yallawalla/SkyPulseIOC/schematic/RLH_04_04_20_PR-SkyPulse_KP.odt

# SW REVISION LEVEL HISTORY / OVERVIEW

SW release | SYS | EC20 | IOC | EM | DL | FSW | | BOOTUTIL PKG | Change request
| | | | | | TX | RX
/ | 0.1.0 | 0.7.0 | 0.11 | 0.6.0 | 0.1.0 | 0.1 | 0.1 | 1.0.0 | Develop. phase (20. 09. 17)
| 0.4.0 | 0.8.0 | 0.13 | 0.6.0 | 0.2.0 | 0.2 | 0.2 | | Develop. phase (27. 03. 18)
| 0.5.7 | 0.8.6 | 0.20 | 0.8.0 | 0.3.0 | 0.2 | 0.2 | | Develop. phase (20. 08. 18)
| 0.6.17 | 0.8.16 | 0.23 | 0.10.0 | 0.4.0 | 0.2 | 0.2 | | Develop. phase (23. 11. 18)
| 0.7.12 | 0.8.19 | 0.26 | 0.11.0 | 0.4.5 | 0.3 | 0.2 | | Develop. phase – release for testing house (18. 03. 19)
| 0.8.57 | 0.8.31 | 0.29 | 0.14.2 | 0.4.13 | 0.3 | 0.2 | | Develop. phase (02. 07. 19)
1.0. | 1.0.1 | 1.0.0 | 1.00 | 1.0.0 | 1.0.0 | 1.0.0 | 1.0.0 | 1.0.2 | Official production release (27. 8. 19)
1.1. | 1.0.3 | 1.0.0 | 1.00 | 1.0.0 | 1.0.0 | 1.0.0 | 1.0.0 | 1.0.2 | I-8674
1.2. | 1.0.4 | 1.0.3 | 1.00 | 1.0.0 | 1.0.0 | 1.0.0 | 1.0.0 | 1.0.2 | I-8768
1.3 | 1.0.5 | 1.0.3 | 1.00 | 1.0.0 | 1.0.0 | 1.0.0 | 1.0.0 | 1.0.2 | I-8746, I-9048
1.4 | 1.0.6 | 1.0.8 | 1.00 | 1.0.0 | 1.0.0 | 1.0.0 | 1.0.0 | 1.0.2 | I-9112, I-9148
1.5 | 1.0.7 | 1.0.8 | 1.0.1 | 1.0.0 | 1.0.0 | 1.0.0 | 1.0.0 | 1.0.2 | I-9498
1.6 | 1.1.4 | 1.0.22 | 1.0.5 | 1.0.0 | 1.0.10 | 1.0.0 | 1.0.0 | 1.0.2 | I-9369, I-9614, I-9528
1.7 | 1.1.5 | 1.0.22 | 1.0.5 | 1.0.0 | 1.0.10 | 1.0.1 | 1.0.1 | 1.0.2 | I-9731, I-9871
1.8 | 1.2.1 | 1.1.0 | 1.0.5 | 1.0.0 | 1.0.10 | 1.0.1 | 1.0.1 | 1.0.2 | I-10136
1.9 | 1.3.3 | 1.1.0 | 1.0.5 | 1.0.0 | 1.0.12 | 1.0.1 | 1.0.1 | 1.0.2 | I-9747
1.10 | 2.1.0 | 1.1.8 | 1.0.5 | 1.0.0 | 1.0.12 | 1.0.1 | 1.0.1 | 1.0.2 | I-9925
1.11 | 2.2.0 | 1.1.8 | 1.0.5 | 1.0.0 | 1.0.12 | 1.0.1 | 1.0.1 | 1.0.2 | I-10302
1.12 | 2.3.0 | 1.1.8 | 1.0.5 | 1.0.0 | 1.0.12 | 1.0.1 | 1.0.1 | 1.0.2 | I-10373
1.13 | 2.4.8 | 1.1.8 | 1.0.6 | 1.0.0 | 1.0.16 | 1.0.1 | 1.0.1 | 1.0.2 | I-10397, I-10611, I-10295
1.14 | 3.0.8 | 1.2.4 | 1.0.7 | 1.0.0 | 1.0.16 | 1.0.1 | 1.0.2 | 1.0.2 | I-10730, I-10804
1.15 | 3.1.1 | 1.2.4 | 1.0.7 | 1.0.0 | 1.1.0 | 1.0.1 | 1.0.2 | 1.0.2 | I-11057
1.16 | 3.2.0 | 1.3.1 | 1.0.7 | 1.0.0 | 1.1.0 | 1.0.1 | 1.0.2 | 1.0.2 | I-11229
1.17 | 3.3.3 | 1.3.1 | 1.0.8 | 1.0.0 | 1.1.0 | 1.0.1 | 1.0.2 | 1.0.2 | I-11458
1.18 | 3.4.2 | 1.3.1 | 1.0.8 | 1.0.0 | 1.1.0 | 1.0.1 | 1.0.2 | 1.0.2 | I-11903
1.19 | 3.4.2 | 1.3.4 | 1.0.8 | 1.0.0 | 1.1.0 | 1.0.1 | 1.0.2 | 1.0.2 | I-11986
1.20 | 3.5.2 | 1.3.6 | 1.1.0 | 1.0.0 | 1.1.0 | 1.0.1 | 1.0.2 | 1.0.2 | I-12436
1.21 | 3.6.0 | 1.3.6 | 1.1.0 | 1.0.0 | 1.1.0 | 1.0.1 | 1.0.2 | 1.0.2 | I-12741
1.22 | 3.7.0 | 1.4.1 | 1.1.0 | 1.0.0 | 1.1.0 | 1.0.1 | 1.0.2 | 1.0.2 | I-12964
1.23 | 3.8.0 | 1.4.1 | 1.1.0 | 1.0.0 | 1.1.0 | 1.0.1 | 1.0.2 | 1.0.2 | I-13254
1.24 | 3.9.0 | 1.4.1 | 1.X.X | 1.0.0 | 1.1.0 | 1.0.1 | 1.0.2 | 1.0.2 | I-13217

# SYSTEM MODULE (SYS), id. 99828

SW version | Development version 0.1.0
Previous official version | /
Change request | Project status on 20. 09. 2017

Filename

Modules:
shared-backend.so

shared-frontend.so
shared-listed_components.so
shared-syscontroller.so
Plugins:
PluginModuleSkyPulseFrontend.so
PluginModlueSkyPulseMain.so
PluginModuleSkyPulseService.so

PluginModuleSkyPulseSysController.so
Resources:
BasicKeyboard.qml, BasicKeyboardButton.qml, BasicSlider.qml, BootChooser.qml, BootScreenStateMachine.qml, BootSlider.qml, BusyIndicator.qml, CodesParser.qml, ControlsScreen.qml, Error.qml, ErrorParser.qml, Main.qml, MainScreen.qml, MainScreenStateMachine.qml, MainScreenTest.qml, MainStatusBar.qml, Notification.qml, PatternUnlocker.qml, ProcedureGroupsMenuDelegate.qml, ProcedureMenuDelegate.qml, ProceduresScreen.qml, QuickSettingsScreen.qml, SelectDateDelegate.qml, SelectLanguageDelegate.qml, SelectTimeDelegate.qml, ServiceConsoleMenuDelegate.qml, ServiceMenuDelegate.qml, ServiceScreen.qml, ServiceScreenStateMachine.qml, ServiceSubMenuDelegate.qml, SettingsController.qml, SettingsMenuDelegate.qml, SettingsSoundVolumeDelegate.qml, SettingsSubMenuDateDelegate.qml, SettingsSubMenuDelegate.qml, SettingsSubMenuLanguageDelegate.qml, SettingsSubMenuTimeDelegate.qml, SoftwareInfoDelegate.qml, SoundPlayer.qml, TestMainScreen.qml, TestSimpleButton.qml, TestSimpleDialog.qml, TestSimpleSlider.qml, UIStyle.qml, VideoPlayer.qml,

procedures_data.json, acn.json, service_menu.json, settings_menu.json
Executable:
skypulseapp
Build environment
Compiler | arm-buildroot-linux-gnueabi-g++ 4.8.5
Middleware | Qt Library 5.7.0
Other development tool / version changed? | No

Issue / Task | Implementation / Comment | Status (development / release)
Set-up framework for main application. | Logic for procedures menu/steps/modes is implemented. Various plugins for backend (C++) to frontend (qml) communication and vice versa are implemented. Some of the visual components of the GUI are implemented – console controller, slider, central dial control, video player, sound settings, display of errors/warnings. Additionally, handling of debug messages and timeouts is implemented. Top-level state machine framework for handling device operating states is implemented. Support for various text translations (languages) is added. | Development phase
Implement framework for handling the logic for settings and procedures for transitions between menus and modes (including service mode). | Shared backend module implemented. It includes settings controller and logic for different procedures - menu/submenu changes, steps, transitions between modes. Controller for service console is also implemented.
Implement framework for handling the logic for GUI components. | Frontend shared module implemented. It includes frontend timer logic and model (console controller with basic keyboard, boot chooser and slider, codes and error parser, date/time controller, quick settings menu, logic and graphics for handling notifications, sound player, service menu).
Implement communication interface for communication with all peripheral modules via CAN and interface for handling with all I/O data. | CAN raw socket communication is implemented. Controller for handling different communication events (i.e., energy measurement, parameters, states, temperature and version) for EC20 module is implemented. Controller for handling different communication events (i.e., energy measurements, parameters, states) for EM module is implemented. Controller for handling different communication events (i.e., footswitch, spray (water/air), states) for IOC module is implemented.
Support for read/write operations and for manipulating with all non-volatile data. | Shared listed components library implemented. It consists of a parser and resource controller for handling all read/write operations (with backup and salted hash protection).
GUI part:
GUI dial control | Supports parameter up/down control, interval markers, discrete value parameter setting (this can be used for non-linear behavior)
GUI up/down button | Up/down button with autorepeat feature (may be used instead of dial up/down controls)
GUI slider | Slider control, based on QML Slider
GUI sound | .wav sound player, based on Qt class QAudioOutput
GUI video player | Video file player, based on QML MediaPlayer and QML VideoOutput. Supports play, pause, rewind, seek.
GUI virtual keyboard | The SkyPulse virtual keyboard is based on Qt multilingual virtual keyboard. Due to licensing issues, it is implemented as a separate program, that communicates with the GUI application through the inter-process communication channels.

SW version | Development version 0.4.0
Previous official version | Development version 0.1.0
Change request | Project status on 27. 03. 2018

Filename

Modules:
shared-backend.so

shared-frontend.so
shared-listed_components.so
shared-syscontroller.so

Plugins:

PluginModuleSkyPulseFrontend.so
PluginModlueSkyPulseMain.so
PluginModuleSkyPulseService.so

PluginModuleSkyPulseSysController.so
Resources:
BasicKeyboard.qml, BasicKeyboardButton.qml, BasicSlider.qml, BootScreenStateMachine.qml, BusyIndicator.qml, CalibrationScreen.qml, CalibrationScreenStateMachine.qml, CalibrationSlider.qml, CentralDropDownMenu.qml, ChangeUserAuthorization.qml, ControlsScreen.qml, DataLoggerController.qml, EnergymeterCalibrationScreen.qml, EnergymeterCalibrationScreenStateMachine.qml, Error.qml, ErrorLogDelegate.qml, ErrorLogDelegateWithSeparator.qml, ErrorLogDelegateWithoutSeparator.qml, ErrorParser.qml, FavoriteDelegate.qml, FavoriteFolderDelegate.qml, HandpieceMenuDelegate.qml, LeftDropDownMenu.qml, Main.qml, MainBar.qml, MainScreen.qml, MainScreenOverlay.qml, MainScreenStateMachine.qml, MainScreenTest.qml, MainStatusBar.qml, ModifyButton.qml, Notification.qml, PatternUnlocker.qml, ProcedureGroupsExpertMenuDelegate.qml ProcedureGroupsMenuDelegate.qml, ProcedureMenuDelegate.qml, ProcedureModeMenuDelegate.qml, ProcedureStepMenuDelegate.qml, ProceduresScreen.qml, PulseCounterDelegate.qml, PulseCountersqml, PulseMenuDelegate.qml, QuickSettingsScreen.qml, RightDropDownMenu.qml, SelectDateDelegate.qml, SelectLanguageDelegate.qml, SelectTimeDelegate.qml, SelectTimerDelegate.qml, SelfTestScreen.qml, SelfTestScreenStateMachine.qml, ServiceClearCalibrationDelegate.qml, ServiceClearEnergymeterCalibrationDelegate.qml, ServiceConsoleMenuDelegate.qml, ServiceDeleteCalibrationDelegate.qml, ServiceInfoDelegate.qml, ServiceMenuDelegate.qml, ServiceModalitiesDelegate.qml, ServicePulseCounterDelegate.qml, ServiceScreen.qml, ServiceScreenStateMachine.qml, ServiceSubMenuDelegate.qml, SettingsBrightnessDelegate.qml, SettingsMenuDelegate.qml, SettingsPresentationVideoDelegate.qml, SettingsSoundVolumeDelegate.qml, SettingsSubMenuDateDelegate.qml, SettingsSubMenuDelegate.qml, SettingsSubMenuLanguageDelegate.qml, SettingsSubMenuTimeDelegate.qml, SettingsSubMenuUserDelegate.qml, SettingsSystemTimeoutsMenuDelegate.qml, SoundPlayer.qml, SysRegulatorController.qml, SystemInfo.qml, SystemInfoDelegate.qml, SystemTimeoutsDelegate.qml, TestMainScreen.qml, TestMainScreen2.qml, TestSimpleButton.qml, TestSimpleDialog.qml, TestSimpleSlider.qml, UIStyle.qml, VideoPlayer.qml, WavelengthMenuDelegate.qml,

handpieces_data.json, procedures_data.json, pulses_data.json, regimes_data.json, wavelengths_data.json, calibration_log.json, data_log.json service_menu.json, settings_menu.json
Executable:
skypulseapp
Build environment
Compiler | Arm-buildroot-linux-gnueabi-g++ 5.4.0
Middleware | Qt Library 5.9.2
Other development tool / version changed? | No

Issue / Task | Implementation / Comment | Status (development / release)
New Qt Lib version | Changes introduced with new version: - Qt library source files have been modified, so that the '/dev/null' device may be specified as input device (input devices are keyboard, mouse and touch screen). If '/dev/null' is specified as input device, then the Qt library assumes, that the respective device is not connected and does not try to detect it, nor does it report any errors. - Memory free error message on exit does not appear with Qt 5.9.2. | Development phase

Implement framework for flash and laser calibration procedure as well as energymeter calibration

Implemented flash / laser / energymeter calibration screen in Service Screen. Enabled input/output energy logging to screen and external storage device.

Also implemented state machine for calibration flow control for various pulse modes. Calibration data saving with hash security implemented. Also, the calibration data can be cleared from service screen (energymeter and flash / laser separately). Energymeter and flash / laser calibration use the same interface class - new pulse modes (and their properties) can be easily added.

Added utilities to facilitate data fitting for calibration (currently linear and polynomial least-squares fit methods applicable).

Also started working on regulation controller framework.
Implement framework for favorites handling (display, selection, saving, loading and various operations, i.e. copy, paste, delete...) | Implemented dropdown menu for favorites display and exposed user operations that can be performed on favorites - favorites state machine implemented.
Enable user authorization password change | Enabled authorization password changed option from pulldown menu in Main Screen. Also added functionality to reset authorization password via reset code input.
Implement controls screen according to input specifications. | Implemented controls screen for Erbium (Center energy dial, Repetition dial, Water and Air dial) and Diode (Center power dial, PulseOn time dial, PulseOff time dial). User timer dial also implemented.
Enable non-volatile logging support for various data (calibration, measurements, errors, etc...) | Framework for data logging implemented - enabled saving calibration, error log and energy measurements data. Visual element and logic for error log implemented - user can load and view logged errors. Added error parser support for DL (Diode Laser). Error parser controller updated - errors grouped by Erbium / Diode / SYS errors.
Enable user handpiece / wavelength / pulse mode selection | Implemented main bar GUI component that enables selection of various wavelengths, pulse modes and handpieces. Also implemented framework for aforementioned data handling and loading. Additionally main status bar now shows selected handpiece / wavelength / pulse mode. Updated .json configuration data.
Enable procedures selection | Implemented framework for procedure menus handling, i.e. loading default and user procedures, saving user procedures. Preset select indicator shown if neither default or user procedure parameters are selected. Added expert menu selection button. Updated .json procedures configuration data.
Add user timer functionality to main controls screen | Implemented timer control which enables time selection with count-down during laser emission state. After timer elapses, the device transitions from emission state to ready state.
Implement framework for self-test procedure | Self-test procedure framework implemented. Currently supports only Erbium self-test.
Service mode implementation for device maintenance | State machine and service controller for service handling implemented. Added DL console support.
Add graphics based on designer's proposal | Various graphic icons and images added.
Implement Erbium preheating parameters controller and main pwm frequency controller. Add support for cooling liquid temperature query. | Implemented.
Implement controller for Diode Laser (DL) | DL state controller implemented. Also implemented controller for setting parameters (pulse off / on time and power).
Enable distinction between Erbium and Diode operating mode | Implemented operation mode controller.
Service menu | - Added info screen. - Added pulse counters with reset button.
Command line processing | Various version info can be displayed on standard output.
Application exit | It is possible to exit the application from the GUI.
Settings menu | - Added pulse counters. - Added display brightness setting. - Added ready-to-standby and standby-to-low-power timeout settings. - Added user name setting.
Virtual keyboard | Added multilingual virtual keyboard with selection list and sound volume control. Virtual keyboard added as a subproject to the main project.
Application presentation video | The application presentation video is played automatically on application startup (autoplay may be disabled by the user). The video can also be played on user request from the GUI.
User authorization | - User and service authorization is required only once in a session. - Added master password, that resets user password pattern to default.
Introduced classes UserSettings and UserSettingsWorker | - The two classes manage the user-modifiable settings (language, sound volume, user name, ...). User settings have been moved from other classes to this class in order to separate the variable user setting values from constant data. - The variable user settings are now saved in a dedicated json file 'user_settings.json'.
Procedure presentation videos | Each procedure may have its presentation video than can be played via the Quick Settings panel.

SW version | Development version 0.5.7
Previous official version | Development version 0.4.0
Change request | Project status on 20. 08. 2018

Filename

Modules:
shared-backend.so

shared-frontend.so
shared-listed_components.so
shared-syscontroller.so

shared-resources_manager.so

Plugins:

PluginModuleSkyPulseFrontend.so
PluginModlueSkyPulseMain.so
PluginModuleSkyPulseService.so

PluginModuleSkyPulseSysController.so

PluginModuleSkyPulseResources.so
Resources:
BasicKeyboardButton.qml, BasicKeyboard.qml, BasicSlider.qml, BootChooser.qml, BootScreenStateMachine.qml, BootSlider.qml, BusyIndicator.qml, CalibrationScreen.qml, CalibrationScreenStateMachine.qml, CalibrationSlider.qml, CentralDropDownMenu.qml, ChangeDeviceConfiguration.qml, ChangeUserAuthorization.qml, ClosedLoopController.qml, CodesParser.qml, ControlsScreen.qml, DataLoggerController.qml, EnergymeterCalibrationScreen.qml, EnergymeterCalibrationScreenStateMachine.qml, ErrorLogDelegate.qml, ErrorLogDelegateWithoutSeparator.qml, ErrorLogDelegateWithSeparator.qml, ErrorParser.qml, Error.qml, ExpertServiceMeasurements.qml, ExpertServiceWaterTemperatureRegulation.qml, FavoriteDelegate.qml, FavoriteFolderDelegate.qml, HandpieceMenuDelegate.qml, LeftDropDownMenu.qml, MainBarButtonsExtension.qml, MainBar.qml, Main.qml, MainScreenOverlay.qml, MainScreen.qml, MainScreenStateMachine.qml, MainStatusBar.qml, ModifyButton.qml

Notification.qml, PatternUnlocker.qml, ProcedureGroupsExpertMenuDelegate.qml, ProcedureGroupsMenuDelegate.qml, ProcedureMenuDelegate.qml

ProcedureModeMenuDelegate.qml, ProcedureSingleMenuDelegate.qml, ProceduresScreen.qml, ProcedureStepMenuDelegate.qml, PulseCounterDelegate.qml,

PulseCounters.qml, PulseMenuDelegate.qml, PulseSubMenuDelegate.qml, QuickSettingsScreen.qml, ResourcesManager.qml, RightDropDownMenu.qml, RightDropDownSubMenu.qml, SelectDateDelegate.qml, SelectLanguageDelegate.qml, SelectTimeDelegate.qml, SelectTimerDelegate.qml, SelfTestLogDelegate.qml, SelfTestScreen.qml, SelfTestScreenStateMachine.qml, ServiceCalibrationInfoDelegate.qml, ServiceConsoleMenuDelegate.qml, ServiceDeleteCalibrationDelegate.qml, ServiceInfoDelegate.qml,

ServiceMenuDelegate.qml, ServiceProcedureGroupsToggle.qml,

ServiceProceduresToggle.qml, ServicePulseCounterDelegate.qml, ServiceScreen.qml, ServiceScreenStateMachine.qml, ServiceSubMenuDelegate.qml, SettingsBrightnessDelegate.qml, SettingsController.qml, SettingsMenuDelegate.qml, SettingsPresentationVideoDelegate.qml, SettingsSoundVolumeDelegate.qml, SettingsSubMenuDateDelegate.qml, SettingsSubMenuDelegate.qml, SettingsSubMenuLanguageDelegate.qml, SettingsSubMenuTimeDelegate.qml, SettingsSubMenuUserDelegate.qml, SettingsSystemTimeoutsMenuDelegate.qml, SettingsTutorialDelegate.qml, SlideShow.qml, SoundPlayer.qml, SystemInfoDelegate.qml, SystemInfo.qml, SystemTimeoutsDelegate.qml, UIStyle.qml, VideoPlayer.qml, WavelengthMenuDelegate.qml, configuration_data.json, handpieces_data.json, procedures_data.json, pulses_data.json, regimes_data.json, wavelengths_data.json, error_list.json, calibration_log.json, data_log.json service_menu.json, settings_menu.json
Executable:
skypulseapp, regcontr, vkbd
Build environment
Compiler | Arm-buildroot-linux-gnueabi-g++ 5.4.0
Middleware | Qt Library 5.9.2
Other development tool / version changed? | No

Issue / Task | Implementation / Comment | Status (development / release)
Add additional features to service mode for development purposes | Expert service implemented and can be enabled using appropriate preprocessor flag. This enables various features such as cooling liquid regulation, session counter and output / input energy measurements. Added service console color filter. Implemented "Control" key support for service keyboard and made some minor visual modifications. | Development phase
Enable support for burst pulses | Implemented support for burst pulse modes in backend and exposed subpulse/burst mode selection to user. Implemented framework to handle burst messages data over CAN.
Add identification support for various diode modules and enable support for dual diode module operation | Implemented identification framework for supported diode modules. Modules are identified in self-test procedure and menus are populated based on the identified modules. Implemented logic for dual diode parameters calculation and data handling (send / receive CAN data).
Handle missing or invalid resource value for treatments presets | Implemented handler for invalid or missing resource value, i.e., if unavailable handpiece is requested, next applicable handpiece is selected. If none available, error is displayed. Analogous logic for invalid pulse selection also implemented.
Enable autodetection of USB storage device | Autodetection of USB storage device implemented, user is now correctly notified when storage device is connected.
Enable error log sorting by time and update SYS errors database | Error log now sorted by time occurrence. New SYS errors are implemented in code and added to SYS errors database.
Add SW version query support for all sub-modules | Added SW version query support for input / output controller (IOC), energymeter (EM) and diode laser (DL).
Decouple basic and advanced service support | Basic and advanced service mode now decoupled. Advanced service mode additionally enables console access to IOC, EC20 and DL. Basic or advanced service mode entry is based on appropriate password input.
Reimplement user timer to enable control / protective architecture | User timer re-implemented. The timer has a resolution of 10 msec and sends new value to EC20 (or DL) on every emission request.
Implement resources manager to handle various configurations of the device | Implemented new module that handles all resources based operations. Resources manager implemented on separate thread. It enables all configuration based operations of the device (available wavelengths, pulses, regime data limits, etc...) and unlocking / locking of procedure groups and procedures.
Upgrade flash / laser calibration procedure in order to calibrate pulse modes at arbitrary repetition | Calibration procedure for flash / laser now supports calibration for arbitrary repetitions.

Implement framework for laser output regulation control

Regulation control decoupled from the main application instance / process and priority of the regulation control process elevated on OS level. The process receives all relevant data from the main application through shared memory mechanism. Furthermore, the shared data is protected by hash and re-checked everytime it is modified. The main process communicates with the regulation process via standard input / output.

Setting the operating parameters and fitting of calibrated data re-implemented. Eigen header library is added for fitting purposes, i.e. using matrices operations for least-squares fitting.
Enable on-demand retrieving of last energymeter energy report | Implemented.
Re-implement self-test procedure to test safety loop only | Self-test procedure re-implemented. If self-test fails, the fail reason is logged. In cases where IOC fails, the main application window cannot be entered. Contrary, service mode can be entered in order to troubleshoot the error.
Reorganize pop-up message buttons for power-off / service routines | Implemented. From main application window, the device is now powered-off by confirming the pop-up message. The device can trigger service routine by pressing the service button, which is located on the right-most part of the pop-up (analogous for service to main window transition).
Register external fonts to the application | External fonts registered in order to be used within the application.

SW version | Development version - 0.6.17
Previous official version | Development version 0.5.7
Change request | Project status on 23. 11. 2018
Filename | Modules: shared-backend.so, shared-frontend.so, shared-listed_components.so, shared-syscontroller.so, shared-resources_manager.so Plugins: PluginModuleSkyPulseFrontend.so, PluginModlueSkyPulseMain.so, PluginModuleSkyPulseService.so, PluginModuleSkyPulseSysController.so, PluginModuleSkyPulseResources.so Executables: skypulseapp (main process - all UI files, configurations and settings are embedded here), regcontr (regulator control process), vkbd (virtual keyboard process)
Build environment
Compiler | Arm-buildroot-linux-gnueabi-g++ 5.4.0
Middleware | Qt Library 5.9.2
Other development tool / version changed? | No

Issue / Task | Implementation / Comment | Status (development / release)
Implement control for laser pointer intensity control. | Implemented control for setting laser pointer intensity for Er:YAG and diode laser. User can set pointer intensity via settings pull-down menu. Control is applicable only if the corresponding laser is available on the device. | Development phase - testing house
Implement framework for user-related maintenance procedures. | Time (in days) from last user maintenance is monitored - user receives notification for maintenance due.

Enable favorites export / import feature.

Favorites export / import implemented. Works recursively thus also exporting / importing all sub-folders and sub-files. Favorites and last expert settings are now loaded optionally (separated from configurations / settings loading). The device is still operable if loading is unsuccessful. Non-encrypted resource load / save routine implemented. Used for saving / loading resources that are not specific to a device (e.g. favorites). Also added GUI support for export / import.

Implemented USB storage controller as a separate class that is used for exporting / saving various data to external USB (including favorites).
Refresh operating parameters shown on-screen just before sending them to other sub-modules (via CAN). | Parameters on-screen are now refreshed when user presses ready button. The displayed parameters and sent parameters are taken from the same memory address.
Enable calibration of individual pulse modes in service mode. | Pulse modes can now be added to or removed from the calibration routine according to service user preferences (energymeter and flash / laser calibration). Added last calibration information to each pulse mode (energymeter and flash / laser calibration). Flash and laser calibration for selected pulse mode is unavailable if energymeter calibration for corresponding pulse mode is not valid.
Enable logging various system data in expert service mode. | Implemented service logging controller that "listens" to the user input in EC20 console and gathers (and logs) pwm, pln, prt, input / output energy and temperature data.
Add support for various diode modules calibration (in service mode). | Implemented graphical interface and controller for DL calibration according to the DL calibration protocol. Implemented DL service state machine. Applicable in service mode only.
Implement emission / action sound playing. | Implemented dedicated class for low-latency sound playing that is used only for emission sounds. As this is a critical sound, it cannot be muted. Also disabled muting for error and warning pop-up messages (using non-critical sound player).
Start working on unit tests. | Started implementation of unit test for SW units. Implemented unit tests for protected data save / load procedure. Implemented unit test for authorization handler.
Regulator control for Er:YAG energy output should only be active when using Er:YAG mode. | Implemented functionality to enable / disable Er:YAG regulator control on demand. Added regular pinging to detect potential regulator control process errors. Also implemented PI feedback controller as a separate class and added some additional safety features (i.e. energy input / output control with immediate response by setting error state from regulator control process).
Add support for pump and fan boost mode control. | Updated I/O controller communication protocol. Pump boost and fan boost can now be enabled on demand via IOC state controller implementation. Fan boost is enabled for specific EC20 error (auxiliary transformer overheating).
Enable energymeter pinging when using Er:YAG mode. | Implemented routine for energymeter ping in ready mode. Energymeter must be alive in order to detect spurious pulses.
Add listener controller for receiving and handling pulse preheating energy reports. | Implemented.
Add EC20 on demand setup support. | Added support for manually triggering EC20 setup in service mode.
Add wavelength warning before user enters ready mode. | Warning added. User interaction required. Warning also added to service mode.
Handle laser connector ejection during user application run-time. | Laser connector check added after self-test check and before entering main user application mode. Connector ejected error is now detected during user application run-time. Also handled energymeter crowbar error; I/O controller reports the same error for connector ejection and energymeter crowbar error. Error type is now detected.

SW version | Development version - 0.7.12
Previous official version | Development version 0.6.17
Change request | Project status on 18. 03. 2019
Filename | Modules: shared-backend.so, shared-frontend.so, shared-listed_components.so, shared-syscontroller.so, shared-resources_manager.so Plugins: PluginModuleSkyPulseFrontend.so, PluginModlueSkyPulseMain.so, PluginModuleSkyPulseService.so, PluginModuleSkyPulseSysController.so, PluginModuleSkyPulseResources.so Executables: skypulseapp (main process - all UI files, configurations and settings are embedded here), regcontr (regulator control process), vkbd (virtual keyboard process)
Build environment
Compiler | Arm-buildroot-linux-gnueabi-g++ 5.4.0
Middleware | Qt Library 5.9.2
Other development tool / version changed? | No

Issue / Task | Implementation / Comment | Status (development / release)
Add recovery mode to reset the device configuration data in case of files corruption. | All critical files are backuped and their integrity verified using a hash checksum. In cases when non-recoverable corruption is detected, the application now offers the user to re-enter the configuration code in order to reset the device. | Development phase – release for testing house
Enable IOC pinging when using diode laser mode. | Implemented routine for IOC ping in ready mode. IOC must be alive in order to detect spurious pulses. Pinging is performed via the version query.
Implement SQL database framework for logging and recalling user-defined laser procedures. | History database framework implemented. Custom sessions can now be created and logged to the SQL database.
Add device diagnostic screen to service mode. | Service diagnostic screen implemented - displaying cooling water temperature, cooling water flow, pump PWM, fan PWM, IGBT temperature, main transformer temperature and 24V transformer temperature.
Modify diode calibration procedure according to the updated protocol between SYS and DL. | Diode calibration procedure modified according to the DL specifications.
Implement fan boost control. | Fan boost command sent to IOC in cases when EC20 temperature exceeds maximum allowed value. Fan boost level depends on predicted input power (based on calibration). Fan boost level can be mapped to a user-defined input power threshold (available in expert service mode only). Also implemented charger (EC20) overheating check upon loading the main user application.
Add SWEEPS pulse mode support. | Implemented framework for SWEEPS pulse handling (consisting of two pulses in a burst). Implemented dynamic control of delay between pulses (delay, delay range and delay step variables). Implemented SWEEPS calibration based on supposition that double pulse output energy equals 2 * single pulse output energy. SWEEPS calibration logger also implemented. Calibration model fitting updated (also updated Eigen libraries). Updated default procedures and parameters for SWEEPS also updated. Also added wavelength, handpiece and pulse mode checking when loading operating parameters.
Update burst pulses control protocol according to the EC20 specifications. | Protocol updated. Now each pulse length in a burst can be set independently (up to 5 pulses).
Set and display average power instead of energy per pulse for certain pulse modes. | Implemented. Showing and setting average power instead of energy per pulse for pulse modes with energies equal to or below 40 mJ (i.e. endo modes).
Perform energymeter calibration check. Calibration of individual pulse mode must be valid for calibrated energymeter only. | Updated energymeter status controller. Energymeter reports its serial number on SYS demand. Each calibrated pulse mode is paired with energymeter serial number. In cases where the pulse mode serial number and energymeter serial number mismatch, an error is shown and ready state cannot be entered.
Extend service keyboard character set. | Implemented. Added anti-windup mechanism to the PI regulator. Fixed a bug for data integrity check when sharing the parameters from main application to regulator process.
Unify error format for all (sub)modules, | Error format unified for SYS, IOC, EC20, EM and DL errors. Error origin is now encoded into the error itself.
Limit the output of the feedback controller for output energy regulator. | Implemented.
Unit tests | Implemented unit test for parameters controller (wavelength, handpiece, pulse mode, energy, power, repetition, pulse times, etc...).

SW version | Development version - 0.8.57
Previous official version | Development version 0.7.12
Change request | Project status on 02. 07. 2019
Filename | Modules: shared-backend.so, shared-frontend.so, shared-listed_components.so, shared-syscontroller.so, shared-resources_manager.so Plugins: PluginModuleSkyPulseFrontend.so, PluginModlueSkyPulseMain.so, PluginModuleSkyPulseService.so, PluginModuleSkyPulseSysController.so, PluginModuleSkyPulseResources.so Executables: skypulseapp (main process - all UI files, configurations and settings are embedded here), regcontr (regulator control process), vkbd (virtual keyboard process)
Build environment
Compiler | Arm-buildroot-linux-gnueabi-g++ 5.4.0
Middleware | Qt Library 5.9.2
Other development tool / version changed? | No

Issue / Task | Implementation / Comment | Status (development / release)
Implement framework parallel favorites handling, used for importing default presets. | Implemented (code name Advanced Favorites) Default presets can be imported using an external storage device (i.e. USB) through the user interface. Imported files are hash-protected to prevent unauthorized imports. Advanced favorites can only be renamed or deleted. Favorite entry now supports user-selectable icon from the device icon collection. | Development phase
Couple energy meter type with device configuration to prevent / allow various energy meter and configuration combinations. | Implemented handler for querying energy meter type from EM firmware (via CAN interface). Based on reported energy meter type and the active configuration, the availability of Er procedures are updated during run-time. Added the possibility to disable procedures for non-valid energy meter type / configuration combination (sales feature).
Output energy limit on UI should be equal for all devices and not governed by flash / laser calibration limits. | The display of output energy limits are not affected by the device calibration limits. If the device cannot achieve the energy set by the user (as per calibration), a warning message is displayed. The device cannot enter emission state.

Implement framework for user procedures.

Framework for creating, modifying (renaming, parameters updating, etc...) and deleting editable user procedures implemented. User can now create custom procedure structure up to three levels deep. This can be done while in edit mode from home screen only. The procedure structure can be exported / imported to external storage device. The export / import actions are hash-protected to prevent unauthorized actions.

Additionally, the procedures can be enabled / disabled from the service screen under modalities preset .

Procedures with multiple steps keep track of next and previous available procedure - user can traverse between them using directional buttons.
Unify SWEEPS (dual pulse mode) pulse burst delay with Lightwalker devices. (SWR-84) | Implemented. The pulse burst delay is set from the beginning of the first pulse to the beginning of the second pulse (as set / seen by the user). The pulse burst delay parameter sent to EC20 is internally calculated in order to conform to the EC20 communication protocol.
Add support for setting the repetition rate to the diode mode. | Implemented. The diode can now show pulse on and pulse off time or pulse on time and repetition. This can be set as per user preference from the setting pull-down menu. Additionally, added support to toggle font size of energy and power value display in ENDO modes.
Er mode should show the marker on the repetition selection control, where the maximum output power can be achieved. | In Er mode, the repetition dial now shows a red tick, where maximum output power (energy * repetition) is achieved. Gives preference to energies, where power is equal (e.g. 30mJ * 15Hz is preferable to 15mJ * 30Hz).
Simplify calculation of time since last calibration for each pulse mode. | Implemented - seconds since epoch measured between "now" and the last calibration time for each pulse. Logging of calibration data updated.
Implement support for pulse counters based on attached laser head. | Pulse counters database (SQL) based on EM serial number implemented. The displayed pulse counter corresponds to the currently attached laser head.
Implement non-volatile, on-demand water flow logging control in service mode. | The water volume flow can be logged on service operator's demand (two independent, re-settable counters). The data is stored to permanent storage.
Implement energy sum counter for diode operating mode. | Implemented. Energy sum counter synchronized with countdown timer.
Add step-by-step tutorial for users that explains the basic GUI principles of the device. | Tutorial screen added. It is shown by default on startup and can be disabled by the user. The user can watch the tutorial at any time from the pull-down settings menu.
Enable availability toggling of handpieces in run-time. | Implemented in service mode. All handpieces that are applicable for the active configuration can be enabled / disabled from the service menu. Disabled handpieces are removed from the menu and thus cannot be selected.
Implement bank voltage controller. | Implemented. The reference bank voltage request can now be sent to EC20 module.
Query and store additional calibration information (bank voltage, EM serial number, cooling water temperature, etc...). (SWR-86) | During calibration, additional data is now queried and stored: bank voltage, EM serial number, cooling water temperature and SW version for all available modules). Reference voltage switching support added.

Prevent calibration of flash / laser using invalid energy meter reference. (SWR-83)

Calibrated energy meter serial number is stored and checked against currently attached energy meter - if the serial numbers mismatch, the flash / laser calibration cannot be performed. A warning is displayed. In such cases, energy meter calibration must be performed before calibrating the flash / laser.

Additionally, full check of serial number synchronization is performed before entering ready state (stored energy meter calibration serial number must match stored flash / laser calibration serial number, and both must match the serial number of the current attached laser head to enter ready state).
Account for handpiece transmission factor. | Implemented. Transmission factor is considered when calculating / displaying energy. The displayed on-screen energy takes the transmission factor of current handpiece into account.
Implement "use lower energy" notification (user feature). | Implemented. Based on calibration data, the device notifies that the user-selected output energy cannot be realized. User must reduce the set energy within bounds to enter ready state.
Preheating parameters can vary between pulse modes. Add support for setting different preheat parameters based on pulse mode. | Implemented. Each pulse mode can have different preheating parameters.
Enable support for diode module calibration based on the selected handpiece. | DL module stores calibration for each handpiece. Diode calibration routine now consists of handpiece id selection which is reported to the DL module during calibration routine. The currently selected handpiece id is then sent to the DL module during normal operation. This enables the DL module to use proper calibration parameters.
Limit setting the pointer intensity to interval between 10-100% for Er. | The interval of the slider to set the pointer intensity in Er mode is set to 10-100%.
Update regulator controller for power-based regimes. | Regulator controller updated. The output for power based regimes (regimes, where the power is set instead of energy) is now limited by the (input / output) energy sum within a moving time window. The output of energy based regimes is limited by pulse input / output energy.
Implement SW upgrade / downgrade detection. | Implemented. At every boot, the application checks if upgrade / downgrade is performed. Upon detection, the device is automatically configured.
On-demand authorization code number (ACN) change. | Added settings menu entry which guides the user through the process of inputting new ACN.
Begin enabling GUI support for dual diode. | Re-implemented controls screen interface for less error prone handling of controls for various modes (Er, single Diode, dual Diode). Backend handler / controller for dual diode prepared.
Bug fix: emission sound should only be played in emission state of the laser device;. (SWR-85) | Fixed. When device detects a fatal error, the emission sound playback stops and error message is displayed.

SW version | Official release - 1.0.1
Previous official version | Development version 0.8.57
Change request | Project status on 27. 08. 2019
Filename | Modules: shared-backend.so, shared-frontend.so, shared-listed_components.so, shared-syscontroller.so, shared-resources_manager.so Plugins: PluginModuleSkyPulseFrontend.so, PluginModlueSkyPulseMain.so, PluginModuleSkyPulseService.so, PluginModuleSkyPulseSysController.so, PluginModuleSkyPulseResources.so Executables: skypulseapp (main process - all UI files, configurations and settings are embedded here), regcontr (regulator control process), vkbd (virtual keyboard process)
Build environment
Compiler | Arm-buildroot-linux-gnueabi-g++ 4.9.4
Middleware | Qt Library 5.9.2
Other development tool / version changed? | No

Issue / Task | Implementation / Comment | Status (development / release)
Add command line support for querying the device Pcode. | Added support for Pcode query. Running the application instance on the device with --sysuid argument returns the Pcode and terminates the application. | Official release
Change authorization pattern to comply with the operator's manual (OM) and add on demand lock. (SWR-91) | Authorization pattern changed to match the OM default value. Additionally, the device locks on user's demand or when standby-to-low-power timer expires (if enabled).
Lower the output energy value and warn the user if requested output energy is too high. | Implemented. If requested energy is too high (based on last calibration for each pulse mode), a warning appears and the output energy value is reduced to closest lower energy that can still be achieved.
Implement independent pulse counter logging for: user counters, flash / laser / chamber counters and total pulse counter. | Implemented. User counters can be reset by the user. Flash / laser / chamber counters can be reset independently by the maintenance operator. The counters are tied to the EM serial number. Total pulse counters cannot be reset - in this case all pulses throughout the device life-cycle are counted. Pulse counters are counted based on EC20 energy reports (regular pulses, i.e. id 0x147)
Fix authorization code number parsing. | Fixed bug in authorization code number parsing (masks for input code header were set incorrectly).
Update error list. | Updated.
Increase bank voltage for SWEEPS and SSP ENDO pulse modes. | Bank voltage for SWEEPS and SSP ENDO increased to 439V. Other pulse modes remain at 420V. Decoupled the calibration of SWEEPS and SSP ENDO pulse modes from other modes. The bank voltage in user mode is switched dynamically (depends on user pulse mode selection). Calibration interface modified accordingly. Additionally, the calibration time for SWEEPS was optimized by ~40%.
Decouple energy meter type from energy meter serial number. | Implemented and propagated throughout the application.
Implement buffer for real-time energy statistics calculation. | Buffering and energy statistics (input / output energy) calculation implemented for energy and power-based modes. Based on the calculated statistics, the regulation process is appropriately updated. Portions of the code re-implemented in methods to improve code readability and maintenance. Additionally, removed regulator controller version from UI - the controller version always paired with the main application version.
Turn off simmer current before triggering the crowbar if any error is detected during the energy regulation process. | Dual safety - if energy is out of bounds, the simmer current off request is made to EC20 and crowbar trigger request is made to IOC (5V line). Each request independently disables the laser emission.
Prevent swapping the laser head during operation. | In case the laser head connector error is detected during run-time, the device stops and the corresponding error is displayed. The user must turn off the device and repeat the self-test procedure in order to continue using the device.
Prevent the user to interact with the device in ready state while the operating parameters are being processed and delivered to CAN recipients. | Implemented. Before processing the set parameters in ready state, the UI controls for the parameters are disabled and re-enabled after.
Remove foot switch disconnected warning if foot switch is re-connected. | Implemented.
Emission timer elapsed sound not audible when disabling sounds. | Fixed. Timer elapsed sound cannot be fully disabled (sound value cannot be set less than 20%).
Display self-test stages for easier offline debugging in case of self-test errors. | Current self-test stage is now displayed on screen. Self-test errors are not logged to errors but have independent logging mechanism.
Implement handpiece replacement procedure and spray refill procedure. | Added entries to Device Maintenance in pull-down settings menu. Implemented state machines to handle both procedures.
Add unit tests. | Unit tests for the following SW units implemented: - statistics calculation - data fitting (partial, tested fractional polynomial fitting)

SW version | 1.0.3
Previous official version | 1.0.1
Change request | I-8674
Filename | Modules: shared-backend.so, shared-frontend.so, shared-listed_components.so, shared-syscontroller.so, shared-resources_manager.so Plugins: PluginModuleSkyPulseFrontend.so, PluginModlueSkyPulseMain.so, PluginModuleSkyPulseService.so, PluginModuleSkyPulseSysController.so, PluginModuleSkyPulseResources.so Executables: skypulseapp (main process - all UI files, configurations and settings are embedded here), regcontr (regulator control process), vkbd (virtual keyboard process)
Build environment
Compiler | Arm-buildroot-linux-gnueabi-g++ 4.9.4
Middleware | Qt Library 5.9.2
Other development tool / version changed? | No

Issue / Task | Implementation / Comment | Status (development / release)

Unify error messages handling and display for SYS, EC20, IOC, EM and DL.

Error messages grouped into three categories: fatal, critical and user. Fatal and critical error messages are unrecoverable during the current power-on cycle. User errors are recoverable during the current power-on cycle (e.g. emergency button pressed, door switch triggered, etc...). All errors codes are displayed in the "details" section of the error message. If diode module is not present, the SYS informs IOC and diode related errors are disabled.

Additionally, the messages from IOC that are related to spray functionality are ignored in the error handler and are handled separately.

Air line pressure drop is detected and the spray is disabled. If this happens during emission (while the user expects spray), the device transitions to ready state (emission stops) and the user is warned.

Under I-8674.
Add "reset settings to default" option. | Implemented. The device default settings can be restored by using a specific command: - error logs - pulse counters - user settings (sound, brightness, etc...) - history database All settings are non-critical for safe device operation.
Enable export / import of raw calibration data. | Raw calibration data can be exported and imported from the service menu. The data is hash protected (and salted) to prevent unauthorized modifications. Additionally, the display precision of energy meter gain factor is set to 3 digits (for manufacturing / device testing phase).
Update tutorial screen. | Updated. Added explanation of spray related functionalities.
Change password for advanced service screen access. | Password changed due to similarity with password to access regular service mode.
Order pulses by pulse length (ascending order). for energy meter and flash / laser calibration. | Implemented.

SW version | 1.0.4
Previous official version | 1.0.3
Change request | I-8768
Filename | Modules: shared-backend.so, shared-frontend.so, shared-listed_components.so, shared-syscontroller.so, shared-resources_manager.so Plugins: PluginModuleSkyPulseFrontend.so, PluginModlueSkyPulseMain.so, PluginModuleSkyPulseService.so, PluginModuleSkyPulseSysController.so, PluginModuleSkyPulseResources.so Executables: skypulseapp (main process - all UI files, configurations and settings are embedded here), regcontr (regulator control process), vkbd (virtual keyboard process)
Build environment
Compiler | Arm-buildroot-linux-gnueabi-g++ 4.9.4
Middleware | Qt Library 5.9.2
Other development tool / version changed? | No

Issue / Task | Implementation / Comment | Status (development / release)
CAN errors should be uniquely identified. | Implemented. Each CAN error corresponds to a unique error code and is thus displayed to the user. | Implemented and released with change I-8768.
Minimal selectable emission timer value should be 5 seconds. | Implemented. If user selects timer value of less than 5 seconds, a notification is displayed and the timer is set to 5 seconds.
Start implementation of operation data collector framework. | Implementation started. Currently the data collector is deactivated at compile time. For laboratory tests (non-official SW), the data collector is activated at compile time (collecting pulse id, repetition, user-requested energy, water temperature, input E, output E, session counter, session sum counter, reference counter)
If calibration is missing, don't report this as a critical error. Allow user to recover. | If calibration data is missing, the user is notified and cannot enter READY state, but can dismiss the message and remain in STANDBY state. Also, the presence of calibration data for each pulse mode is checked when user requests transition to READY.
If critical error arises due to user error, do not override user error with critical error. | When the device is in READY state and user error occurs, critical errors can consequently arise. For example if emergency button or door switch is triggered, the simmer current unexpectedly switches off. In such cases, the device enters ERROR state and user is given an option to recover. If critical or fatal error persists, the device stays in ERROR state.
Modify error display when no laser source is available. | Modified. Also added error code to Self-test log in cases when self-test fails. Modified user error display when laser module connector loses contact ("Check laser module connector").

SW version | 1.0.5
Previous official version | 1.0.4
Change request | I-8746, I-9048
Filename | Modules: shared-backend.so, shared-frontend.so, shared-listed_components.so, shared-syscontroller.so, shared-resources_manager.so Plugins: PluginModuleSkyPulseFrontend.so, PluginModlueSkyPulseMain.so, PluginModuleSkyPulseService.so, PluginModuleSkyPulseSysController.so, PluginModuleSkyPulseResources.so Executables: skypulseapp (main process - all UI files, configurations and settings are embedded here), regcontr (regulator control process), vkbd (virtual keyboard process)
Build environment
Compiler | Arm-buildroot-linux-gnueabi-g++ 4.9.4
Middleware | Qt Library 5.9.2
Other development tool / version changed? | No

Issue / Task | Implementation / Comment | Status (development / release)
Add handpiece listing for H14-NE (only for ENDO configuration), H14-NS and remove listing for R15 handpiece | Implemented. Handpiece H14-NE available in ENDO configuration only. H14-NS available in all current configurations. Handpiece R15 removed from all configurations. | Under I-8746
Disallow wavelength changes when a procedure is selected. | Procedure selection has a set of predefined parameters which can be modified. When parameters are modified, a visual indicator denotes this change. But changing the wavelength has more implications (tissue effect) and is therefore not allowed.
Disable setting the timer value in emission state. | Disabled. If timer pop-up is shown in ready state and the user presses the foot switch (requests emission state), the pop-up is automatically closed. Timer setting corresponds to the last valid selection (user explicitly sets the timer by pressing "Set" button).
Import default procedures via USB device and configuration code input. | When entering the configuration code which defines the device type, SW checks if USB device with the corresponding default procedures is present. If present, the procedures are imported automatically.
Log changes any procedure changes made by the user. | Implemented. Any modification of procedures by the user is logged. Log is updated in the following cases: user manually imports the procedures through the settings menu user changes any procedure through "edit mode" user inserts USB device with default procedures and inputs appropriate configuration code for the device (this resets the modification counter).
Continue implementation of operation data collector framework. | Implemented some optimizations. The data collector is still deactivated at compile time and not used in the final executable. | Under I-9048
In cases where timer is used, the emission stop requests (due to timer) must be synchronized. | Implemented synchronization handling of timer elapsed events. The request for state change from emission to ready is relayed to the real-time process and handled in-sync with the emission loop. Thus, the request is always sent at the appropriate time. To properly handle the timer requests in the user mode, pulse counting was reorganized. Pulse counting also reorganized in service mode (analogous to user mode). Also, the water compensation state (was not in use) was removed form the main state machine.
Modify the stabilization time before measured points are added to buffer during the calibration procedure. | Implemented. In case of energy meter calibration, the points are immediately added to the buffer, i.e. no stabilization time is required. This is necessary to truly synchronize the internal energy meter calibration with the external energy meter. For flash and laser calibration, the stabilization time is modified based on the following criteria: 1. specified minimum number of measurements or 2. number of measurements implicitly defined by repetition, whichever is greater.
Extend the range for energy selection during internal energy meter calibration. | Extended from 0-350mJ to 0-700mJ.
Optimize the closed-loop regulator control process. | Optimized. Corrections for output energy control are now performed based on normal distribution filtering mechanism. In cases of oscillatory changes of output energy (due to Er:YAG laser nature), the regulator reacts more conservatively. Also disabled checking of EM payload size for messages over CAN (due to variability in size).

SW version | 1.0.6
Previous official version | 1.0.5
Change request | I-9112
Filename | Modules: shared-backend.so, shared-frontend.so, shared-listed_components.so, shared-syscontroller.so, shared-resources_manager.so Plugins: PluginModuleSkyPulseFrontend.so, PluginModlueSkyPulseMain.so, PluginModuleSkyPulseService.so, PluginModuleSkyPulseSysController.so, PluginModuleSkyPulseResources.so Executables: skypulseapp (main process - all UI files, configurations and settings are embedded here), regcontr (regulator control process), vkbd (virtual keyboard process)
Build environment
Compiler | Arm-buildroot-linux-gnueabi-g++ 4.9.4
Middleware | Qt Library 5.9.2
Other development tool / version changed? | No

Issue / Task | Implementation / Comment | Status (development / release)
Due to increased laser efficiency, decrease the parameters of preheating laser pulses. | Preheating parameters decreased before initial (first) pulse and before each pulse, where applicable. Input energy for preheat pulses decreased by ~10%. | Under I-9112

SW version | 1.0.7
Previous official version | 1.0.6
Change request | I-9498
Filename | Modules: libshared-backend.so, libshared-frontend.so, libshared-listed_components.so, libshared-syscontroller.so, libshared-resources_manager.so, libshared-history.so Plugins: libqmlskypulsefrontendplugin.so, libqmlskypulsemainplugin.so, libqmlskypulseresourcesplugin.so, libqmlskypulseserviceplugin.so, libqmlskypulsesyscontrollerplugin.so Executables: skypulseapp (main process - all UI files, configurations and settings are embedded here), regcontr (regulator control process), vkbd (virtual keyboard process)
Build environment
Compiler | Arm-buildroot-linux-gnueabi-g++ 4.9.4
Middleware | Qt Library 5.9.2
Other development tool / version changed? | No

Issue / Task | Implementation / Comment | Status (development / release)
Enable support for EC20 module which uses 500V capacitor bank. Keep backward compatibility (i.e. for low-voltage capacitor bank). | Implemented support for 500V capacitor bank. Based on the response from the EC20 module, the capacitor bank voltage is properly set. Preheat parameters and calibration parameters are determined at run-time based on capacitor bank variant. By default, all settings are initialized for low-voltage bank, which enables backward compatibility. Preheating was also updated for low-voltage bank. | Under I-9498 SWR-125
Enable history module. | History module enabled, visual elements unified with the general theme of the application. Modified date preview pop-up display and added logging support for diode (single / dual) modules. Added user option to delete all history records and implemented user warning (with confirmation) when exporting or importing history. All history records now use the date / time set by the user through date / time settings menu. Applicable years range changed to 2017-2050. | Under I-9498
Re-implement diode calibration procedure (service mode) in order to support diode module calibration. | Calibration for diode module(s) re-implemented. Implemented additional state for setting trimming parameters during calibration. Added wavelength info pop-up on wavelength change in order to notify the user. Additionally, in case of diode module error during normal operation, STANDBY state request (instead of ERROR state request) is sent to IOC - this prevents disabling the cooling mechanism for diode module.
Add SW / FW version details of all modules when error window is displayed. | Implemented. Added in order to provide quicker and better serviceability for on-field devices.
Add scaling support for procedure groups icons. | Implemented with scaling factor set to 1.0 (no scaling).
Check for diode presence at the beginning of self-test. | Diode presence checked at the beginning of self-test. If diode module is not present, IOC power channel errors are suppressed. At the same time, SW / FW version request is made to all modules.
Increase minimum power for SWEEPS pulse to 200 mW @10Hz. | Minimum power raised to 200 mW @10Hz. At other repetitions (RPT), the minimum power changes based on the following rule: 200 mW * RPT / 10Hz. Increased SWEEPS energy indicator display value to single decimal precision.
Add support for custom pulse profile. | Support for custom pulse profile added. By default, the settings are initialized with profile control disabled, which enables backward compatibility. | Under I-9498 SWR-126
Fix bug for querying cooling water temperature and bank voltage during Er:YAG energy meter calibration. | Fixed. | Under I-9498
Limit the PWM value sent to the EC20 during regulation to maximum acceptable PWM. | In case of flash-lamp aging it was possible for the regulator process to request out-of-range PWM value. In such cases, the EC20 module reports an error. Implemented out-of-range PWM handling; the correction PWM value cannot be greater than maximum acceptable value for EC20. If the desired output energy cannot be achieved within the -20% tolerance, the standard mechanism stop emission and error is reported. Additionally, the regulator process control command handling is optimized (polling process now ignores empty commands). | Under I-9498 SWR-127
Fix GUI bug when favorite is selected and READY state is requested. | Bug fixed. Favorites icon and favorite name shown - READY transition does not trigger display transition to EXPERT mode. | Under I-9498 SWR-130
Disable device locking in READY state. | Device locking disabled in READY state. Notification warns the user that the device cannot be locked in READY state. (Locking the device in EMISSION state is and was not applicable). | Under I-9498 SWR-131

SW version | 1.1.4
Previous official version | 1.0.7
Change request | I-9369, I-9614
Filename | Modules: libshared-backend.so, libshared-frontend.so, libshared-listed_components.so, libshared-syscontroller.so, libshared-resources_manager.so, libshared-history.so Plugins: libqmlskypulsefrontendplugin.so, libqmlskypulsemainplugin.so, libqmlskypulseresourcesplugin.so, libqmlskypulseserviceplugin.so, libqmlskypulsesyscontrollerplugin.so Executables: skypulseapp (main process - all UI files, configurations and settings are embedded here), regcontr (regulator control process), vkbd (virtual keyboard process)
Build environment
Compiler | Arm-buildroot-linux-gnueabi-g++ 4.9.4
Middleware | Qt Library 5.9.2
Other development tool / version changed? | No

Issue / Task | Implementation / Comment | Status (development / release)
Add support for new diode modules and wavelengths. | Support for new diode modules and wavelengths added (wavelengths, hand pieces, pulse modes, power limits, etc). Only applicable wavelengths are active, other (currently) non-applicable wavelengths are inactive. Implemented unified wavelength / hand piece / pulse mode display parser based on currently selected parameters. | Implemented and released with change I-9369.
Implement raw message logger for advanced error diagnostics. | Implemented "CAN sniffer" as a separate process, which is started immediately and runs for the duration of the application life-time. The log can be exported to an external USB via the GUI interface (service and user mode). The log write is triggered when an error occurs (short delay is added to receive any "buffered" messages). Logs older than 7 days are silently discarded.
Provide user with additional information about the device state during various stages of data loading, data parsing, etc... | Implemented. Added additional status messages that represent the various stages of the device operation (where applicable).
Continue implementation of pulse profile control framework. Keep the framework inactive. | Added pulse profile control support to: - flash / laser calibration procedure, energy meter calibration procedure - user operation PWM profile controller implemented as a separate controller. Added handler to check for SYS version with which the device was calibrated. Made some changes for high voltage bank support. NOTE: high voltage bank support functionality remains inactive! Added corresponding error codes to SYS error parser controller. NOTE: Pulse profile control remains inactive!

Add support for handling power density in diode operation mode.

Added support for setting power density, where applicable due to hand piece requirements (hand pieces with spot sizes). Power density limits are calculated based on the available power for currently attached diode module and the spot size setting of the selected hand piece. Spot size parameter support added to history database, favorites and procedures. Added additional error checking for spot size validity (backend + frontend implementation).

Additionally implemented visual control and handling of user- settable spot size. This feature is currently inactive.

The spot size value with which the power density is calculated can depend on the attached diode module. To account for this variations, the hand piece spot size is selected based on the attached diode module. Hand pieces currently affected by "variable" spot size: GENOVA and R24-S.

Also added support for power density handling for favorites and procedures loading and history recalling.

Added corresponding error codes to SYS error parser controller.
Reduce minimal timer value to 1 second. | Minimal selectable timer value reduced to 1 second (previously 5 seconds). Fixed energy sum display - precision set to 0.1 mJ.
"Standardize" the parameters display on the GUI when logging various data. | Parameters display is now "standardized" for favorites display, error log display, history display.
Update diode hand pieces according to the requirements. | Added / updated hand pieces: - GENOVA - GENOVA LA - R24-S - R30-S (not active) - R21-C3/300 - R21-C3/400 Hand pieces loading now performed prior to procedures loading during initialization / startup. Reserved value 0xFF when sending the pointer intensity request to DL. Valid hand pieces range is now from 0x00 to 0xFE.
Update the diode calibration procedure in order to comply with the new diode FW requirements. | Diode calibration state machine and GUI updated. Backend support for trim parameter implemented. For calibration, removed all hand pieces, except for R21-C2 and R21-C3/300 (only these are required for calibration). Made minor changes to GUI text during the calibration procedure.
Re-implement cooling water and bank voltage queries during energy meter calibration (conform to flash / laser calibration queries). | Implemented. Required queries moved to worker thread for asynchronous operation. Added corresponding error codes to SYS error parser controller.
Implement foot switch (FSW) raw message handler. | FSW handler implemented. It is now possible to request and receive FSW FW version and battery state. The handler communicates with the FSW via CAN, where IOC acts as proxy. Added FSW version to GUI display, where SW / FW versions are shown.
Add SW / FW version display to error log. | Added version display as a header to each triggered error.

Implement diode detection mechanism and handle all possible detection results.

Diode presence is now detected in two independent ways during SYS self-test: (1) through IOC and (2) thorough DL (DL ping request).

The possible outcomes are:

(a) IOC reports diode present and DL responds. Diode is detected, device resumes operation. Diode power-channel errors are active. Diode self-test is performed.

(b) IOC reports diode not present and DL does not respond. Diode is not detected, device resumes operation. Diode power-channel errors are inactive. Diode self-test is skipped.

(c) IOC reports diode present and DL does not respond. Detection discrepancy, error is reported and device stops operation.

(d) IOC reports diode not present and DL responds. Detection discrepancy, error is reported and device stops operation.

In case of (a), the diode power-channels errors are treated as warnings when working in Er mode. Any warnings are logged to the device and can be exported via the GUI interface to an external USB device.

Added corresponding error codes to SYS error parser controller.
Add handling for non-applicable / invalid operation parameters loading. | Implemented additional checks for loading stored operating parameters in the following cases: - favorites loading - history loading - procedures loading If the diode module is not the same, but the wavelength is supported, the system then checks for power rating condition. If the currently attached diode module is able to provide the required power rating (and the same wavelength!), the parameters are loaded successfully.
Prevent user touch propagation to underlying GUI controls when lock screen is active. | Implemented. Press events are discarded in such cases.
Implement (cooling) pump and fan boost control for diode operation, based on diode module and user-selected power on the GUI. | Pump and fan levels in diode operation mode are now controlled by the SYS. The levels depend on the attached laser module and selected power. All values are experimentally determined based on diode temperature stress tests. EC20 temperature-dependent boost in diode mode disabled (boost is now directly controlled by the diode diode module parameters). All boost-related values updated throughout the application code.
Handle diode overheated error in Er operation mode. | Implemented special handling of diode overheated error in Erbium operation mode.
(Re)implement framework for updating diode operating parameters in READY state. | (Re)implemented mechanism (special state) for setting the operating parameters in READY state (for diode and Erbium operation).
Hand piece warning should always be displayed before READY state is entered. User must manually confirm the selected hand piece. | Hand piece warning is displayed every time the user requests READY state. User must confirm the hand piece warning dialog. Implemented warning handling for hand pieces with variable spot sizes. The wavelength warning is still displayed only when the wavelength changes. Modified display for hand pieces with longer names - all text fits within the specified display limits and is still clearly visible.
If laser connector ejected error is triggered by IOC, SYS must repeat the self-test procedure. | The self-test procedure must be repeated in case of laser connector ejected error. User is warned by displaying an appropriate dialog window. In case of connector ejected error (in Er mode), EM status is requested.
Support variation in transmission factor for GENOVA LA adapter based on the attached diode module. | Support added. Added additional error checking for transmission factor value validity. Added corresponding error codes to SYS error parser controller.
Send periodic ping to DL module in EMISSION state - enables the DL to detect potentially unresponsive SYS controller. | Implemented. Non-critical, ping is sent every 1 second.
Add lock-screen option from "Home Screen". | Added option to lock the screen from "Home Screen" by the lock icon within the pull-down settings menu.
Implement spray setup in service mode. | Spray setup in service mode implemented. Using IOC "console over CAN" functionality to send spray commands and receive / parse IOC responses. Added necessary support to service keyboard and service console controller. User text for spray refill slightly modified.
Enable diode wavelengths in ENDO device configuration. | Diode wavelengths removed from blacklist in ENDO configuration.
Update wavelength and hand piece icons. Modify SSP ENDO pulse icon. | The colors of wavelength and hand piece icons are updated: - blue (2985C) - orange (137C) - red (032C) - green (375C) SSP ENDO pulse icon modified - represents shorter pulse duration with respect to other pulse modes (pulse duration same as in SWEEPS mode; single pulse).
Update framework for auto-detection of maximum energy in Er mode. | Framework updated. Calculation simplified and made more robust. Added corresponding error codes to SYS error parser controller.
Implement diode watchdog in Er mode when diode module is attached and diode is available. | Implemented diode watchdog in Er mode. The watchdog is executed on the (real-time) regulator control process. It periodically pings the diode (100ms) and expects a response within a specified time interval (50ms), otherwise an error is reported. The watchdog ping request is synchronized with the emission sequence (checking emission announcement by EC20). The watchdog mechanism also includes event-driven check of valid DL states during Er operation. Added corresponding error codes to SYS error parser controller.
Fix pulse mode display sorting issue for Er calibration. | Pulse mode sorting was for Er calibration was performed based on pulse length. Pulses with the same length were therefore not sorted in a repeatable manner. Additional sort criteria added for such cases - in case the pulse length matching, the pulses are sorted alphabetically. NOTE: non-critical update!
Add check for PWM data underflow during Er calibration. | During calibration, the PWM value sent to EC20 is updated by following the specified calibration algorithm. Theoretically, the values of PWM requested can be below or above valid range. Values above valid range are already handled. Added handling for values below valid range. In any case, EC20 implements its own range checking protocol.
Improve resolution when setting / sending the diode power request to DL. | Improved resolution for setting the diode power. Previous resolution was 20 mW, new resolution is 5 mW.
Re-implement the inter-process timeout handling. | Re-implemented. The regulator process now pings the main application and expects a response within specified time interval. Otherwise, error is reported. SWR-132
Optimize emission sound playing. | Sound play request was made internally by periodically triggering a timer. On timeout, the play request was made to the sound player API. Removed periodic triggering and used sound player API option to specify infinite looping (until stopped externally by exiting EMISSION state).
Improve SW mechanism for procedures import handling. | Upgraded. Procedure groups with the same name are overwritten (user is warned prior to import action), but renamed and custom procedures remain unchanged. Renaming the procedure updates all child references.
Add support for USA configuration | Support added. Added new configurations: - C0301 (CE ENDO PLUS) - C0102 (USA ENDO PRO / EXPERT) - C0202 (USA ENDO) - C0302 (USA ENDO PLUS) Added handpieces R15 and R16 support. | Implemented and released with change I-9614.

SW version | 1.1.5
Previous official version | 1.1.4
Change request | I-9871
Filename | Modules: libshared-backend.so, libshared-frontend.so, libshared-listed_components.so, libshared-syscontroller.so, libshared-resources_manager.so, libshared-history.so Plugins: libqmlskypulsefrontendplugin.so, libqmlskypulsemainplugin.so, libqmlskypulseresourcesplugin.so, libqmlskypulseserviceplugin.so, libqmlskypulsesyscontrollerplugin.so Executables: skypulseapp (main process - all UI files, configurations and settings are embedded here), regcontr (regulator control process), vkbd (virtual keyboard process)
Build environment
Compiler | Arm-buildroot-linux-gnueabi-g++ 4.9.4
Middleware | Qt Library 5.9.2
Other development tool / version changed? | No

Issue / Task | Implementation / Comment | Status (development / release)
ENDO PLUS CE / USA configurations should only allow ENDO EM type setting | Implemented. VERSA EM type setting for ENDO PLUS CE / USA not applicable. Only ENDO EM type setting is applicable. | Implemented and released with change I-9871.

SW version | 1.2.1
Previous official version | 1.1.5
Change request | I-10136
Filename | Modules: libshared-backend.so, libshared-frontend.so, libshared-listed_components.so, libshared-syscontroller.so, libshared-resources_manager.so, libshared-history.so Plugins: libqmlskypulsefrontendplugin.so, libqmlskypulsemainplugin.so, libqmlskypulseresourcesplugin.so, libqmlskypulseserviceplugin.so, libqmlskypulsesyscontrollerplugin.so Executables: skypulseapp (main process - all UI files, configurations and settings are embedded here), regcontr (regulator control process), vkbd (virtual keyboard process)
Build environment
Compiler | Arm-buildroot-linux-gnueabi-g++ 4.9.4
Middleware | Qt Library 5.9.2
Other development tool / version changed? | No

Issue / Task | Implementation / Comment | Status (development / release)
Configurations C0301 and C0302 must allow operation with ENDO and VERSA energy meter type. | When the device is configured in C0301 or C0302 mode, operation with both energy meter types (ENDO and VERSA) is allowed. | Implemented and released with change I-10136.
IOC should treat error 0240-0005-0000 as a warning. These warnings should be logged on the device. | Implemented. Now sending request to IOC to treat error 0240-0005-0000 as a warning (request is sent before self-test starts). If this warning occurs, file logging operation is performed and the device continues to operate normally.

SW version | 1.3.3
Previous official version | 1.2.1
Change request | I-9747
Filename | Modules: libshared-backend.so, libshared-frontend.so, libshared-listed_components.so, libshared-syscontroller.so, libshared-resources_manager.so, libshared-history.so Plugins: libqmlskypulsefrontendplugin.so, libqmlskypulsemainplugin.so, libqmlskypulseresourcesplugin.so, libqmlskypulseserviceplugin.so, libqmlskypulsesyscontrollerplugin.so Executables: skypulseapp (main process - all UI files, configurations and settings are embedded here), regcontr (regulator control process), vkbd (virtual keyboard process)
Build environment
Compiler | Arm-buildroot-linux-gnueabi-g++ 4.9.4
Middleware | Qt Library 5.9.2
Other development tool / version changed? | No

Issue / Task | Implementation / Comment | Status (development / release)
Add support for MarcCo-S, MarcCo-S LA, MarcCo-M and MarcCo-L handpieces. | Implemented support for MarcCo handpieces. The calculated values for power intensity are based on different spot sizes and different transmissions (transmissions depend on the attached diode module). For modes, where power intensity is selected, the upper limit is now equal to upper boundary (i.e. transmission factor is used during upper boundary calculations). Therefore, the entire span angle of the control dial is active. MarcCo S and MarcCo LA not applicable for 1064 nm, 32W diode module. | Implemented and released with change I-9747
Number of detected pulses for internal energy meter calibration should correspond to the number of detected pulses with the external (reference) energy meter. | Slight modification to energy meter calibration (core implementation remains the same!). Emission is now triggered with delay with respect to the calibration process. All emitted pulses (not just 50) are now considered during energy meter calibration. | Under I-9747 SWR-134
Add transition to EXPERT mode, when selecting history record within the procedure screen. | Implemented. Transition to EXPERT mode enabled. | Under I-9747 SWR-133
Enable press sounds when requesting procedures, history and favorites export / import. | Implemented.
Modify SW version formatting in Error Log display. | Re-formatted. SW version is now displayed in the header of each error "packet", below the date stamp.
If spray is not available, this should be taken into account when saving / loading procedures, history and favorites. | Implemented. If spray is not available (air line disconnected) during procedures, history and favorites saving, this information is also stored. If loaded parameters require spray and the spray is not available, the user is notified. Parameters are not loaded.
Unsuccessful import action should properly unmount the USB device. | Fixed.
Fix bug where power intensity 0 mW / cm^2 can be selected. | Fixed. Error not critical, because the parameters that are displayed on-screen are sent to the diode module. In cases where 0 mW / cm^2 was selected, this value was sent to the diode module. As a result, no emission occurred.
Modify notification text for regular device maintenance. Add option to confirm yearly maintenance from service mode. | Added and implemented.
Modify displayed text when the parameters cannot be loaded due to non-applicable wavelength, handpiece or pulse mode. | Displayed text modified. User is now presented with the following message: 'Requested wavelength (or handpiece or pulse mode) not available'. Also modified text in case of error 0009-0001-0011. | Under I-9747 SWR-135
Modify the photodiode operating voltage input interval during DL calibration. | Modified. Photodiode operating voltage interval is now [50, 6000] mV. | Implemented and released with change I-9747
Modify procedure groups display on the home screen | Modified. Procedure groups are now shown with smaller visual padding at the bottom. Navigation arrow removed."

SW version | 2.1.0
Previous official version | 1.3.3
Change request | I-9925
Filename | Modules: libshared-backend.so, libshared-frontend.so, libshared-listed_components.so, libshared-syscontroller.so, libshared-resources_manager.so, libshared-history.so Plugins: libqmlskypulsefrontendplugin.so, libqmlskypulsemainplugin.so, libqmlskypulseresourcesplugin.so, libqmlskypulseserviceplugin.so, libqmlskypulsesyscontrollerplugin.so Executables: skypulseapp (main process - all UI files, configurations and settings are embedded here), regcontr (regulator control process), vkbd (virtual keyboard process)
Build environment
Compiler | Arm-buildroot-linux-gnueabi-g++ 4.9.4
Middleware | Qt Library 5.9.2
Other development tool / version changed? | No

Issue / Task | Implementation / Comment | Status (development / release)
The days since last calibration for pulse modes is calculated incorrectly (using incorrect reference time). | Fixed. Calculation of days since last calibration is now performed using HW clock time. Also fixed the date displayed in the Error Log; date reference is now the user-defined date. | Implemented and released with change I-9925
Modify flash / laser calibration screen - add PLN (us) text to measurements container header for ENDO modes. | Implemented. Measurements container header text modified.
Do not allow re-calibration of any pulse mode if EC20 minimum required version is not met (EC20 should be at least v1.1.8). | If minimum EC20 version requirement is not met, the device cannot be calibrated. The user is presented with the information window that EC20 needs to be updated to at least v1.1.8.
Add pump calibration option to service mode. | Added under "Setup -> Pump Calibration". All IOC masked errors are unmasked prior to calibration. Unmasking is also performed prior to spray calibration.
Add "profile activation" info to service and regular operating mode. | Added obfuscated code that shows if pulse profiles (pwm or pln) are enabled (for each pulse mode).
Add support for USP ENDO pulse mode. | Added support for USP ENDO pulse mode. This mode uses 100% pumping with variable pulse length. Added new pulse icon.

Implement support for pulse profiles, while keeping support for already distributed devices until new calibration is performed.

Implemented. For calibration at least EC20 v 1.1.8 is required. Energy meter calibration is performed using variable pwm with fixed pulse length for all modes. SSP, MSP, SP and SSP ENDO use 100% pumping at the beginning of the pulse. LP and VLP use normal pumping scheme.

Flash / laser calibration is performed using variable pwm for SSP, MSP, SP, SSP ENDO, LP and VLP. SSP, MSP, SP and SSP ENDO use 100% pumping at the beginning of the pulse. USP ENDO and SWEEPS pulses always use 100% pumping with variable pulse lengths.

Until re-calibration is performed, all pulse modes use variable pwm and fixed pulse lengths - backward compatibility is maintained.

Added support for setting (and regulating) operating parameters in all operation modes. Pumping scheme is equal to the calibration pumping and based on specific pulse mode. Backward compatibility is maintained.

Added support for setting variable pulse length and pulse delay (in case of SWEEPS) through CAN message id 0x10B. Implemented internal handling for setting single, burst and variable pulse length parameters.

New implementation support devices with default / low and high voltage capacitor bank.

SW version | 2.2.0
Previous official version | 2.1.0
Change request | I-10302
Filename | Modules: libshared-backend.so, libshared-frontend.so, libshared-listed_components.so, libshared-syscontroller.so, libshared-resources_manager.so, libshared-history.so Plugins: libqmlskypulsefrontendplugin.so, libqmlskypulsemainplugin.so, libqmlskypulseresourcesplugin.so, libqmlskypulseserviceplugin.so, libqmlskypulsesyscontrollerplugin.so Executables: skypulseapp (main process - all UI files, configurations and settings are embedded here), regcontr (regulator control process), vkbd (virtual keyboard process)
Build environment
Compiler | Arm-buildroot-linux-gnueabi-g++ 4.9.4
Middleware | Qt Library 5.9.2
Other development tool / version changed? | No

Issue / Task | Implementation / Comment | Status (development / release)

Implement "error report" framework.

Implemented. When an error occurs, the user can export the entire "error report" package from error message context. Files are packed in a .tar file and extension modified to .bin (security by obscurity) before the package is exported to an external USB device.

The package contains the following files: 'acn.json'

'calibration_log.json'

'configuration_data.json'

'errors.log'

'skypulse_counters.db3'

Optionally, the package can contain 'powererror' and 'cansniffer' folders.

The same package can be also exported anytime, on-demand from the pull-down quick settings menu.

The export package name consists of export date and time. Also modified name of exported "Communication Log" to include date and time (this feature is disabled, as the file is included in the "error report" package.

Implemented and released with change I-10302
Add user notification for device performance improvement through re-calibration. | The device check if re-calibration is required to improve performance (at the beginning of each self-test). User is presented with a custom notification (uses light "skin" and longer duration). Re-calibration actually enables "pulse profiles" introduced with I-9925.
Fix display string (timer value) when favorite is stored. | Fixed. If a user saves a favorite with timer elapsed, the correct (full) timer value is displayed instead of elapsed time. The actual timer value is not affected.
Perform handpiece compatibility check when loading parameters from memory (favorites, history or procedures). | Additional handpiece check implemented. For diode modules, wavelength and power compatibility is not enough to load the parameters. Handpieces must now also be compatible.
Update "pulse profile active" indicator to include only pulses that actually support pulse profiles. | Updated. Currently all pulses, but LP and VLP support pulse profiles.
Re-check foot switch status immediately before entering READY state. | Foot switch status check now performed when user presses READY button and again immediately before entering READY state. If foot switch is pressed, the device does not enter READY state. | Under I-10302 SWR-136

SW version | 2.3.0
Previous official version | 2.2.0
Change request | I-10373
Filename | Modules: libshared-backend.so, libshared-frontend.so, libshared-listed_components.so, libshared-syscontroller.so, libshared-resources_manager.so, libshared-history.so Plugins: libqmlskypulsefrontendplugin.so, libqmlskypulsemainplugin.so, libqmlskypulseresourcesplugin.so, libqmlskypulseserviceplugin.so, libqmlskypulsesyscontrollerplugin.so Executables: skypulseapp (main process - all UI files, configurations and settings are embedded here), regcontr (regulator control process), vkbd (virtual keyboard process)
Build environment
Compiler | Arm-buildroot-linux-gnueabi-g++ 4.9.4
Middleware | Qt Library 5.9.2
Other development tool / version changed? | No

Issue / Task | Implementation / Comment | Status (development / release)
Disable fixed pumping (100% PWM) for SSP, MSP, SP and SSP ENDO pulse modes. | 100% PWM flash pumping disabled for SSP, MSP, SP and SSP ENDO pulse modes. Updated initial PWM values for calibration energy meter and flash / laser calibration procedure. Added additional (version-based) check for re-calibration request in cases where SSP, MSP, SP and SSP ENDO pulse modes are already calibrated with fixed pumping. In such cases, the device cannot enter READY state, until aforementioned pulse modes are re-calibrated. Modified "obfuscated" prf code; pulse profile "activation" is now shown for USP ENDO and SWEEPS only. | Implemented and released with change I-10373.

SW version | 2.4.8
Previous official version | 2.3.0
Change request | I-10397, I-10295 , I-10611
Filename | Modules: libshared-backend.so, libshared-frontend.so, libshared-listed_components.so, libshared-syscontroller.so, libshared-resources_manager.so, libshared-history.so Plugins: libqmlskypulsefrontendplugin.so, libqmlskypulsemainplugin.so, libqmlskypulseresourcesplugin.so, libqmlskypulseserviceplugin.so, libqmlskypulsesyscontrollerplugin.so Executables: skypulseapp (main process - all UI files, configurations and settings are embedded here), regcontr (regulator control process), vkbd (virtual keyboard process)
Build environment
Compiler | Arm-buildroot-linux-gnueabi-g++ 4.9.4
Middleware | Qt Library 5.9.2
Other development tool / version changed? | No

Issue / Task | Implementation / Comment | Status (development / release)

Add support for dual (tandem) diode operation.

Added GUI support for tandem, CW mode only. Controls include primary and secondary pulse time setting (left dial), primary and secondary power / power intensity setting (center dial) and timer dial. Center dial is separated with percentage indicator (showing percent of total power / power intensity for each wavelength). Added temporary peak power display.

Disabled smoothing and anti-aliasing for controls in order to improve performance.

Integrated backend calculation support into existing routines:

- calculating bounds and limits for pulse times (secondary pulse on time limits are determined by the primary pulse on time value and power)
- calculating bounds and limits for power / power intensity (handling different spot sizes and transmission factors for the same handpiece)
- calculating parameters for first and second wavelength that are sent to the diode via CAN (calculations for average power are scaled based on timings - tandem diode is managed as two single diodes)
- added additional checks and fail-safes during parameters loading / recalling
- updated diode "boost" calculations - diode with higher power rating used as a reference
- modified / updated CAN message for sending dual (tandem) diode parameters; added default third module timing and position variables

Also fixed a minor issue when calculating single diode pulse off times; limits extended - calculating with diode nominal power.

Implemented and released with change I-10397.
Update history, favorites and procedures handling for dual (tandem) diode operation. | Updated history, favorites and procedures implementation to support saving / loading of tandem parameters, while keeping backward compatibility for single diode modes (and Er). Unified parameters display formatting (favorites, error log, history). Fixed spray handling issues when loading parameters and spray is requested and not available.
Add check for minimal IOC and DL version. | Check for minimum version requirements implemented. User is warned; upgrade is necessary in order to enable diode operation.
Fix minor issue with error log scrolling. | Error log scrolling flow fixed; invalid "jump" to the start / end of the currently displayed list is resolved. Additionally, when list beginning / end is reached, the position remains at the top / bottom of the error list.
Modify view in cases, where the procedure list is too long and does not fit the display area. | Modified. If the procedures list does not fit the entire display area, the procedure text is clipped, denoting that scrolling the list is possible.
Modify naming convention for CAN trace log. | Modified. Naming convention is now based on date / time using ISO 8601 formatting.
Fix discrepancy between user and system seconds counter. | Fixed. User seconds counter is now synchronized with system seconds counter.
Compatible diode wavelength replacement should only be valid if requested power / power density can be achieved, using the exact same timing parameters and also considering handpiece transmission variations. | Implemented.
Fix issue when modifying the repetition in READY state and diode repetition mode is enabled. | Issue fixed. Repetition change now triggers the process of sending new parameters to the diode. Fixed PEAK power display when repetition mode is enabled. | Under I-10397 SWR-137
Add support for parsing IOC error related to cooling liquid level. | Support added (error code 0240-0015-0000). In case of error, the user is presented with the following message: "Cooling liquid level too low. Call service." | Implemented and released with change I-10295.
Fix setting the air / water dial value in spray standby state. | Fixed. Air / water dial value updated on backend event request.
Modify IOC version display to show version and FW signature (hash). | Modified. GUI now displays IOC version and hash.
Implement routine for restoring IOC factory settings. | Added new service sub-menu under "Reset" menu and implemented routine to perform on-demand factory setting restore procedure for IOC. | Implemented and released with change I-10611.

SW version | 3.0.8
Previous official version | 2.4.8
Change request | I-10804
Filename | Modules: libshared-backend.so, libshared-frontend.so, libshared-listed_components.so, libshared-syscontroller.so, libshared-resources_manager.so, libshared-history.so Plugins: libqmlskypulsefrontendplugin.so, libqmlskypulsemainplugin.so, libqmlskypulseresourcesplugin.so, libqmlskypulseserviceplugin.so, libqmlskypulsesyscontrollerplugin.so Executables: skypulseapp (main process - all UI files, configurations and settings are embedded here), regcontr (regulator control process), vkbd (virtual keyboard process)
Build environment
Compiler | Arm-buildroot-linux-gnueabi-g++ 4.9.4
Middleware | Qt Library 5.9.2
Other development tool / version changed? | No

Issue / Task | Implementation / Comment | Status (development / release)

Implement support for R-SWEEPS pulse mode.

Support for R-SWEEPS implemented:

- implemented "tooth" selection popup window with additional parameters selection (size, fiber type, depth and delay factor)
- added favorites and history support
- implemented procedures support (procedures, procedure steps, etc.) and editing support
- implemented recent parameters saving / recalling in EXPERT mode
- sweeping +- 80 us, nominal delay is calculated based on Eout, size, fiber type, depth and delay factor
- extended CAN msg (0x10B) to accommodate extended pulse delay range (communication with EC20)
- calibration requires EC20 version greater or equal to v1.2.1
- in case of an error, the nominal pulse delay is also noted in the error log
- pulse counting is added to the SWEEPS pulse counter

Implemented and released with change I-10804
Implement support for X-SWEEPS pulse mode | Support for X-SWEEPS implemented: sweeping +- 80 us, nominal delay [280 us, 1300 us] with step of 20 us drop down nominal delay selection is positioned in such a way that currently selected value is visible calibration requires EC20 version greater or equal to v1.2.1 In case of an error, the nominal pulse delay is also noted in the error log pulse counting is added to the SWEEPS pulse counter
Add "energy sum" indicator to tandem diode GUI. | "Energy sum" counting implemented for tandem diode GUI.
For selected wavelength, display all pulse modes. If pulse mode is not supported by the currently selected handpiece, it should still be visible, but disabled. | Implemented. Pulse modes are now displayed even if there is no handpieces support; such pulse modes are disabled and grayed out and user warning is displayed on selection.
Extend SWEEPS calibration delays due to R-SWEEPS and X-SWEEPS operating delay requirements. | SWEEPS is now calibrated at four delays for improved model fit accuracy (200 us, 730 us, 1260 us and 1800 us)
SWEEPS-based modes should only allow H14-N, H14-NE and H14-NS handpieces. | Only H14-N, H14-NE and H-14NS support SWEEPS, R-SWEEPS and X-SWEEPS pulse modes.
Implement licensing framework for R-SWEEPS pulse mode. | Licensing framework implemented. R-SWEEPS is licensed via a device-unique license code. If R-SWEEPS is not licensed and user requests R-SWEEPS operation, a warning: "R-SWEEPS is not installed" is displayed. Added option for "inline" license input if R-SWEEPS is unlicensed and requested (history, favorites, procedures, expert).
Modify text for license and configuration input via pull-down settings menu. | Entries in pull-down settings menu changed to "Input License Code" and "Input Configuration Code". All user text pertaining to license and configuration input modified accordingly.
Disable applicability for handpiece R21-C2 in combination with 670 nm diode wavelength. | Disabled. R21-C2 handpiece not listed for diode 670 nm wavelength option (also applies in cases where 670 nm wavelength is used in tandem mode).

SW version | 3.1.1
Previous official version | 3.0.8
Change request | I-11057
Filename | Modules: libshared-backend.so, libshared-frontend.so, libshared-listed_components.so, libshared-syscontroller.so, libshared-resources_manager.so, libshared-history.so Plugins: libqmlskypulsefrontendplugin.so, libqmlskypulsemainplugin.so, libqmlskypulseresourcesplugin.so, libqmlskypulseserviceplugin.so, libqmlskypulsesyscontrollerplugin.so Executables: skypulseapp (main process - all UI files, configurations and settings are embedded here), regcontr (regulator control process), vkbd (virtual keyboard process)
Build environment
Compiler | Arm-buildroot-linux-gnueabi-g++ 4.9.4
Middleware | Qt Library 5.9.2
Other development tool / version changed? | No

Issue / Task | Implementation / Comment | Status (development / release)
Remove support for R21-C2 handpiece. | Support for R21-C2 handpiece removed. | Implemented and released with change I-11057
Implement support for querying DL calibration parameters. | Implemented. On entering the DL calibration screen, calibration parameters are requested via the CAN. If the DL returns nothing, the calibration can proceed normally without the default specified parameters. If the DL returns the calibration parameters, the values are displayed on-screen. If DL version is less than v1.1.0, no query is performed (due to backwards compatibility).
Display energy meter type after the energy meter serial number. | Implemented. The energy meter type info is always displayed after the serial number (SW info, error log, error pop-up).

SW version | 3.2.0
Previous official version | 3.1.1
Change request | I-11229
Filename | Modules: libshared-backend.so, libshared-frontend.so, libshared-listed_components.so, libshared-syscontroller.so, libshared-resources_manager.so, libshared-history.so Plugins: libqmlskypulsefrontendplugin.so, libqmlskypulsemainplugin.so, libqmlskypulseresourcesplugin.so, libqmlskypulseserviceplugin.so, libqmlskypulsesyscontrollerplugin.so Executables: skypulseapp (main process - all UI files, configurations and settings are embedded here), regcontr (regulator control process), vkbd (virtual keyboard process)
Build environment
Compiler | Arm-buildroot-linux-gnueabi-g++ 4.9.4
Middleware | Qt Library 5.9.2
Other development tool / version changed? | No

Issue / Task | Implementation / Comment | Status (development / release)
Optimize Er calibration procedure and implement fix for occasional calibration errors (0140-0002-0000 and 0140-0014-0000). | Implemented: Er calibration procedure optimized - parameters request towards EC20 and EM is now performed in READY state. When parameters are about to be sent, SYS puts the device in READY state, sends the parameters and puts the device back in EMISSION state implemented routine for exact flash pulse length request towards EM updated CAN protocol to allow extending EC20 time window for SYS confirmation | Implemented and released with change I-11229
Limit maximum pulse length for USP ENDO and SWEEPS-based regimes to 80 us. | Implemented 80 us pulse length limits for USP ENDO and SWEEPS-based regimes.

SW version | 3.3.3
Previous official version | 3.2.0
Change request | I-11458
Filename | Modules: libshared-backend.so, libshared-frontend.so, libshared-listed_components.so, libshared-syscontroller.so, libshared-resources_manager.so, libshared-history.so Plugins: libqmlskypulsefrontendplugin.so, libqmlskypulsemainplugin.so, libqmlskypulseresourcesplugin.so, libqmlskypulseserviceplugin.so, libqmlskypulsesyscontrollerplugin.so Executables: skypulseapp (main process - all UI files, configurations and settings are embedded here), regcontr (regulator control process), vkbd (virtual keyboard process)
Build environment
Compiler | Arm-buildroot-linux-gnueabi-g++ 4.9.4
Middleware | Qt Library 5.9.2
Other development tool / version changed? | No

Issue / Task | Implementation / Comment | Status (development / release)
Optimize and generalize the energy meter and flash / laser calibration procedure. | Simplified / generalized energy meter calibration procedure: - one calibration (SP mode) now handles all GENERAL modes - one calibration (SWEEPS mode) now handles all ENDO modes - service mode GUI modified accordingly Optimized flash / laser calibration: - modified procedure for low Eout threshold search - slightly modified the calibration model (removed the quadratic term in order to prevent strange behavior if out of calibration bounds) | Implemented and released with change I-11458.
Optimize regulator routine. | Optimized by enabling regulation of second SWEEPS pulse.
Fix compatibility issues when using LightWalker foot switch. | Fixed – added filtering to foot switch position reporting (this filters the invalid state that can occur for a short period of time).
Extend maximum pulse length limit to 120 us for low voltage devices in PLN mode. | Extended. For low voltage devices, the maximum pulse length is 120 us. For high voltage devices, the maximum pulse length is still 80 us.
Add user notification when the device automatically transfers to STANDBY mode. | User notification added when the device automatically transfers to “Standby” mode.
Add checksum to Error Log report. | Added checksum calculation for all Error Log report package contents.
Fix invalid user notification that can occur when trying to import procedures without USB device inserted. | Fixed (now checking if USB device is present, before attempting import action).
Upgrade CAN trace framework | CAN trace framework upgraded: - increased CAN trace buffer size (from 100 to 250 lines) - added version and parameters info to each CAN trace - at least 150 CAN trace files are kept stored on the device (up to 200 maximum) Also: - extended notification time for error log export - modified display of error log header
Implement spot check routine for Er service mode | Implemented.
Disable shut-down option in service mode if any calibration screen is active | Shut-down disabled for Er (energy meter, flash / laser) and DL calibration screen. User is notified that calibration screen must be exited prior to shut-down request. Also disabled FSW actions during Er energy meter calibration (only when the device expects user input, i.e., energy measured by external energy meter). Additionally, if device is in (service) emission state, menu traversal is disabled.

SW version | 3.4.2
Previous official version | 3.3.3
Change request | I-11903
Filename | Modules: libshared-backend.so, libshared-frontend.so, libshared-listed_components.so, libshared-syscontroller.so, libshared-resources_manager.so, libshared-history.so Plugins: libqmlskypulsefrontendplugin.so, libqmlskypulsemainplugin.so, libqmlskypulseresourcesplugin.so, libqmlskypulseserviceplugin.so, libqmlskypulsesyscontrollerplugin.so Executables: skypulseapp (main process - all UI files, configurations and settings are embedded here), regcontr (regulator control process), vkbd (virtual keyboard process)
Build environment
Compiler | Arm-buildroot-linux-gnueabi-g++ 4.9.4
Middleware | Qt Library 5.9.2
Other development tool / version changed? | No

Issue / Task | Implementation / Comment | Status (development / release)
Improve error logging and debugging framework. | - Minor improvement to CAN logging - More verbose feedback to user when exporting the Error report log - Added option to output various debug parameters to the console (intended for laboratory use only) - Added history file export to Error report log (last 14 days from the last history entry is exported) | Implemented and released with change I-11903.
Fix authorization pattern reset bug. | Bug fixed. Authorization pattern can now be reset using the P code of the device (reset code is unique for each SkyPulse device). Changed user settings, error log and history reset password.
Add IOC hardware detection feature. | SYS can now detect IOC HW V1 and HW V2 or greater. If HW V1 is detected, error 0240-0005-0000 is masked as a warning, if HW V2 is detected, the error is not masked as a warning.
Display IOC version on GUI in MAJOR.MINOR.PATCH notation. | Implemented.
Do not display Er calibration recommendation (if applicable) if Er module is connected to the device. | Calibration recommendation can only be displayed if SYS successfully detects Er module.
Fix bug when loading parameters for tandem diode. | Bug fixed (out of bounds indexing).

SW version | 3.5.2
Previous official version | 3.4.2
Change request | I-12436
Filename | Modules: libshared-backend.so, libshared-frontend.so, libshared-listed_components.so, libshared-syscontroller.so, libshared-resources_manager.so, libshared-history.so Plugins: libqmlskypulsefrontendplugin.so, libqmlskypulsemainplugin.so, libqmlskypulseresourcesplugin.so, libqmlskypulseserviceplugin.so, libqmlskypulsesyscontrollerplugin.so Executables: skypulseapp (main process - all UI files, configurations and settings are embedded here), regcontr (regulator control process), vkbd (virtual keyboard process)
Build environment
Compiler | Arm-buildroot-linux-gnueabi-g++ 4.9.4
Middleware | Qt Library 5.9.2
Other development tool / version changed? | No

Issue / Task | Implementation / Comment | Status (development / release)
Add support for QSP pulse mode. | Added full support for QSP pulse mode: updated SYS <-> EC20 CAN protocol implemented QSP calibration implemented QSP energy output control (updated regulator control process) modified and updated GUI and backend framework for handling configuration data, favorites, history, procedures, pulse counters, etc. QSP only available in C0101 and C0102 configurations QSP mode only available for high voltage bank devices QSP mode requirement check (checking min EC20 version that supports QSP protocol in calibration and regular mode) | Implemented and released with change I-12436.
Optimize GUI controls. | GUI controls screen optimized: enabled dragging dials out of bounds without losing active focus optimized dials drawing for smoother operation optimized dials text display disabled updating parameters on value change - parameters are now updated only when necessary
Optimize emission sound player. | Optimized - using unified, slightly modified sound player API.
Add pump current indicator in service mode. | Updated SYS <-> IOC protocol in order to read pump current. Pump current is displayed in service mode (under "Device Diagnostics"). Additionally, pump current "feature" was added into advanced service mode - only available for laboratory-related experiments. Also added some additional features to advanced service mode.
Fix bug when switching between diode mode display (if R-SWEEPS pulse mode is selected and diode mode display is switched, the tooth selection popup appears). | Bug fixed. Tooth selection popup not reacting to diode mode display switching.
Increase size of the pattern authorization nodes for increased usability. | Size of nodes increased.

SW version | 3.6.0
Previous official version | 3.5.2
Change request | I-12741
Filename | Modules: libshared-backend.so, libshared-frontend.so, libshared-listed_components.so, libshared-syscontroller.so, libshared-resources_manager.so, libshared-history.so Plugins: libqmlskypulsefrontendplugin.so, libqmlskypulsemainplugin.so, libqmlskypulseresourcesplugin.so, libqmlskypulseserviceplugin.so, libqmlskypulsesyscontrollerplugin.so Executables: skypulseapp (main process - all UI files, configurations and settings are embedded here), regcontr (regulator control process), vkbd (virtual keyboard process)
Build environment
Compiler | Arm-buildroot-linux-gnueabi-g++ 4.9.4
Middleware | Qt Library 5.9.2
Other development tool / version changed? | No

Issue / Task | Implementation / Comment | Status (development / release)
Unify Erbium center dial display with ENDO modes. | Implemented. SSP, MSP, SP, LP, VLP and QSP pulse modes now show power as a primary quantity. Also renamed menu entry that enables switching between power and energy display. | Implemented and released with change I-12741.

SW version | 3.7.0
Previous official version | 3.6.0
Change request | I-12964
Filename | Modules: libshared-backend.so, libshared-frontend.so, libshared-listed_components.so, libshared-syscontroller.so, libshared-resources_manager.so, libshared-history.so Plugins: libqmlskypulsefrontendplugin.so, libqmlskypulsemainplugin.so, libqmlskypulseresourcesplugin.so, libqmlskypulseserviceplugin.so, libqmlskypulsesyscontrollerplugin.so Executables: skypulseapp (main process - all UI files, configurations and settings are embedded here), regcontr (regulator control process), vkbd (virtual keyboard process)
Build environment
Compiler | Arm-buildroot-linux-gnueabi-g++ 4.9.4
Middleware | Qt Library 5.9.2
Other development tool / version changed? | No

Issue / Task | Implementation / Comment | Status (development / release)

Enable and modify authorization code number (ACN) framework for permanent and temporary device unlocking.

ACN framework enabled. Implemented two device unlock policies:

1. Permanent unlocking. A unique code is used to permanently unlock the device. The unlock status can be seen in service mode.

2. Temporary unlocking. A unique code is used to temporary unlock the device. The same code cannot be used twice due to SN checking. The unlock status and expiry time can be seen in service mode.

The device can also be permanently locked (until a new, valid code is entered) at any time from the service mode.

If ACN is expired, the user is notified and the device cannot enter READY state.

If ACN is about to expire (7 days or less), the user is notified and the device can still enter READY state.

Implemented and released with change I-12964.
Additionally notify user when flash / laser calibration is in progress. | Added notification "Calibrating, please hold the foot switch" during flash / laser calibration. During Er calibration, the DL power channel errors are disabled (analogous to normal device operation). On exporting raw calibration data, all energy meter serial numbers are added to the exported file name (it is possible to calibrate different pulse modes with different energy meters). Note that this is a service feature only.
Decouple EC20 "flash lamp" and "power cable" errors - currently, both are joined under a single error. | Errors decoupled: "Flash lamp" error is now treated as a "user type" error. Therefore, it can be dismissed by the user, but only in cases where error is also decoupled on the EC20 side (SYS detects EC20 version). Otherwise, this error is an operating error and requires device shut-down. "Power cable error" is an operating error and requires device shut-down.
Add user notification if flash lamp ignition does not happen in the specified time-frame. | User notification added when user requests transition to READY state and flash lamp ignition does not occur in 500 ms (+50 ms for processing). The notification disappears when flash lamp ignition or error occurs.
Self-test errors should be stored in the error log. | Self-test errors are now added to the error log. "(Self-test)" prefix is used for every such log. Errors related to Er or DL being disconnected on device startup are not logged.
Only SWEEPS-based modes (SWEEPS, R-SWEEPS, X-SWEEPS) should display energy per pulse (i.e., "mJ / pulse") as a secondary display mode. | Implemented. Chaged notation "mJ / pulse" for SSP and USP endo to "mJ". Note that energy based representation is a secondary display mode (primary is still power).
Optimize loading of last selected expert parameters. | Optimized. When expert mode is selected, the loading routine first checks if last expert parameter can be loaded. If not, the defaults are loaded. (Previously, the defaults were always loaded, followed by loading of last expert parameters - this incurred unnecessary performance penalty).

SW version | 3.8.0
Previous official version | 3.7.0
Change request | I-13254
Filename | Modules: libshared-backend.so, libshared-frontend.so, libshared-listed_components.so, libshared-syscontroller.so, libshared-resources_manager.so, libshared-history.so Plugins: libqmlskypulsefrontendplugin.so, libqmlskypulsemainplugin.so, libqmlskypulseresourcesplugin.so, libqmlskypulseserviceplugin.so, libqmlskypulsesyscontrollerplugin.so Executables: skypulseapp (main process - all UI files, configurations and settings are embedded here), regcontr (regulator control process), vkbd (virtual keyboard process)
Build environment
Compiler | Arm-buildroot-linux-gnueabi-g++ 4.9.4
Middleware | Qt Library 5.9.2
Other development tool / version changed? | No

Issue / Task | Implementation / Comment | Status (development / release)
Add support for energy meter configuration via GUI. | Support for energy meter configuration via GUI (service mode only) implemented: available only if Er module is present each configuration specifies default energy meter type energy meter is configured using the configuration code; the configuration code must match current device configuration removed "typeVERSA" from white-listed energy meters in C0301 and C0302 configurations (for devices already on field that use C0301 or C0302 configurations and energy meter is configured as "type VERSA", the energy meter must be re-configured) | Implemented and released with change I-13254.

SW version | 3.9.0
Previous official version | 3.8.0
Change request | I-13217
Filename | Modules: libshared-backend.so, libshared-frontend.so, libshared-listed_components.so, libshared-syscontroller.so, libshared-resources_manager.so, libshared-history.so Plugins: libqmlskypulsefrontendplugin.so, libqmlskypulsemainplugin.so, libqmlskypulseresourcesplugin.so, libqmlskypulseserviceplugin.so, libqmlskypulsesyscontrollerplugin.so Executables: skypulseapp (main process - all UI files, configurations and settings are embedded here), regcontr (regulator control process), vkbd (virtual keyboard process)
Build environment
Compiler | Arm-buildroot-linux-gnueabi-g++ 4.9.4
Middleware | Qt Library 5.9.2
Other development tool / version changed? | No

Issue / Task | Implementation / Comment | Status (development / release)
Enable spray water gain adjustment from the service mode. | Spray water gain can be adjusted from the service menu. Service personnel can select two tubing types. The value is stored in device settings file (with backup and hash-protected). The CAN protocol (i.e., spray message) was updated in order to also send the adjusted / set water gain value. | Implemented and released with change I-13217.
Fix minor issue with pulse counters reset in service mode (reset only pulse counters for currently attached laser head). | Fixed. Database filtering performed based on current laser head serial number.

Unresolved anomalies, bugs and defects:

There are no known faults or defects detected.

# POWER SUPPLY MODULE (EC20), id. 99804

SW version | 0.7.0
Previous official version | /
Change request | Project status on 20. 09. 2017
Filename | EC20.hex
Build environment
Compiler | Armcc.exe V5.06 update 4 (build 422)
Middleware | Keil MDK-ARM Plus Versio:5.23
Other development tool / version changed? | /

Issue / Task | Implementation / Comment | Status (development / release)
Create version from LW (PFM5) | Initial built from PFM v31 | Development phase
Local setup changes | Measuring the capacitance of the bank, the LLC transfer function, IAP
CAN protocol adaptation | New parameters message, ID commands
Flash simmer current controller | 8kV driver, current driver, diagnostics
Flash pulse controller | Heating, burst, sweeps pulse sequence generator, diagnostics
LLC controller for bank charging | Flicker regulator, main LLC current driver
Functional measurement | Bank voltage, IGBT pulse energy
HW diagnostics, errors management | Temperatures, voltages, current, switches breakdown detection, HW drivers controllers

SW version | Development version 0.8.0
Previous official version | Development version 0.7.0
Change request | Project status on 27. 03. 2018
Filename | EC20.hex
Build environment
Compiler | Armcc.exe V5.06 update 4 (build 422)
Middleware | Keil MDK-ARM Plus Versio:5.23
Other development tool / version changed? | /

Issue / Task | Implementation / Comment | Status (development / release)
Foot Switch sequencer – FSW_STATE machine | The pulse generator monitors signals from three sources: FSW, IOC, SYS | Development phase
Modified Burst pulse | The fast burst pulses are generated inside the TIM1 interrupt.
Capture and reporting of incoming energy | Energy are captured and reported to CAN for each burst pulse separately.
Diagnostics of failure of the main IGBT switch | In two ways: exceeding the average amplitude and exceeding the pulse time
Diagnostics and driver for security IGBT switch | Security IGBT switch detector, security critical errors controller.
Timer application functionality | Time set SYS, implement EC20, security controls SYS.
Detector of contact between minus flash cable and PE | An appropriate filter prevents from false error when switch on simmer current.
Generator synchro CAN message | Extended time between CAN message and pulse to flash from 50u to 500uS.
CAN tracking on service console communications | On the command display all the messages with the content and time stamp
Auxiliary transformer temperature sensor is added | No more free ADC channels - solution with injected channel configuration
SW optimization - data structures changes | Eliminate some 2D matrix and redundant data

SW version | Development version 0.8.6
Previous official version | Development version 0.8.0
Change request | Project status on 20. 08. 2018
Filename | EC20.hex
Build environment
Compiler | Armcc.exe V5.06 update 4 (build 422)
Middleware | Keil MDK-ARM Plus Version: 5.23
Other development tool / version changed? | /

Issue / Task | Implementation / Comment | Status (development / release)
Change diagnostic signal SW filter on EM_STOP. | Change EM_STOP current in CAN status byte changes two bits: EM_DET and IG_TEST. Due to HW filters, IG_TEST detects about 2mS before EM_DET, which makes it difficult to analyze the error - a consequence of the cause. SW filter on IG_TEST I extended from 3 mS to 7 mS and changed the order of the record. | Development phase
SYSCTRL supervisory timeout changing | EMISSION EC20 monitors CAN messages from SYS (periodic validation of PWM parameters) with respect to repetition to next pulse + tolerance T ... otherwise FSW_ERR. This timer is extended from 50 ms-> 250ms
SYSCTRL supervisory FSW_OFF sequence | After finishing the sequence FSW_OFF (from HW and IOC) EC20 control the time to CAN message from SYS (FSW_OFF) otherwise FSW_OFF_ERR. Time is prolonged from 50 ms-> 250ms.
The sequential control of CAN messages from the IOC (FSW state) is widespread. | For the 1000 u / 38.5 % / 10 Hz parameters, FSWIOC_ERR occurs. The sequential control of CAN messages from the IOC (FSW state) is widespread. It was from the end of the pulse to the end of repetition. In the case of a long pulse at the laser trigger threshold, the laser is generated at the beginning, EM reports already in the middle of the pulse and the IOC casts the FSW status before the end of the pulse. As a consequence, the control falls out and the report false FSWIOC_ERR. Solution: The start of the control is set from the 1st front of the pulse.
False ERRs blocking. | Interrupted EM_STOP in EMISSION causes a chain of false ERRs. Solution: Rapid detection of EM_DET-> IG2_DRV and blocking the declaration of subsequent ERRs. Solution: Log only EM_DET status or a single first ERR or STATUS that is the source of the error -> blocks the application of other ERRs
Ther was some CAN errors. | Set the automatic repetition of CAN commands in the event of an error on the CAN bus.
Longer FSW timer. | Extension FSW timer for EMISSION from max 10 minutes to max 46 h - The 4th byte EC20_Foot_SW (104h) is added to the CAN command.

SW version | Development version – 0.8.16
Previous official version | Development version 0.8.6
Change request | Project status on 23. 11. 2018
Filename | EC20.hex
Build environment
Compiler | Armcc.exe V5.06 update 4 (build 422)
Middleware | Keil MDK-ARM Plus Version: 5.23
Other development tool / version changed? | /

Issue / Task | Implementation / Comment | Status (development / release)
FSW_ERR | FSW_ERR, If the SYS in the EMISSION state changes (to less) repetition. Solution: Foot_SW_tim_in data is copied to Foot_SW_tim after the end of the period. | Development phase - testing house
SETUP on demand from SYS | SETUP procedure on EC20 (charging bank ... etc ...) in the new SW starts on demand from SYS and not automatically when the power is turned on. New data on CAN - EC20_COM (102h): bit [2] - EC20_START.
Synchronization of CAN E massages | In the new SW make the synchronization of the CAN messages for incoming E. EC20 do not send incoming E is until the outgoing E is received from ENM ID 0x0C0 for all four different types incoming E. In the event that due to anything ENM does not transmit E, the EC20 does not send E.
UB_TooLow error | After the last heating pulse, the charging of the bank is not calculated correctly, and consequently the bank does not fill up to 420V. Report UB_TooLow error. To continue the tests, I lowered the diagnostic threshold from 1.2V -> 12V.
Err UB_TooLow - solved | Error UB_TooLow - solution of the previous problem: A separate calculation of the repetition for the first sequence is made. There is different timeing: preheating + full repetition.
TIME_ERR | The flicker controller is calculated according to the voltage drop on the bank after the shot. If the calculated charging current is outside the calibration range in SETUP, EC20 logs TIME_ERR. The maximum charging current in the SETUP procedure is increased from 2.2A to 2.8A.
TIME_ERR - solved | Long preheating. The charging current after the first regular shot is wrongly calculated. Consequently, a strong charge after another shot is required -> TIME_ERR. Correction of time due to preheating is done on several program branches and solves the problem.
TIME_ERR | Transfer TIME_ERR problem to service mode - via UART commands
MAX current in SETUP | The maximum charge current has been changed from 2.2A to 2.8A. Two power supplies from the first series off 10 pieces were not capable of charging current 2.8A (but approx. 2.6 ~ 2.7A). SW is corrected - MAX current in SETUP is 2.5A (approximately 800W of peak power).

SW version | Development version – 0.8.19
Previous official version | Development version 0.8.16
Change request | Project status on 18. 03. 2019
Filename | EC20.hex
Build environment
Compiler | Armcc.exe V5.06 update 4 (build 422)
Middleware | Keil MDK-ARM Plus Version: 5.23
Other development tool / version changed? | /

Issue / Task | Implementation / Comment | Status (development / release)
MAX current in SETUP | The maximum charging current to bank in the SETUP procedure was increased from 2.2A to 2.8A in SW v0.8.13. It is too much for some Power Supply. Maximum decreased back to 2.5A. | Development phase - release for testing house
Upgrading Burst Functionality: | Each pulse can be defined differently length. The change is also on CAN bus, and UART service commands.
IGBT2_DESAT_ERR in pulse with larger PWM | Both IGBTs driver protect the IGBT from over current. uP signal is only for diagnostic purposes with strong R / C filters. Fast interrupts were deleted from the SW.

SW version | Development version – 0.8.31
Previous official version | Development version 0.8.19
Change request | Project status on 02. 07. 2019
Filename | EC20.hex
Build environment
Compiler | Armcc.exe V5.06 update 4 (build 422)
Middleware | Keil MDK-ARM Plus Version: 5.23
Other development tool / version changed? | /

Issue / Task | Implementation / Comment | Status (development / release)
The repeat resolution was changed from 10uS to 20uS. (SWR-79) | The maximum repetition length of 500mS is controlled by a counter with a range of FFFFh (655.35ms). Long preheat before first pulse and first repetition can be> 655ms on a regular basis. The resolution of the counter has been changed from 10us to 20us, increasing the range to 1310ms, which is sufficient for the entered maximum preheat lengths and maximum repetition. | Development phase
False emission E of the previous pulse to the CAN bus. (SWR-79) | If the transition from ACTION to READY (FSW_off) is between the last heating pulse and the end of the main pulse, the EC20 transmits or repeats the input of the previous main pulse at the next sequence (FSW_on) when the first heating pulse is emitted. Solution: On FSW_STATE at FSW_off: Deleted event - energy submission request. Only one CAN message is sent for each pulse.
HV_OFF_ERR included again. (SWR-80) | HV_OFF_ERROR was removed when masking errors due to a deactivated EMSTOP loop in one of the previous versions.
LNG_ERR re-enabled - Corrected Burst Pulse Data Transfer - (SWR-82) | Solution: CAN_Burst data is transmitted at 1.f.pulse. Due to a problem, the diagnostics were disabled in the previous version.
Changed default preheat data (SWR-82) | hprt = 100; // 100Hz repetition of the heating pulse in Hz (10-100Hz) hpln = 40; // 40us pulse length in 1us (20-1000; 20-1000us) hnr1 = 30; // number of pulses before first pulse (0-32) hpwm1 = 1000; // PWM heating pulse in %% before first pulse (30-250; 3-25%) htm1 = 50; // T between the heating pulses and the first pulse (10-200mS) hnr2 = 0; // number of pulses before other pulses (0-32) hpwm2 = 1000; // PWM heating pulse in %% over other pulses (30-250; 3-25%) htm2 = 50; // T between heating pulses and other pulses (10-200mS)
Additional heating pulse in service mode. (SWR-82) | Preheating operation via service communication; Occasionally, there was additional heating pulse, resulting in an incorrect sequence of heating pulses and the main pulse at the start of emission. The problem arises when the shooting of TS0 is interrupted during the time between the last heating pulse and the main pulse. The following sequence along TS1 is incorrect. Solution: Deleted event tim6_stop = 0 in FSW_STATE 151.
CRC application calculation in Bootloader transferred to the application. (SWR-95) | Crc control of the application was built into the BootLoader SW on the EC20 side. The CRC was calculated and wrote when downloading the SW application itself via BootLoader. This made it impossible to load the two SWs separately via UART. Solution: Bootloader crc control turns off. CRC control remains active inside the EC20 application and working at startup over the EC20 application.
SW Optimization - FSW_OFF Sequence Optimization - New Event: fsw_tim2_stop. (SWR-95) | The puls sequence is In the event that any STOP signal (HW_FSW, IOC_FSW, SYS_FSW) catches the pulse start (new sequence) just before the pulse is predicted on the CAN, the pulse generation is not performed, otherwise the sequence is fully executed - until now this time - start TIM3 - start of the entire sequence starting with raising the simmer current approx. 1.5mS before the prediction) - Better solution: Interrupting the sequence with the STOP signal is also timely for the time until the emission is predicted (the difference is approx. 1.5mS).
SW Optimization - Bank Emptying at Security Critical ERRs (L_DET, LS_DET, FSW_ERR,…) . (SWR-95) | With L_DET and LS_DET (leakage current detector), an ERR is reported and the bank remains full. Solution: Bank emitting after security critical ERR (L_DET, LS_DET, FSW_ERR, FSW_ON_ERR, FSW_OFF_ERR, FSWIOC_ERR)
SW Optimization - Optimizing Pulse Length Calculations: Data from IG_burst_puls_length_us. (SWR-95) | The IG_burst_puls_length_us data is also used for ordinary pulses (not just burst pulses) with the IGBT_pulse_length_hus transcript in the HEAT_STATE state machine.
Raising the maximum voltage on the bank from 430V to 439V. (SWR-95) | SWEEPS modes at short pulses do not reach the required input E. Voltage at 420V is too low. It needs to be raised to 439V. Solution: Increase the maximum permissible voltage on the bank from 430 to UART (or from 435 to CAN) to 439V at both interfaces and apply a maximum voltage of 439V (voltage rises by + 4.5%).

SW version | Official release – 1.0.0
Previous official version | Development version 0.8.31
Change request | Project status on 27. 08. 2019
Filename | EC20.hex
Build environment
Compiler | Armcc.exe V5.06 update 4 (build 422)
Middleware | Keil MDK-ARM Plus Version: 5.23
Other development tool / version changed? | /

Issue / Task | Implementation / Comment | Status (development / release)
Activated CRC in application – SWR-96 | In development releases, crc on the application was switched off - a shorter SW release process | Official release
Correction for mfpwm change (frequency within pulse). SWR-96 | When changing the mfpwm parameter (frequency within the pulse) to CAN or UART, no new data was taken into account on the EC20 on all parts of the SW. Correction is required on the UART report tt9 and when entering pwm via the UART command.
Added voltage display for energy measurements. SWR-96 | For testing purposes, a diagnostic bank voltage is added before and after each pulse, on the UART report in tt14.

SW version | 1.0.3
Previous official version | 1.0.0
Change request | I-8768
Filename | EC20.hex
Build environment
Compiler | Armcc.exe V5.06 update 4 (build 422)
Middleware | Keil MDK-ARM Plus Version: 5.23
Other development tool / version changed? | /

Issue / Task | Implementation / Comment | Status (development / release)
DOORSWITCH blocks operation | In emission state and after pressing the EMSTOP button or DOORSWITCH, laser operation is sometimes blocked. Solution: I terminated FSW_STATE 53 - the same role is taken by 51 and 52. | Implemented and released with change I-8768.
The EC20 controls the operation of SYSCTRL. | This control did not work. Solution: New event Foot_SW_tim_in_event = 1. The time is shortened from repetition + 350mS to repetition + 250mS. SYS does not send validation of the parameters of the heating pulse, so a reset of the meter is added in HEATSTATE = 1.
FSW_ON_ERR At short press FOOTSWITCH the system reports FSW_ON_ERR. | Diagnostic error fixed.

SW version | 1.0.8
Previous official version | 1.0.3
Change request | I-9148
Filename | EC20.hex
Build environment
Compiler | Armcc.exe V5.06 update 4 (build 422)
Middleware | Keil MDK-ARM Plus Version: 5.23
Other development tool / version changed? | /

Issue / Task | Implementation / Comment | Status (development / release)
Pulse profile | For test purposes, the pulse profile entry is enabled. On UART service communication is the new pwp command. Without entering pwp data, the laser's operation is unchanged. | Implemented and released with change I-9148
Error 0140-0002-000 (EC20 LNG_ERR) | When performing a calibration and when at EMISSION laser switch from 600uS mode to 1000us mode, sometimes LNG_ERR appears. The error is resolved.

SW version | 1.0.22
Previous official version | 1.0.8
Change request | I-9528
Filename | EC20.hex
Build environment
Compiler | Armcc.exe V5.06 update 4 (build 422)
Middleware | Keil MDK-ARM Plus Version: 5.23
Other development tool / version changed? | /

Issue / Task | Implementation / Comment | Status (development / release)
Diagnostics - The bank is not charged enough. | Before each pulse, the bank must be recharged to Uref. If the bank is not charged, the EC20 reports the ERR. The tolerance is 1.2V. SW error corrected: change of tolerance from 12V to 1.2V. | Implemented and released with change I-9528
Noise at ADC measurement. | The operation of the main power supply must be disabled when measuring the bank voltage on the ADC. SW error corrected: Timeout 150uS was implemented.
Flicker regulator correction. | The prediction algorithm must calculate the correct bank charging current. The error corrections in the controller during the bank charging itself are minimal. SW fault was corected: The Flicker regulator did not take into account the actual capacitance of the bank, but the nominal capacitance. An error in prediction was also entered when changing the number of oversampling on the ADC from 10 to 9 samples.
Conversion of SW to 500V. | It is necessary to raise the maximum voltage on the bank up to 500V and increase the operating range from 340..440V to 305..500V. All voltage measurements have been corrected and the basic unit has been changed, as well as all related calculations.
SYS support 500V. | The EC20 must indicate via the CAN bus which HW (420V / 500V) is used. Status bit was implemented: CAN address 140 (EC20_STATUS) byte 2 bit 0.
PWM pulse profile. | On the EC20 it is necessary to enable the entry of the data pwp1nr - the number of cycles of a 100kHz signal at the beginning of the pulse with 100% pwm. The UART command pwp1nr x is implemented, where x is between 0 and 10.
Flash pulse profile error. | The signal profile on the flash must be consistent with the data entered. At PWM > 85%, EC20 was added a short signal at the end of the pulse. SW was corrected: A value of 0% is added at the end of the signal generation table.
SWEEPS profile correction. | The pwp1nr data (number of cycles of a 100kHz signal within a pulse with 100% pwm) must be different for the main and each of the burst pulses. The UART command to pwp1nr x yy where x is the index (0 for normal pulses and 1..5 for the first to fifth burst pulse), and yy is the number of cycles with 100% PWM was implemented. Also CAN protocol was extended to the: CAN address 10Ah byte 1 bit 0..5
Change default pwp1nr. | The default data of pwp1nr must be equal to 0 for the main and each of the burst pulses. This allows compatible SW operation backwards. The previously entered data at EC20 initialization, which was 4, 3, 2, 2, 2, 2, was deleted.

SW version | 1.1.0
Previous official version | 1.0.22
Change request | I-10136
Filename | EC20.hex
Build environment
Compiler | Armcc.exe V5.06 update 4 (build 422)
Middleware | Keil MDK-ARM Plus Version: 5.23
Other development tool / version changed? | /

Issue / Task | Implementation / Comment | Status (development / release)
Disable EC20 service operation if the laser is switched on and the FSW is in the activated state | In the main state machine, the transition over state FSW_STATE = 10 is cleared | Implemented and released with change I-10136.
Extend the time window in which the EC20 expects SYS confirmation when the HW FSW line is interrupted | In the main state machine FSW_STATE = 55, waiting 250ms is extended to 500ms

SW version | 1.1.8
Previous official version | 1.1.0
Change request | I-9925
Filename | EC20.hex
Build environment
Compiler | Armcc.exe V5.06 update 4 (build 422)
Middleware | Keil MDK-ARM Plus Version: 5.23
Other development tool / version changed? | /

Issue / Task | Implementation / Comment | Status (development / release)
SWEEPS: Correction of the distance between the pulses. | When setting the pulse spacing stm (in dual pulse mode), the pulse spacing must be taken into account from the beginning of the first pulse front to the beginning of the second pulse front. Preliminary SW: the spacing is between the pulses. | Implemented and released with change I-9925.
SWEEPS: Realization of shorter pulses. | The pulse length setting must have a range of 15 us - 120 us.
Syntax error in SMOOTH functionality. | False bnr is set at startup (fbnr = 1).
SMOOTH functionality. | SW does not affect functionality until it is turned on - it will be used and tested in later versions.
SWEEPS endo functionality. | Energy regulation with one pulse width at 100% PWM
SWEEPS main functionality. | Energy regulation with two pulse widths at 100% PWM and 13nS resolution and determination of pulse spacing.
Simmer current shutdown diagnostic error. | At FSW_OFF during preheating pulses, EC20 generates a false ERR.
IGBT failure protection testing. | This is a test SW, is verified and is not active.
Syntax error in diagnostic printout can data. | When using trace, a bit was generated in the pwp table.

SW version | 1.2.4
Previous official version | 1.1.8
Change request | I-10804
Filename | EC20.hex
Build environment
Compiler | Armcc.exe V5.06 update 7 (build 960)
Middleware | Keil MDK-ARM Plus Version: 5.33
Other development tool / version changed? | /

Issue / Task | Implementation / Comment | Status (development / release)
R-SWEEPS and SWEEPS | On the EC20, R-SWEEPS and SWEEPS are supported with the same functionality. The stm parameter is extended from the existing limit of 900uS + spln1 to 1800uS + spln1. Data corrected to CAN10Bh and UART. CAN: Because the upper limit exceeds 2 bytes of FFFFh, the before unused byte[7] is used for the heaviest bit. In SW, stm time is performed in two parts: stm1 and stm2. The new mode shifts SW operation from states 14 and 15 to states 24, 124 and 25. | Implemented and released with change I-10804
Laboratory tests - very strong pulse > 103J | laboratory tests: When calculating the input E of a very strong pulse (approx. 103J) the values exceed the range of 32bit (FFFFFFFFh) max unsigned int. The error has been fixed. The calculation method has changed.
Correction of stm data entry on the UART | Service communication: Correction of stm data entry on the UART console: the distance between sweeps pulses is entered from 1.f of the first to 1.f of the second pulse. Correction of printouts on the UART console: printouts were incorrect to the decimal place. The error has been fixed.
Additional 0.3uS pulse is generated | When generating a flash signal, an additional 0.3uS pulse is generated at the end with a delay of 2.7uS. The pulse is due to improper termination of the process. The problem is solved.
Diagnostic pulses | Diagnostic pulses were included in the IGBT signal generation routine. The problem has been fixed.

SW version | 1.3.1
Previous official version | 1.2.4
Change request | I-11229
Filename | EC20.hex
Build environment
Compiler | Armcc.exe V5.06 update 7 (build 960)
Middleware | Keil MDK-ARM Plus Version: 5.33
Other development tool / version changed? | /

Issue / Task | Implementation / Comment | Status (development / release)
New parametric data from SYS to EC20 diagnostic: in case of SYS non-response. | With the new data on CAN 0x104 byte [4], the SYS parametrically extends the WAIT in the EC20 on the diagnostics, on the basis of which the EC20 reports the ERR in case of SYS non-response. The data (mode of operation when the entry is different from 0) is used in the calibration. In normal mode, the SW remains unchanged. | Implemented and released with change I-11229.

SW version | 1.3.4
Previous official version | 1.3.1
Change request | I-11986
Filename | EC20.hex
Build environment
Compiler | Armcc.exe V5.06 update 7 (build 960)
Middleware | Keil MDK-ARM Plus Version: 5.33
Other development tool / version changed? | /

Issue / Task | Implementation / Comment | Status (development / release)
Unreliable simmer current ignition | During the cold start of the laser - during the transition from STANDBY to READY, it occasionally happens that the flash at 8kV and the pulse of 300mS do not turn on the simmer current. The result is a false error 0140-0000-0000 (Flash or cable isolation error.). SW EC20 changed: If the simmer ignition attempt fails, the ignition process is repeated up to 5 times | Implemented and released with change I-11986.
A new CAN message from EC20 to ENM | Service communication in production. The pulse length is set via the pln command. However, the maximum pulse length remains set on the ENM. A new CAN message 0x182 [6] 00 01 30 75 LL HH has been added to EC20 where HHLL -> 16 bit unsigned flahs pulse value in us. The EC20 transmits a message against the ENM via the console command pln. After starting the processor, the pln value is set to 20uS, which ensures that the pln command is definitely used when setting the parameters.
Unreliable CRC calculation | The CRC calculation when reading data from FLASH is unreliable. EC20 reported IAP_ERR = 1; A minimum delay is added between the switch to turn on the CRC unit and clear the CRC-DR register.
A new CAN message from EC20 to ENM – bug fix | Fixed bug: default pln was reset to 350uS. The CAN message is transmitted before generating an IGBT pulse when switching from READY to EMISSION, only in service mode.
Unreliable simmer current ignition – bug fix | If the cimmer current fails, there is a short (1mS) false transition to the STANDBY / READY / STANDBY status. A 5mS filter on the SIM_DET signal is installed.

SW version | 1.3.6
Previous official version | 1.3.4
Change request | I-12436
Filename | EC20.hex
Build environment
Compiler | Armcc.exe V5.06 update 7 (build 960)
Middleware | Keil MDK-ARM Plus Version: 5.33
Other development tool / version changed? | /

Issue / Task | Implementation / Comment | Status (development / release)
Diagnostic failure has been fixed | The working IGBT on the EC20 power supply in the laboratory failed. An error in the diagnostic SW was found during data analysis: When working with the console and IGBT failure on the preheating pulse, the hlng data setting (preheating pulse length) for LNG_ERR diagnostics is overwritten with the lng data of the main / burst / sweeps pulse. The error made with change V1.1.0 has been fixed. | Implemented and released with change I-12436.
New QSP mode | The new QSP mode is made as an extension of the existing SSP ENDO and SWEEPS modes from 2 to 5 pulses per package. SW is backwards compatible. the swm data now ranges from 0 to 5 and a new 10Ch CAN message is created.

SW version | 1.4.1
Previous official version | 1.3.6
Change request | I-12964
Filename | EC20.hex
Build environment
Compiler | Armcc.exe V5.06 update 7 (build 960)
Middleware | Keil MDK-ARM Plus Version: 5.33
Other development tool / version changed?

Issue / Task | Implementation / Comment | Status (development / release)
SMOOTH diagnostic correction | SW correction on the diagnostics of SMOOTH functionality - the control at the end of the SMOOTH period is performed. The SW corection allows dynamic parameters to be changed during operation. The minimum time to complete for the processes correctly was changed. The time is calculated from the sprt and snr console/CAN command parameters. | Implemented and released with change I-12964.
Simmer ignition sequence optimisation | The results of the tests showed the sense of increasing the max number of pulses to 15. The pulse time was shortened to from 300 to 100mS, the pause time between pulses was reduced from 200mS to 150mS. The length of the entire sequence is approx. 4s.
Diagnostic: printout voltages of flash ignition | A diagnostic printout voltages in volts is required for simmer current ignition proces. Service comand tt 8 F4: A printout of last 10 samples (every sample per 1mS) is made in line. There is 15 lines of data max.
replacing the old HV_Count_ERR is replaced by two new ones FLASH_ERR and P_CABLE_ERR | Failure on ignition the simmer current results in HV_Count_ERR. The cause can be a short circuit or too short distance on the flash cables (broken isolation), or a bad flash. A more accurate detection of the cause of the error is made. At the end of the flash ignition sequence, the voltage of the generator is checked, and at >7.5kV it reports FLASH_ERR otherwise P_CABLE_ERR.

Unresolved anomalies, bugs and defects:

There are no known faults or defects detected.

# INPUT / OUTPUT CONTROL MODULE (IOC), id. 99372

SW version | 0.11, initial version
Previous official version | /
Change request | Project status on 20. 09. 2017
Filename | SkyPulse.hex
Build environment
Compiler | Keil Uvison V5.23.0.0
Middleware | /
Other development tool / version changed? | /

Issue / Task | Implementation / Comment | Status (development / release)
HW SW | HW control functions implemented pump fan pressure sensors valves temp. sensors Basic CAN protocol implemented status control remote console Error handling Temp. Console functionality | Development phase

SW version | Development version 0.13
Previous official version | Development version 0.11
Change request | Project status on 27. 03. 2018
Filename | SkyPulseIOC2.hex
Build environment
Compiler | Keil Uvison V5.23.0.0
Middleware | /
Other development tool / version changed? | /

Issue / Task | Implementation / Comment | Status (development / release)
HW | New HW control functions implemented - emergency crowbar - cooler flow sensor - LED interface - isolated footswitch interface - add footswitch serial port - speaker driver | Development phase
SW | SW functionality implemented - flow sensor implementation - spray setup console - error & handling functionality - add. CAN comms added - minor bugs & code cleaning

SW version | Development version 0.20
Previous official version | Development version 0.13
Change request | Project status on 20. 08. 2018
Filename | SkyPulse.hex
Build environment
Compiler | Keil Uvison V5.23.0.0
Middleware | STM32Cube FW_F4 V1.21.0
Other development tool / version changed? | STM32CubeMX V4.25.0

Issue / Task | Implementation / Comment | Status (development / release)
Build | This is rewritten version - the project structure, peripheral initialization and startup generated by STM32CubeMX tool. Also using STM HAL libraries, FreeRTOS and FatFs middleware. | Development phase
| The SkyPulseNucleo and Lcd subsets from the project tree as well as the USB stack are used for development and emulation purposes only an will be removed.
Spray Setup (Service) | Cubic fit was implemented to evaluate the air-to-bottle backpressure.
Error Management | Minor modifications to the IOC to SYS CAN protocol.

SW version | Development version - 0.23
Previous official version | Development version 0.20
Change request | Project status on 23. 11. 2018
Filename | SkyPulse.hex
Build environment
Compiler | Keil Uvison V5.23.0.0
Middleware | STM32Cube FW_F4 V1.21.0
Other development tool / version changed? | STM32CubeMX V4.25.0

Issue / Task | Implementation / Comment | Status (development / release)
- flow sensor | - support for HW V1.3 added, - flow sensor control added, - console modification. | Development phase - testing house
- DL | - DL control functionality added (upper limit crowbar, - CAN protocol updated, - diagnostic message list updated.
- error handling | - rewritten to avoid CAN overload due to the continuous errors, - timing & operational mode checks added for EC20, DL and SYS... according to risk analysis & CAN timing diagram.

SW version | Development version - 0.26
Previous official version | Development version 0.23
Change request | Project status on 18. 03. 2019
Filename | SkyPulse.hex
Build environment
Compiler | Keil Uvison V5.23.0.0
Middleware | STM32Cube FW_F4 V1.21.0
Other development tool / version changed? | STM32CubeMX V4.25.0

Issue / Task | Implementation / Comment | Status (development / release)
Cooler dual temp. sensor | An error message was implemented to indicate difference in measurement greater than ~2 degrees | Development phase - release for testing house
| The highest temp. allowed is set to 55 deg.
DL energy control | A dual averaging reference filter was introduced to control DL photodiode sensors response in real time.
| CAN protocol updated; messages from DL and SYS are used to compile ref. filter parameters
EC20 overheat | A separate console for DL (F4)
| Four different levels for cooling fan, controlled by SYS
Bug: when used, spray remained active in case of other, non related system failures | CAN protocol updated

SW version | Development version - 0.29
Previous official version | Development version 0.26
Change request | Project status on 02. 07. 2019
Filename | SkyPulse.hex
Build environment
Compiler | Keil Uvison V5.23.0.0
Middleware | STM32Cube FW_F4 V1.21.0
Other development tool / version changed? | STM32CubeMX V4.25.0

Issue / Task | Implementation / Comment | Status (development / release)
Bug was found on DL control module synchronization | During the operation, IOC is continuously following the DL performance by means of a matching lowpass filter, averaging and comparing the DL photodiode response with the preset values from the SYS. The matching filter should be synchronized with the currently active channel ( not only the channel 1 as before) | Development phase
Console modification | Within the IOC console and for testing purposes only, it is possible to mask (enable/disable) individual errors. The possibility to activate all errors at once was removed, since it can cause the overflow of the CAN bus and block the system controller.

SW version | Official release - 1.00
Previous official version | Development version 0.29
Change request | Project status on 27. 08. 2019
Filename | SkyPulse.hex
Build environment
Compiler | Keil Uvison V5.23.0.0
Middleware | STM32Cube FW_F4 V1.21.0
Other development tool / version changed? | STM32CubeMX V4.25.0

Issue / Task | Implementation / Comment | Status (development / release)
Fiber Tip Replacement mode support added | Following a specific combination of spray parameters in the SYS CAN message, an adequate configuration on valves overrides the existing spray regulator, thus reducing the water and dirt contamination in the inner space of the handpiece by air flow. | Official release
Pump slow start | The pump cavitation noise is reduced by means of faster pump-on interval.

SW version | 1.0.1
Previous official version | 1.0.0.
Change request | I-9498
Filename | SkyPulse.hex
Build environment
Compiler | Keil Uvison V5.23.0.0
Middleware | STM32Cube FW_F4 V1.21.0
Other development tool / version changed? | STM32CubeMX V4.25.0

Issue / Task | Implementation / Comment | Status (development / release)
Pump diagnostnics delay | After switching on, diagnostics/supervising of the cooling subsystem requires a 3 secs delay to allow the sensors to set up. Due to the recent changes of the filter/flow sensor, this delay was increased to 6 secs to allow the startup after refill. | Implemented and released with change I-9498

SW version | 1.0.5
Previous official version | 1.0.1
Change request | I-9369
Filename | SkyPulse.hex
Build environment
Compiler | Keil Uvison V5.23.0.0
Middleware | STM32Cube FW_F4 V1.21.0
Other development tool / version changed? | STM32CubeMX V4.25.0

Issue / Task | Implementation / Comment | Status (development / release)
Additional fan boost | Fan boost level (85%) added for DL application. IOC state req. message (0x200) format modified accordingly | Implemented and released with change I-9369.
Thermal shutdown limit | Changed to 60 degrees C
DL power sensing | DL power sensing ADC signals tested for DL module presence. Irregular states also detected, generating errors 18 & 19.. New CAN req/ack messages introduced accordingly (0x205, 0x245)

SW version | 1.0.6
Previous official version | 1.0.5
Change request | I-10397, I-10611, I-10295
Filename | SkyPulse.hex
Build environment
Compiler | Keil Uvison V5.30.0.0
Middleware | STM32Cube FW_F4 V1.25.0
Other development tool / version changed? | STM32CubeMX V6.0.1

Issue / Task | Implementation / Comment | Status (development / release)
DL power sensing, tandem mode support | Modifications of the DL power sensors support and CAN protocol; IOC is tracking the parameters setup messages between SYS and DL to synchronize with the expected emission timing and level. | Implemented and released with change I-10397 .
IOC spray parameters modification | The maximum air and water levels were modified to match other products portfolio. | Implemented and released with change I-10611 .
IOC board (id 9430) hardware modifications support | The newly added float switch status diagnostic support (cooling level low, error 0240-0015-0000 added). | Implemented and released with change I-10295.
| Protective foot switch branch is now separated for DL and EC modules. IOC is tracking parameters setup messages between SYS, DL and EC, thus enabling individual protection accordingly.
| For compatibility with the older devices, the IOC board HW coding is added.
Other | False errors, related to foot switch hot plugin are now eliminated.
| Temperature sensor error 0240-0014-0000 generated if cooling liquid temperature below zero or sensors missing.

SW version | 1.0.7
Previous official version | 1.0.6
Change request | I-10804
Filename | SkyPulse.hex
Build environment
Compiler | Keil Uvison V5.30.0.0
Middleware | STM32Cube FW_F4 V1.25.0
Other development tool / version changed? | STM32CubeMX V6.0.1

Issue / Task | Implementation / Comment | Status (development / release)
Bug - due to IOC board (id 9430) hardware modifications, foot switch must be explicitly routed to selected device. The latter was omitted for DL Calibration mode. | DL calibration mode CAN request message from SYS is received by IOC as well, thus enabling DL to use foot switch. | Implemented and released with change I-10804.

SW version | 1.0.8
Previous official version | 1.0.7
Change request | I-11458
Filename | SkyPulse.hex
Build environment
Compiler | Keil Uvison V5.30.0.0
Middleware | STM32Cube FW_F4 V1.25.0
Other development tool / version changed? | STM32CubeMX V6.0.1

Issue / Task | Implementation / Comment | Status (development / release)
Bug – if pump was stopped due to the error 0240-0007-0000 or 0240-000B-0000, the error was latched and could be reset through general reboot of the IOC module only. | The pump error status is now reset on pump soft start as well. | Implemented and released with change I-11458.

SW version | 1.1.0
Previous official version | 1.0.8
Change request | I-12436
Filename | SkyPulse.hex
Build environment
Compiler | Keil Uvison V5.30.0.0
Middleware | STM32Cube FW_F4 V1.25.0
Other development tool / version changed? | STM32CubeMX V6.0.1

Issue / Task | Implementation / Comment | Status (development / release)
CAN protocol update | The pump current consumption data added to the idIOC_AuxAck (0x243) message | Implemented and released with change I-12436.

SW version | 1.1.1
Previous official version | 1.1.0
Change request | I-13217
Filename | SkyPulse.hex
Build environment
Compiler
Middleware
Other development tool / version changed?

Issue / Task | Implementation / Comment | Status (development / release)
CAN protocol updated to enable spray water gain adjustment SYS | The existing spray setup CAN message is updated with a new parameter to dynamically control max. amount of spray water from 0-255% of the default setup. The presence of the parameter is tested to provide backward compatibility with the older SYS SW versions. | Implemented and released with change I-13217.

Unresolved anomalies, bugs and defects:

There are no known faults or defects detected.

# ENERGY METER MODULE (EM), id. 99815

SW version | 0.6.0
Previous official version | /
Change request | Project status on 20. 09. 2017
Filename | EM.hex
Build environment
Compiler | XC16 v1.30
Middleware | MPLAB X IDE v3.51
Other development tool / version changed? | /

Issue / Task | Implementation / Comment | Status (development / release)
Flash light detection | Flash light trigger INT2Interrupt | Development phase
Energy measurement | Every 20us temporary energy is calculated, at the end of measurement interval final energy is calculated.
Driving laser pointer | PWM1 is used.
Crowbar function | If temporary energy goes over threshold value, crowbar is activated.
CAN communication | Communication with other parts of laser system.

SW version | Development version 0.8.0
Previous official version | Development version 0.6.0
Change request | Project status on 20. 08. 2018
Filename | EM.hex
Build environment
Compiler | XC16 v1.30
Middleware | MPLAB X IDE v3.51
Other development tool / version changed? | /

Issue / Task | Implementation / Comment | Status (development / release)
CAN Bootloader | Program memory for bootloader 0x000000 – 0x001FFE, for application >= 0x002000. Bootloading does not disturb calibration data. CRC of app. program memory is calculated in bootloader. | Development phase
Energy measurement when laser pulse duration is extended. | If flash light pulse duration is greater than predicted value, measurement interval is prolonged.

SW version | Development version – 0.10.0
Previous official version | Development version 0.8.0
Change request | Project status on 23. 11. 2018
Filename | 99815_FW_SKYPULSE_EM.hex, Enm_7.h, Eni_7.c, p33FJ64MC802.gld
Build environment
Compiler | C30(v3_31)
Middleware | MPLAB X IDE v4.10
Other development tool / version changed? | /

Issue / Task | Implementation / Comment | Status (development / release)
Laser pointer is on only when system is in ready or in action mode. | CAN message with SID 0x240 has this information. | Development phase - testing house

SW version | Development version – 0.11.0
Previous official version | Development version 0.10.0
Change request | Project status on 18. 03. 2019
Filename | 99815_FW_SKYPULSE_EM.hex, Enm_7.h, Eni_7.c, p33FJ64MC802.gld
Build environment
Compiler | C30(v3_31)
Middleware | MPLAB X IDE v4.10
Other development tool / version changed? | /

Issue / Task | Implementation / Comment | Status (development / release)
Laser head serial number is memorized in energy meter. | Serial number is add to communication protocol and memorized in flash memory. | Development phase - release for testing house

SW version | Development version – 0.14.2
Previous official version | Development version 0.11.0
Change request | Project status on 02. 07. 2019
Filename | 99815_FW_SKYPULSE_EM.hex, Enm_7.h, Eni_7.c, p33FJ64MC802.gld
Build environment
Compiler | C30(v3_31)
Middleware | MPLAB X IDE v5.10
Other development tool / version changed? | /

Issue / Task | Implementation / Comment | Status (development / release)
Laser pointer switch on current can't disturb CAN communication. | Laser pointer is switched on after result of laser energy is sent. | Development phase
Laser pointer has to be off when Er laser is not selected.. | CAN message with SID 0x140 has information when Laser pointer has to be on or off.

SW version | Official release – 1.0.0
Previous official version | Development version 0.14.2
Change request | Project status on 27. 08. 2019
Filename | 99815_FW_SKYPULSE_EM.hex, Enm_7.h, Eni_7.c, p33FJ64MC802.gld
Build environment
Compiler | C30(v3_31)
Middleware | MPLAB X IDE v5.10
Other development tool / version changed? | /

Issue / Task | Implementation / Comment | Status (development / release)
EM has to memorize type of laser head | Type is memorized in flash memory. | Official release

Unresolved anomalies, bugs and defects:

There are no known faults or defects detected.

# DIODE LASER MODULE (DL), id. 99831

SW version | 0.1.0
Previous official version | /
Change request | Project status on 20. 09. 2017
Filename | DL.hex
Build environment
Compiler | Armcc.exe V5.06 update 5 (build 528)
Middleware | Keil MDK-ARM Essential Version: 5.24.2.0
Other development tool / version changed? | /

Issue / Task | Implementation / Comment | Status (development / release)
Diode laser current regulation | PWM control of buck converter with regulation loop for diode current set by parameter. Diode current is set for pulse operation with pulse width and frequency set with parameters. | Development phase
Peltier module control | PWM control of buck converter with option to manually set duty cycle.
CAN communication | TX and RX support for communication with system controller.
Measuring parameters | Peltier and diode laser output voltage, diode current, photo diode current 1 and 2, input voltage, diode temperature, diagnostic signal from power supply IC for diode supply, pilot light intensity
Analog watchdogs | Constant monitoring of diode laser voltage, current and peltier voltage with safety shutdown outside of set parameters.
UART service console | Console interface for setting parameters and printing measurements. This option is used in operation during laboratory testing with option to send UART data through CAN to system.

SW version | Development version 0.2.0
Previous official version | Development version 0.1.0
Change request | Project status on 27. 03. 2018
Filename | DL.hex
Build environment
Compiler | Armcc.exe V5.06 update 5 (build 528)
Middleware | Keil MDK-ARM Essential Version: 5.24.2.0
Other development tool / version changed? | /

Issue / Task | Implementation / Comment | Status (development / release)
Diode module parameters | Each type of diode module has it's own structure of parameters which can be chosen regarding HW selector or SW data. | Development phase
Diode laser current regulation | Added differential part to regulation controller for improving rise time of current pulses and option to have different regulator constants for each diode module.
Average power monitoring | During operation signal from photodiode is sampled and compared with expected value. With this the current reference is changed to have average output less than 20% different from set value.
Peltier module control | Changed temperature limits and improved temperature hysteresis when limits are reached.
Measuring parameters | Added input voltage measurement after input safety chip for better diagnostics.
CAN communication | Added CAN messages for communication with system. Sending and receiving status with errors and receiving parameters for operation.
Footswitch detection | Detecting hardware line of footswitch signal with implementation of timeout between signal and CAN message.
System states with indicator | Depending on operation the system operates with state machine which changes states by request from system with CAN message or manual control in service menu with console. Depending on state the color of status LED is changed.
UART service console | Added more commands to operate diode laser from service console. Easier time settings, commands for changing system states, improved error information, enter of calibration points with option to write and get information on stored values. Improved console command parser function.
Calibration routine | Functions to measure data during calibration procedure for calculating constants between measured parameters and external power meter. Added console and CAN controlled calibration with read and write functions to save data with safety crc calculations.
Watchdog | Implemented independent SW watchdog for periodically checking if main program is running.
HW configuration | Changed HW defines for MCU inputs/outputs for use on new version of HW 100111_TV DL.

SW version | Development version 0.3.0
Previous official version | Development version 0.2.0
Change request | Project status on 20. 08. 2018
Filename | DL.hex
Build environment
Compiler | Armcc.exe V5.06 update 5 (build 528)
Middleware | Keil MDK-ARM Essential Version: 5.24.2.0
Other development tool / version changed? | /

Issue / Task | Implementation / Comment | Status (development / release)
Diode module parameters | Added new structure of parameters for second wavelength in double modules and variables for saving two sets of prediction data. | Development phase
Average power monitoring | Added average input power measuring with operational limits and additional limits for difference between input and output power.
Peltier module control | Added new algorithm for controlling module based on linear relation between temperature and cooling intensity.
Self-test | Routine for testing HW functionality (safety actuators, current sense test, CAN test, HW safety loop test synchronous with system test).
CAN communication | Added new CAN messages for sending module information and SW version to system. Added parameter message for double diodes and message for sending output power limits to IOC.
UART service console | Added new commands for controlling diodes with 2 wavelengths. Optimized texts for less resource use and added more information to periodically write to console on command.
Initialization changes | Changed initial setup for CAN, UART and DAC for less resource use.
Double wavelength diode support | Added function for handling switching between different wavelengths in dual modules. The function chooses structure of diode parameters, prediction values and sets analog watchdog limits depending on which wavelength is chosen.
Double wavelength pulse control | Routine controls switching between two wavelengths inside of emission state. Each wavelength has it's own working parameters structure and active time after which routine switches to other wavelength.
Footswitch timer | Depending on received data the system monitors duration of emission state and stops emission when time reaches set value.
Generalized monitoring of photodiode channels | Added new analog watchdog for the second photodiode channel. Each wavelength has set it's active photodiode channel in diode parameters. This channel has active watchdog limit with data acquisition for average power monitoring.

SW version | Development version – 0.4.0
Previous official version | Development version 0.3.0
Change request | Project status on 23. 11. 2018
Filename | DL.hex
Build environment
Compiler | Armcc.exe V5.06 update 5 (build 528)
Middleware | Keil MDK-ARM Essential Version: 5.24.2.0
Other development tool / version changed? | /

Issue / Task | Implementation / Comment | Status (development / release)
Diode module parameters | Added support for new modules and made changes to default parameters of existing modules. | Development phase - testing house
Average power monitoring | Improved algorithm for average power monitoring with more precise regulation and more reliable limits.
Peltier module control | Removed option to regulate temperature regarding set reference. Regulation uses linear relation between temperature and cooling.
Self-test | Added new test and optimized sequence of performed tests.
CAN communication | Added re-transmission with improved error handling. Added new message for IOC pinging and calibration.
UART service console | Removed unused commands, optimized texts for writing to console. Added new commands for inputting diode specific parameters. Added use of compact version of printf function.
Initialization changes | Optimized initial setup for GPIO.
IOC communication | Added sending and receiving ping between DL and IOC and with error at missing response while in emission. Added function for calculating limits for each of 2 photodiode channels.
Diagnostics | Added new diagnostics for monitoring voltage after power switch.
Analog watchdog | Added new functions to easily set new limits for each individual watchdog.
Calibration | Added upgrade to the calibration procedure which includes calculation of operational limits from input parameters specific to each diode.

SW version | Development version – 0.4.5
Previous official version | Development version 0.4.0
Change request | Project status on 18. 03. 2019
Filename | DL.hex
Build environment
Compiler | Armcc.exe V5.06 update 5 (build 528)
Middleware | Keil MDK-ARM Essential Version: 5.24.2.0
Other development tool / version changed? | /

Issue / Task | Implementation / Comment | Status (development / release)
Diode module parameters | Made changes to default parameters of existing modules. | Develop. phase – release for testing house
Average power monitoring | Added option for second type of regulation of energy with few minor changes to limits.
Calibration | Added 3 points calibration procedure with calculations for linear parameters. Added block for ready state if no calibration is present. Included measurement of photodiode offset in ready state with effect on adjusting IOC limits.
PWM | Moved location of setting PWM inside regulation loop for better time determinism. Similarly changed delays inside self-test for more repeatability.
UART service console | Added new commands for calibration.
Error handling | Changed handling of FSW error for elimination of false errors in limit cases.

SW version | Development version – 0.4.13
Previous official version | Development version 0.4.5
Change request | Project status on 02. 07. 2019
Filename | DL.hex
Build environment
Compiler | Armcc.exe V5.06 update 5 (build 528)
Middleware | Keil MDK-ARM Essential Version: 5.24.2.0
Other development tool / version changed? | /

Issue / Task | Implementation / Comment | Status (development / release)
Diode module parameters | Made changes to default parameters and prediction calculations of existing modules. Adjusted calibration points of diode modules for new calibration procedure. Changed parameters of test diodes for use with test device. | Development phase
UART service console | Optimized console commands and texts for additional space. Some non critical commands removed.
Calibration (SWR-81) | Routine changed for calibration up to 6 points. Points are saved directly into flash instead of calculated linear curve parameters. Depending on reference appropriate 2 points are selected and interpolation between 2 points is calculated. Functions calculating relations between input current, output power and photodiode signals were changed for interpolation approach. Functions for reading and writing calibration to flash were changed for different data.
Pilot laser | Added new function for more clean setting of brightness. When entering ready state measurement of photodiode offset is activated for compensating effect of the pilot laser.
Diagnostics | Added diagnostics to monitor active channel through voltage monitoring on both channels (only for diodes with 2 laser sources).
Average power monitoring | Added changes to diagnostics for changed relations between power, input current and photosignals which are calculated with interpolation. Improved diagnostics for monitoring output power bellow threshold interval.
Handpieces | Added support for multiple different handpieces. Each handpiece has it's own calibration data package saved in flash. Calibration routine is done for each handpiece separately. Handpieces are swapped with CAN message on system demand. For reading correct handpiece data from flash search function was added.
Self-test | Added changes to solve occasional false errors. Active channel diagnostic included in routine.
CAN | Added new error for active channel diagnostics.
LEDs | Changed LED operation according to service manual for easier troubleshooting.

SW version | Official release – 1.0.0
Previous official version | Development version 0.4.13
Change request | Project status on 27. 08. 2019
Filename | DL.hex
Build environment
Compiler | Armcc.exe V5.06 update 5 (build 528)
Middleware | Keil MDK-ARM Essential Version: 5.24.2.0
Other development tool / version changed? | /

Issue / Task | Implementation / Comment | Status (development / release)
Diode module parameters | Made changes to default parameters and prediction calculations of existing modules. | Official release
Double mode of operation | Added corrections to switching times for channel 1 and 2 to compensate off time needed to reconfigure parameters. Added sending IOC limits on channel switch.
Regulation loop | Moved location of setting PWM inside the loop for better time determinism.
Self-test | Added changes for more time determinism for activating buck converter and more robust triggering of photodiode signals during procedure.
Average power monitoring | Added changes to provide accurate monitoring with double mode of operation when switching channel 1 and 2. Included limits for reference value for reliable regulation of very short pulses.
CAN | Added correction for foot switch timer return message.

SW version | 1.0.10
Previous official version | 1.0.0
Change request | I-9369
Filename | DL.hex
Build environment
Compiler | Armcc.exe V5.06 update 5 (build 528)
Middleware | Keil MDK-ARM Essential Version: 5.24.2.0
Other development tool / version changed? | /

Issue / Task | Implementation / Comment | Status (development / release)
Status LED | Color of status LED changed from red to green in ready and emission state. | Implemented and released with change I-9369.
Handpieces | Added more efficient management of different handpieces. Similar handpieces can take data from the same calibration with fitting factors. Limited maximum number of handpieces.
Calibration | Added trimming of calibration points during calibration. With dual modules if wavelength is not compatible with handpiece it can be skipped. Adjusted CAN messages for new functionality. Added additional statements to trigger calibration error if calibration is not present. Adjusted limits for input of calibration parameters to accommodate diversity of laser modules.
Diagnostics | Adjusted FSW diagnostic so that it doesn't interfere with the same diagnostics on SYS. On emission transition additional test is performed to check for possible data corruption of wavelength set parameters..
CAN communication | Added ping message between SYS and DL during emission. Improved resolution of power. For wavelength select in parameter message direct value from pin control register is returned instead of stored value. Limits for IOC are changed when DL stops emission – IOC reference signal is better synchronized with actual signal.
Temperature management | Added storage temperature limit when diode is not active with separate error. Adjusted Peltier module upper voltage limit. Removed cooling restriction for non critical errors.
Self-test | Adjusted limits to remove temperature dependency at startup. Moved channel diagnostics from self test to transition to ready state.
Average power monitoring | Added temperature compensation for input power for more accurate measurements.
Module parameters | Removed configurations for obsolete diode modules. Adjusted configurations for active modules to reduce false diagnostics errors.

SW version | 1.0.12
Previous official version | 1.0.10
Change request | I-9747
Filename | DL.hex
Build environment
Compiler | Armcc.exe V5.06 update 5 (build 528)
Middleware | Keil MDK-ARM Essential Version: 5.24.2.0
Other development tool / version changed? | /

Issue / Task | Implementation / Comment | Status (development / release)
MarcCo handpieces | Added calibration factors for MarcCo handpieces. | Implemented and released with change I-9747.
Diagnostics | Added correction to upper current limits, that triggered with some XD-67/10 modules.
Calibration | Changed bounds checking for photo signal parameter that is entered before calibration.

SW version | 1.0.16
Previous official version | 1.0.12
Change request | I-10397
Filename | DL.hex
Build environment
Compiler | Armcc.exe V5.06 update 6 (build 750)
Middleware | Keil MDK-ARM Essential Version: 5.31.0.0
Other development tool / version changed? | /

Issue / Task | Implementation / Comment | Status (development / release)
CAN communication | Added additional data transmitted between SYS and DL to accommodate tandem mode with dual diodes. Modified existing data sent to IOC to add limits on both channels when operating in tandem mode. | Implemented and released with change I-10397.
IOC synchronization | Modified existing triggers with normal and timer operation for better synchronization between DL and IOC.
Tandem operation | Added corrections to the operation of the tandem state machine.

SW version | 1.1.0
Previous official version | 1.0.16
Change request | I-11057
Filename | DL.hex
Build environment
Compiler | Armcc.exe V5.06 update 4 (build 422)
Middleware | Keil MDK-ARM Plus Version: 5.23
Other development tool / version changed? | /

Issue / Task | Implementation / Comment | Status (development / release)
CAN communication | CAN protocol supports reading of saved manufacturer's diode module test data | Implemented and released with change I-11057.

Unresolved anomalies, bugs and defects:

There are no known faults or defects detected. However, when entering module specific parameters during calibration, error might occur if values are not in specific range. As modules can differentiate more than set tolerance broader approach is required.

# FOOT SWITCH PRO (FSW), id. 99765, 99766

SW version | 0.1
Previous official version | /
Change request | Project status on 20. 09. 2017
Filename | OMNISWITCH_TX.HEX (99765) OMNISWITCH_RX.HEX (99766)
Build environment
Compiler | XC8 v1.42
Middleware | MPLAB X IDE v3.65
Other development tool / version changed? | /

Issue / Task | Implementation / Comment | Status (development / release)
Hall sensor voltage measure (omniswitch-tx) | Turning off and on hall sensor and measuring voltage (magnet position) | Development phase
Battery low indication (omniswitch-tx) | Going to idle mode and blinking with led when not pressed (Timer 3)
RS232 communication (omniswitch-tx) | Sending information of hall sensor voltage to determine the position of the magnet – enables optional control of laser repetition
Channel hopping (omniswitch-tx) | Receiving information of new channel (less noise) from dongle (omniswitch-rx) and switch to the new channel
Missed receive alert (omniswitch-rx) | If no reception for more than 300ms, put output to released position with a short beep
Scan noise (omniswitch-rx) | After reception, scan one channel. If scanned channel has less noise than working channel, send it to footswitch (omniswitch-tx)
Self-tests added (omniswitch-tx, omniswitch-rx) | After inserting the battery (FSW, omniswitch-tx) or turning laser device on (dongle, omniswitch-rx) the following self-tests are carried out: CRC Checkerboard CRCFlashTest CRCEEPROMTest CPUPCTest(program counter)

SW version | Development version 0.2
Previous official version | Development version 0.1
Change request | Project status on 27. 03. 2018
Filename | OMNISWITCH_TX.HEX (99765) OMNISWITCH_RX.HEX (99766)
Build environment
Compiler | XC8 v1.42
Middleware | MPLAB X IDE v3.65
Other development tool / version changed? | /

Issue / Task | Implementation / Comment | Status (development / release)
First spray position | When pressed tfrom released to spray position, make short beep | Development phase
Power on beep | When laser device/receiver powered on, make 1s beep

SW version | Development version: TX: 0.3 RX: 0.2
Previous official version | Development version 0.2
Change request | Project status on 18. 03. 2019
Filename | OMNISWITCH_TX.HEX (99765) OMNISWITCH_RX.HEX (99766)
Build environment
Compiler | XC8 v1.42
Middleware | MPLAB X IDE v5.05
Other development tool / version changed? | /

Issue / Task | Implementation / Comment | Status (development / release)
Battery discharge when connected to Skypulse | Filter – only specific combination of reed relays can wake up footswitch from a deep sleep mode | Develop. phase – release for testing house

SW version | Official release: TX: 1.0.0 RX: 1.0.0
Previous official version | Development version: TX: 0.x RX: 0.x
Change request | Project status on 27. 08. 2019
Filename | OMNISWITCH_TX.HEX (99765) OMNISWITCH_RX.HEX (99766)
Build environment
Compiler | XC8 v1.42
Middleware | MPLAB X IDE v5.05
Other development tool / version changed? | /

Issue / Task | Implementation / Comment | Status (development / release)
WIFI connection lost on ch 12, 13, 14, 15 due to malfunction of zigbee module MRF24J40MA | Channels removed from table of allowed channels | Official release

SW version | TX: 1.0.1 RX: 1.0.1
Previous official version | TX: 1.0.0 RX: 1.0.0
Change request | I-9731
Filename | OMNISWITCH_TX.HEX (99765) OMNISWITCH_RX.HEX (99766)
Build environment
Compiler | XC8 v1.42
Middleware | MPLAB X IDE v5.05
Other development tool / version changed? | /

Issue / Task | Implementation / Comment | Status (development / release)
When connection is lost for more than 400ms, reconnection is established but footswitch goes to deep sleep mode. | Code changed, so footswitch goes to idle sleep mode and wakes up every 100 ms to send data. | Implemented and released with change I-9731.
When connection is lost due to jammed channel, receiver waits on jammed channel, so reconnection is impossible. | When connection is lost for more than 400 ms, receiver scans all the channels and sets the channel with least noise.

SW version | TX: 1.0.1 RX: 1.0.2
Previous official version | TX: 1.0.1 RX: 1.0.1
Change request | I-10730
Filename | OMNISWITCH_RX.HEX (99766)
Build environment
Compiler | XC8 v2.10
Middleware | MPLAB X IDE v5.45
Other development tool / version changed? | /

Issue / Task | Implementation / Comment | Status (development / release)
No voice signal when in Spray position after foot switch released | Short beep added, when in Spray position for the first time, after foot switch was released. | Implemented and released with change I-10730.

Unresolved anomalies, bugs and defects:

There are no known faults or defects detected.

# BOOTUTIL PKG, id. 103241

SW version | 1.0.0
Previous official version | /
Change request | All development phases
Filename | Package: bootutil_scripts.zip
Build environment
Compiler | arm-buildroot-linux-gnueabi-gcc 4.9.4
Middleware | buildroot-2017.02.7
Other development tool / version changed? | /

Issue / Task | Implementation / Comment | Status (development / release)
First version | 1. u-boot 2013.10 Downloaded from the SBC manufacturer's (SECO) web site with board specific patches. Compiled in Fotona. 2. Root file system Buildroot 2017.02.7 Downloaded from Buildroot web site, configured and compiled in Fotona 3. Linux kernel 3.0.35 Downloaded from the SBC manufacturer's (SECO) web site with board specific patches. Added Fotona specific patches: - display support - touch screen support - initial SkyPulse logo Patched kernel compiled in Fotona. 4. Qt library V5.9.2 Open source version downloaded in source form from Qt web site and compiled in Fotona.

SW version | Official release - 1.0.2
Previous official version | 1.0.0
Change request | /
Filename | Modified files: HF01-06-Batch_install.exec HF01-06-Batch_install.exec.sign HF04-Install_OS.sqfs HF04-Install_OS.sqfs.sign New files: imx_usb/imx_usb imx_usb/imx_usb.conf imx_usb/mx6_usb_work.conf imx_usb/u-boot_no-env.imx make-bootable Package: bootutil_scripts.zip
Build environment
Compiler | arm-buildroot-linux-gnueabi-gcc 4.9.4
Middleware | buildroot-2017.02.7
Other development tool / version changed? | /

Issue / Task | Implementation / Comment | Status (development / release)
Slow application start-up. | Modified touch screen initialization. | Official release
Difficult bootable USB memory stick generation. | Created shell script for automatic bootable USB memory stick generation.
Missing files for initial SBC system installation. | Added files in folder imx_usb. The files are used for the initial SBC system installation with USB cable and jumper.

*Za vsak SW modul je potrebno dodati novo poglavje, ki obsega tabeli (generira se z gumbom v orodni vrstici Vstavi tabelo), komentar „Unresolved anomalies, bugs and defects“ ter podpis avtorja.

Date: | 25. 08. 2022
| | Signature
Author: | K. Povšič
Author: | T. Gašparič
Author: | J. Pirc
Author: | M. Močnik
Author: | M. Treven
Author: | I. Rojnič Geržina
Reviewed by: | V. S. Kenk
Approved by: | J. Žabkar

SW Revision level history Project PR-SkyPulse Version: 31 Page / Pages 85/85
