yallawalla/SkyPulseIOC/schematic/WIRING_DIAGRAM_PR_SKYPULSE.pdf

C

B

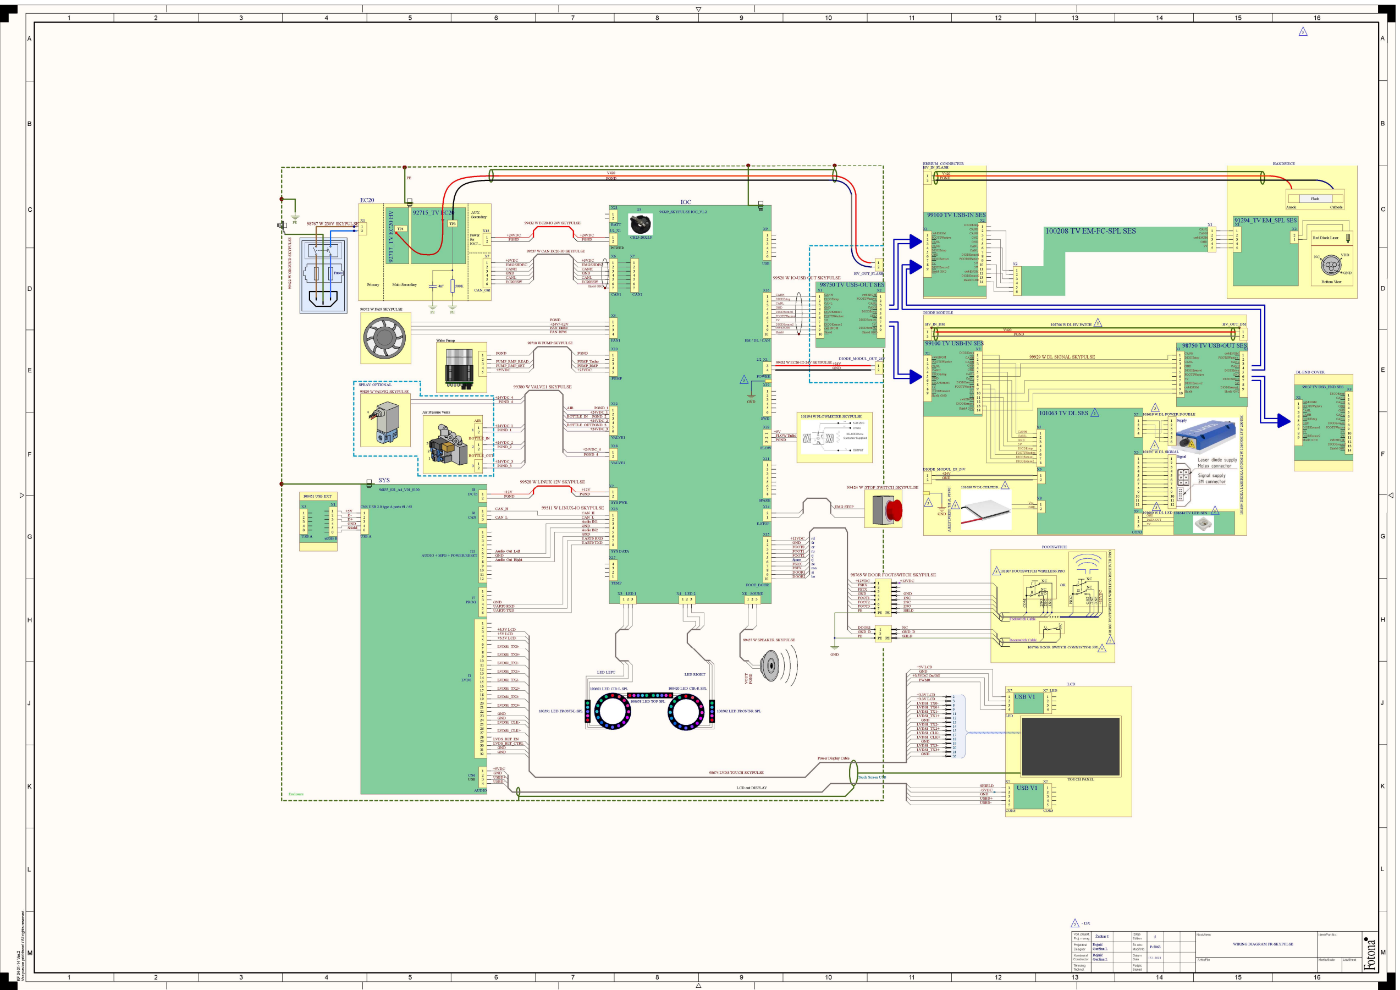
[picture p3: page 1]

Arhiv/File

Projektiral
Designer

Constructor

Konstruiral

Tehnolog
Technol.

Izdaja
Edition

Št. obv.:
Modif.No.

Datum
Date

Podpis
Signed

Ident/Part No.:

Merilo/Scale | List/Sheet
Naziv/Item | FotonaOProj. manag.

Vod. projekt.

G

F

E

A

D KF 04⁻01⁻14 Ver.2 Vse pravice pridržane! / All rights reserved.

1 | 2 | 3 | 14 4 | 5 | 6 | 7 | 8 | 9 | 15 | 16 10 | 11 | 12 | 13
1 | 2 | 3 | 14 4 | 5 | 6 | 7 | 8 | 9 | 15 | 16 10 | 11 | 12 | 13

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
99137 TV USB_END SES

## USB V1

File Name

## 98750 TV USB-OUT SES

EC20 | 92717_TV EC²⁰ HV | 92715_TV EC20

## 101063 TV DL SES

## 91294_TV EM_SPL SES

## 98750 TV USB-OUT SES

## 99100 TV USB-IN SES

## IOC

## SYS

+24VDC

LCD

EC20FSW

CANH

CANL

+5VDC

PGND

+12V

EC20FSW

CANH

CANL

GND

EMGSHDEC

CAN_H

CAN_L

CAN_H
CAN_L

PGND

+12V

99432 W EC20-IO 24V SKYPULSE

99537 W CAN EC20-IO SKYPULSE

CNC

101796 DOOR SWITCH CONNECTOR SPL

PE
Doorswitch Cable

Footswitch Cable

FOOT1

FOOT3

DOOR1
GND_D

FOOT2

PE PE

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
PE PE | COM | 2NO

NC
NO2NC 1NC

NC
I

II

101807 FOOTSWITCH WIRELESS PRO

OR

SHLD

NC

GND

SHLD

GND

+12VDC | +12VDC | 101808 FOOTSWITCH WIRELESS RECEIVER PRO COM

I

II 2NO ²NC ²NC+¹²VDC

NC

NC

1
2

FSRX
FSTX

98674 LVDS TOUCH SKYPULSE

Power Display Cable

EMGSHDEC

+5VDC
GND
USBD+
USBD-

+5VDC

+24VDC

+25VDC

PGND

PUMP_RMP_READ
PUMP_RMP_SET
+25VDC

PGND

PUMP_Tacho
PUMP_RMP

Water Pump

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
+5VDC
GND
USBD+
USBD-
Touch Screen USB USB | TOUCH PANEL ⁹⁹⁴²² W GROUND SKYPULSE

PE

TP3

PGND

V420

POWER

LCD out DISPLAY

98710 W PUMP SKYPULSE

1NC
2NC
2NO

99829 W VALVE2 SKYPULSE

+24VDC_1

PGND_1

Red Diode Laser

Bottom View

VDD

GND

NC

FOOTSWITCH

TP4

PE

4n7 | 500K Primary | Main Secondary

AUX
Secondary

Power
for
IOC/...

PGND

GND

PE | PE

PGND

+24VDC_2

+24VDC_3

+24VDC_4

PGND_2

PGND_3

PGND_4

Fuses

96572 W FAN SKYPULSE

Air Pressure Vents

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
SPARE

+24VDC_1
PGND_1

+24VDC_2
PGND_2

+24VDC_3
PGND_3

+24VDC_4
PGND_4

PGND
+24V/+12V

1
2
3
4
5
6

X7

CAN_Out

1
2

X12

1
2

J8
DC in | 1
| 2

X2

SYS PWR

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
SYS DATA

1
2
3
4

CN6

AUDIO

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
Anode | Cathode

Flash

+24V
GND

+24V

Enclosure

PGND

V420

1
2
3
4

X5

FAN1

FAN Tacho
FAN RPM

GND

EMG STOP

Audio IN1
GND

GND

Audio IN2

UART0 RXD
UART0 TXD | 1
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
| 10

X15

FOOT_DOOR

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
EM / DL / CAN

+12VDC
GND
FOOT0
FOOT1
FOOT2

FSRX
FSTX
DOOR1
DOOR2

GND_D

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
LVDS

## 99100 TV USB-IN SES

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
+3.3V LCD
+5V LCD

LVDS1_TX0-

+3.3V LCD

LVDS1_TX0+

LVDS1_TX1-

LVDS1_TX1+

LVDS1_TX2-

LVDS1_TX2+

LVDS1_CLK-

LVDS1_CLK+

LVDS1_TX3-

LVDS1_TX3+

GND
GND

LVDS_BLT_EN
LVDS_BLT_CTRL

GND

GND

+3.3V LCD
+3.3V LCD
LVDS1_TX0-
LVDS1_TX0+
LVDS1_TX1-
LVDS1_TX1+
GND
LVDS1_TX2-
LVDS1_TX2+
LVDS1_CLK-LVDS1_CLK+
GND
LVDS1_TX3-
LVDS1_TX3+
GND

## 1 USB V1

2
3
4

X7

LED

Spare

PWM0

GND
+3.3VDC On/Off

+5V LCD

1
2
3
4
5

X10

PUMP

1
2
3
4
5

99457 W SPEAKER SKYPULSE VOUT PGND

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
PROG

Audio_Out_Left

Audio_Out_Right

GND

UART0 RXD
UART0 TXD

1
2
3
4

X7 LED

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
AUDIO + MFG + POWER/RESET

## 1 USB V1

2
3
4
5

X?

CON5

1
2
3
4
5

X?

CON5

SHIELD

1 2 3

X4 LED 2

LED LEFT

1 2 3

X3 LED 1

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
X1 | 1
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
| 10
| 11
| 12
| 13
| 14

X2

GND

CANH

CANL

5V

Shield GND

3
4

2/2_X1

POWER

1
2

1/2_X1

CANH

CANH

CANL

CANL

GND
GND

5V
Shield GND | 5V

GND

CANH

CANL

5V

Shield GND

DIODEstop

GND
DIODEsense1
FOOTSWactive

CANH

CANL

5V

Shield

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
CANH
CANL
GND
5V

CANL

GND

5V

Shield GND

CANH

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
CANL

GND

5V

CANH

CANL

GND
5V

1

2

X2

WIRING DIAGRAM PR-SKYPULSE

Žabkar J.

Rojnić

15.1.2020

5

P-5063

1
2

X6

GND

1
2

HV_OUT_DM

1
2

HV_IN_DM

1
2
HV_OUT_FLASH

1
2

HV_IN_FLASH

1
2

DIODE_MODUL_IN_24V

1
2

DIODE_MODUL_OUT_24V

PGND

V420

94329_SKYPULSE IOC_V1.2

ERBIUM_CONNECTOR | HANDPIECE

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
CAN1

Shield GND

1 2 3

X8 SOUND

1

2

X14

E.STOP

1
2
3
4
5
6

X12

VALVE1

1
2

X18

VALVE2

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
CAN2

1

2

3

4

X17

TEMP

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
BATT

CH25-2032LF

G3

DIODEsense2

DIODEstop

GND
DIODEsense1
FOOTSWactive

CANH

CANL

5V

Shield

cwbENGM

DIODEsense2

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
CANH

CANL

DIODEstop

GND

DIODEsense1
FOOTSWactive

5V

DIODEsense2

DIODEsense2

cwbENGM

Shield GND

cwbENGM

GND

CANH

CANL

5V

Shield GND

DIODEstop

GND
DIODEsense1
FOOTSWactive

CANH

CANL

5V

Shield

cwbENGM

DIODEsense2

DIODEstop

DIODEsense1

FOOTSWactive

DIODEsense2

DIODEstop | cwbENGM

DIODEstop

DIODEstop

DIODEsense1 DIODEsense1

DIODEsense2

DIODEsense2

cwbENGM

DIODEsense1
DIODEsense2

FOOTSWactive

FOOTSWactive

FOOTSWactive

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
X1 | 1
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
| 10
| 11
| 12
| 13
| 14

X2

GND

CANH

5V

Shield GND

CANH

CANH

CANL
CANL

GND
GND

5V
5V
Shield GND

DIODEstop

DIODEstop

DIODEsense1

DIODEsense1

DIODEsense2

DIODEsense2

cwbENGM

cwbENGM

FOOTSWactive

FOOTSWactive

96855_021_A4_V01_0100

DL END COVER

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
CON3

Geržina I.

101628 W DL PELTIER | 101604 DIODA LASERSKA ⁶⁷⁰NM ²W ¹⁰⁶⁴NM ¹⁵W ²⁰⁰UM

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
101644 TV LED SES

1
2
3
4
5
6

Supply

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
Signal

cwbENGM

DIODEstop

DIODEsense1

FOOTSWactive

cwbENGM

cwbENGM
FOOTSWactive

DIODEstop

DIODEsense1

DIODEsense2

CANH

cwbENGM

1
2
3
4
5

X1

AIR

BOTTLE_IN

BOTTLE_OUT

AIR

BOTTLE_IN

BOTTLE_OUT

1
2
3
4

X7

GND

5V

DATA OUT

GND

Vcc

Rojnić
Geržina I.

100502 LED FRONT-R SPL

100658 LED TOP SPL

100601 LED CIR-L SPL

100591 LED FRONT-L SPL

100420 LED CIR-R SPL

LED RIGHT

PGND

+5V
FLOW Tacho

101194 W FLOWMETER SKYPULSE

DIODE MODULE

1
2
3
4
0

CN6 USB 2.0 type A ports #1 / #2

USB A

+5V

Shield

D-D+
GND

100451 USB EXT

1
2
3
4
5
0

X1

uUSB B

1
2
3
4
0

X2

USB A

1
2

X1

CANL

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
# 100208 TV EM-FC-SPL SES

### 99380 W VALVE1 SKYPULSE

### 99528 W LINUX 12V SKYPULSE

### 99511 W LINUX-IO SKYPULSE

### 98765 W DOOR FOOTSWITCH SKYPULSE

### 99424 W STOP SWITCH SKYPULSE

### 99929 W DL SIGNAL SKYPULSE

### 98767 W 230V SKYPULSE

### 99520 W IO-USB OUT SKYPULSE

99432 W EC20-IO 24V SKYPULSE 1 2 3

X22

FLOW

SPRAY: OPTIONAL

101660 W DL LED

101597 W DL SIGNAL

101618 W DL POWER DOUBLE

102766 W DL HV PATCH

# GND ¹⁰¹⁶²⁶ W DL OZEMLJITEV

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
5 - 13X
