yallawalla/SkyPulseIOC/schematic/94330_002_A3_V02______1.pdf

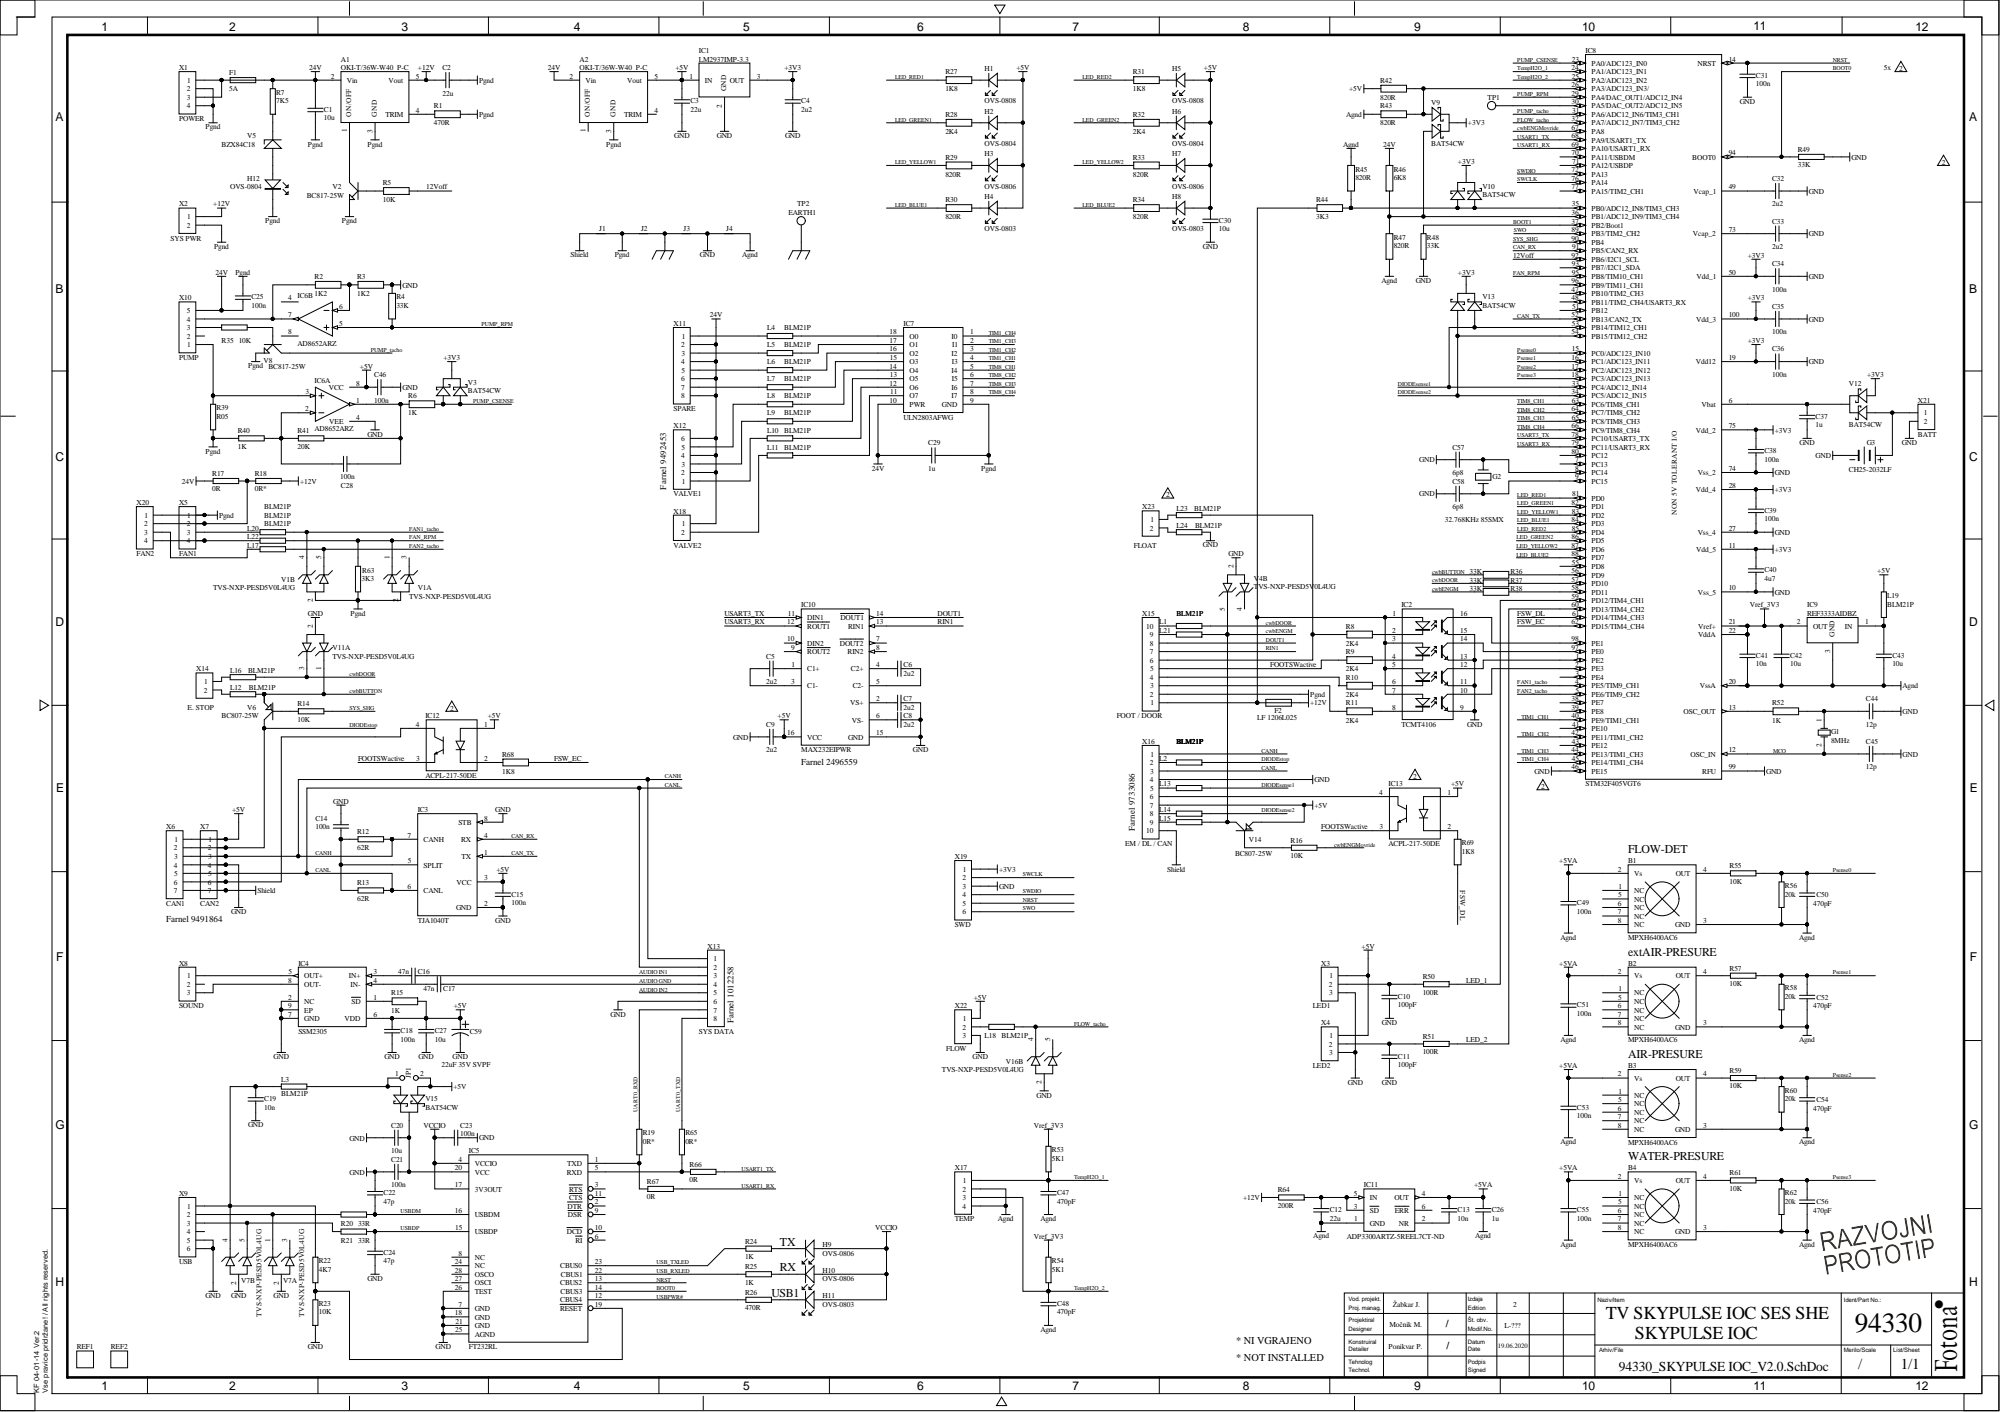
[picture p4: page 1]

FAN2_tacho

FOOTSWactive | 5 | 12 | PE3 2

9 LED_1 | TIM1_CH2 TIM1_CH3 TIM1_CH4 2 | | PE7 38

2 | 62R
3 | CANL | | SPLIT 5 | +5V

CANH

Vse pravice pridržane! / All rights reserved.

Vod. projekt. Proj. manag. | Žabkar J. | | Izdaja Edition | 2 | Naziv/Item TV SKYPULSE IOC SES SHE SKYPULSE IOC | Ident/Part No.: 94330 | O

Projektiral Designer | Močnik M. | / | Št. obv. Modif.No. | L-???

Konstruiral Detailer | Ponikvar P. | / | Datum Date | 19.06.2020

Arhiv/File 94330_SKYPULSE IOC_V2.0.SchDoc | Merilo/Scale / | List/Sheet 1/1

Tehnolog Technol. | | | Podpis Signed
