yallawalla/SkyPulseIOC/schematic/94330_002_A2_V01_0100.pdf

8 | 9 | 10 | 11 | 12

B

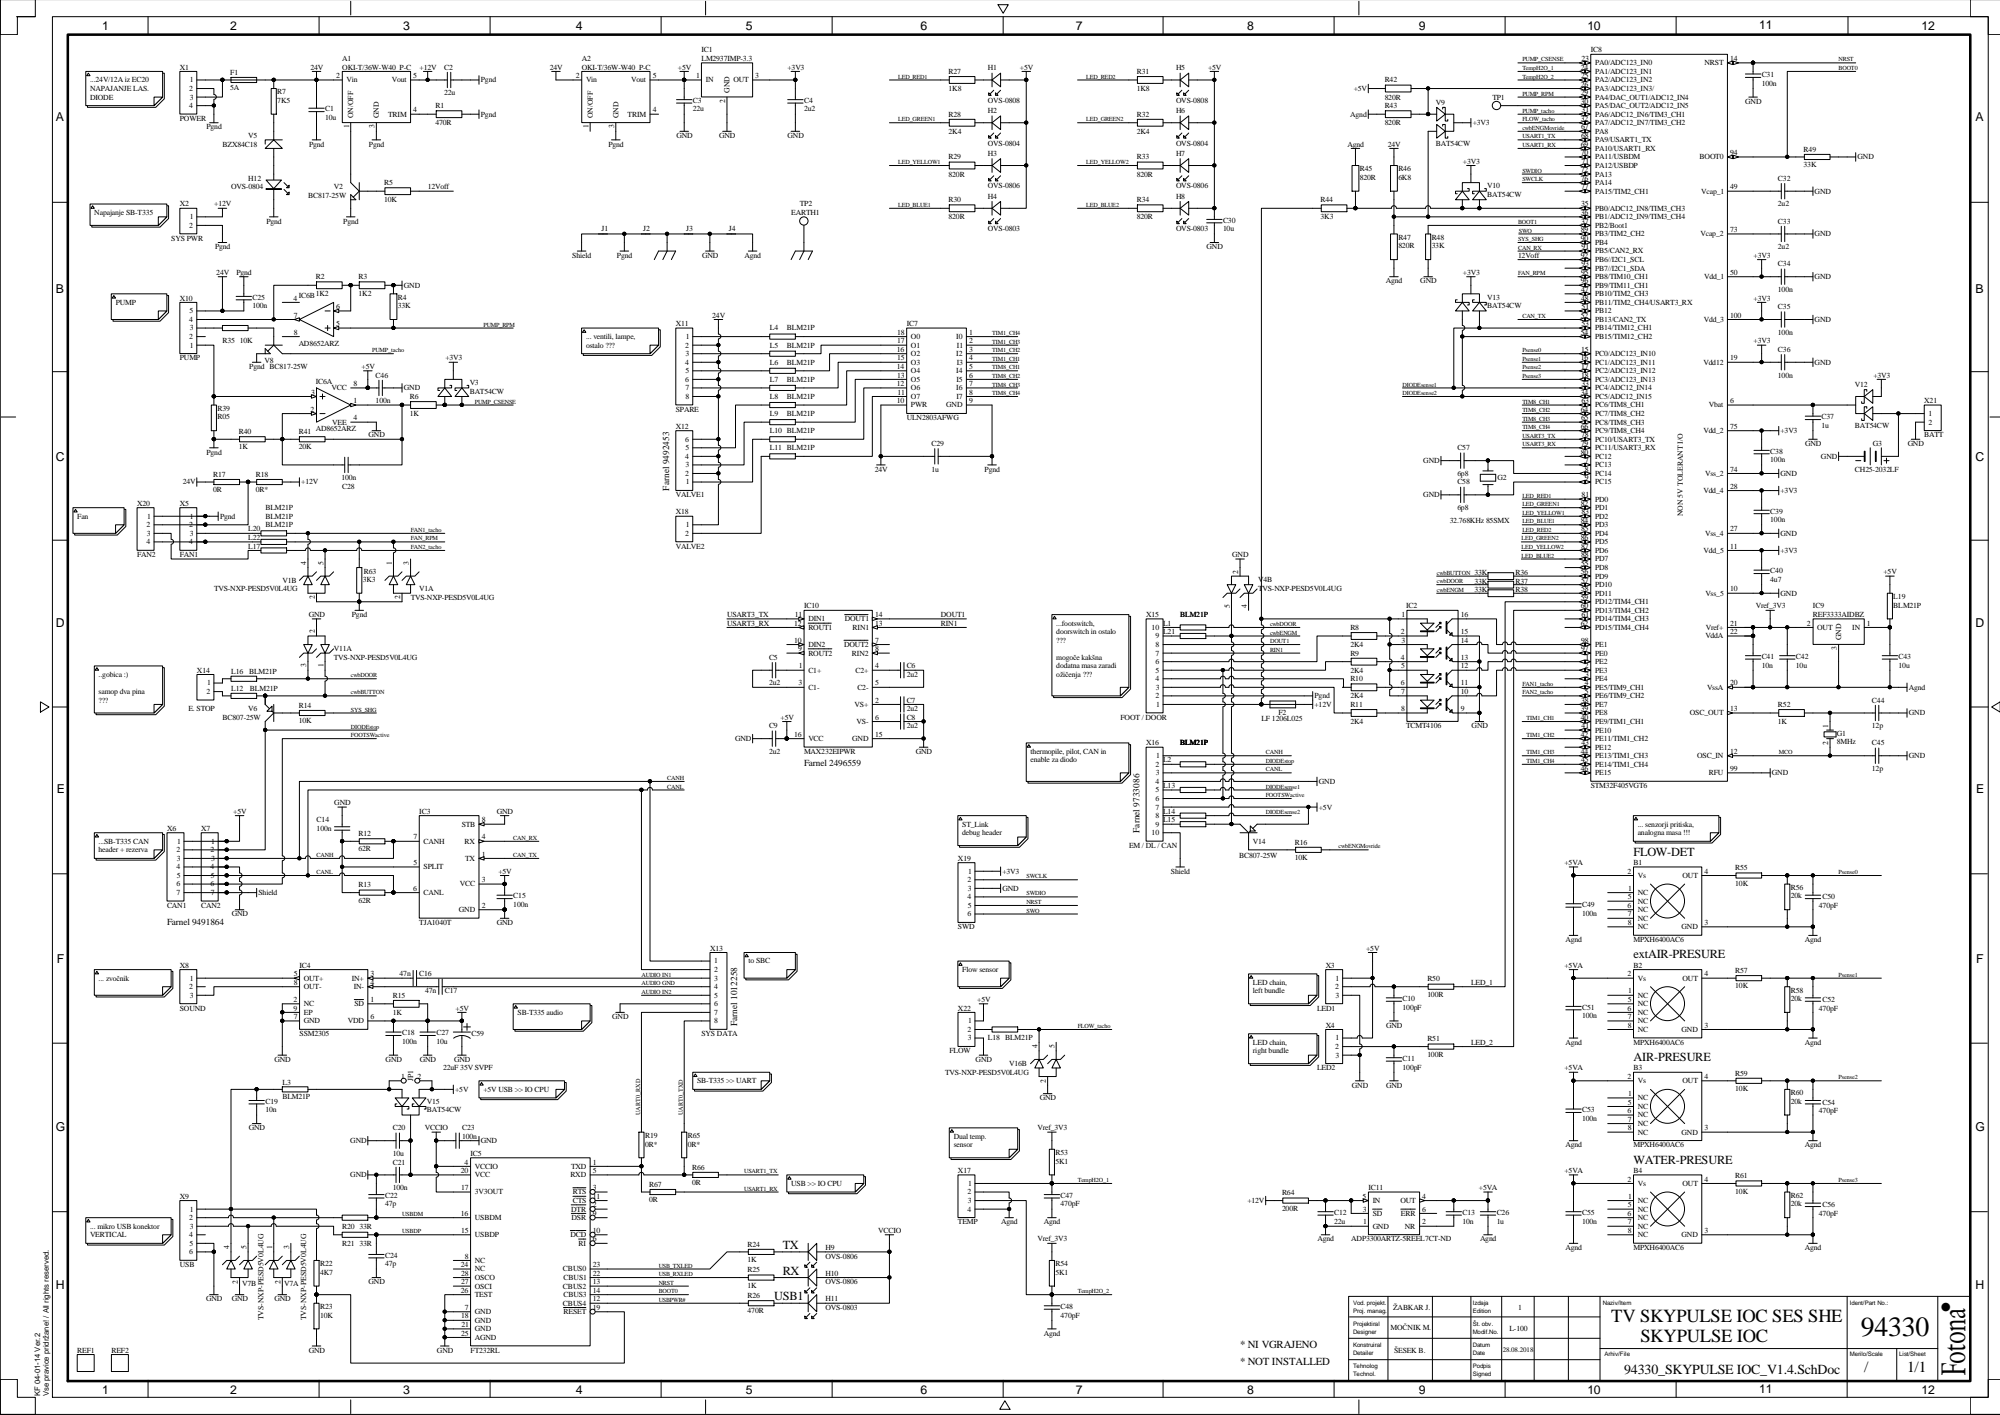
[picture p5: page 1]

thermopile, pilot, CAN in
enable za diodo

Vse pravice pridržane! / All rights reserved.

FotonaOProj. manag. Vod. projekt.

Naziv/Item
TV SKYPULSE IOC SES SHE
SKYPULSE IOC
