yallawalla/SkyPulseIOC/(list of files, drawings)

Other design files:
schematic/V1.2/94330_SKYPULSE IOC_V1.2.SchDoc
schematic/V1.3/94330_SKYPULSE IOC_V1.3.SchDoc
