yallawalla/SkyPulseIOC/CubeMx/Src/main.c

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
/* Includes ------------------------------------------------------------------*/
#include "main.h"
#include "cmsis_os.h"
#include "fatfs.h"
#include "usb_device.h"

/* USER CODE BEGIN Includes */
#include "misc.h"
/* USER CODE END Includes */

ADC_HandleTypeDef hadc1;
ADC_HandleTypeDef hadc2;
DMA_HandleTypeDef hdma_adc1;
DMA_HandleTypeDef hdma_adc2;

CAN_HandleTypeDef hcan2;

CRC_HandleTypeDef hcrc;

DAC_HandleTypeDef hdac;
DMA_HandleTypeDef hdma_dac1;

IWDG_HandleTypeDef hiwdg;

RTC_HandleTypeDef hrtc;

TIM_HandleTypeDef htim3;
TIM_HandleTypeDef htim4;
TIM_HandleTypeDef htim8;
TIM_HandleTypeDef htim9;
TIM_HandleTypeDef htim10;
TIM_HandleTypeDef htim12;
DMA_HandleTypeDef hdma_tim4_up;
DMA_HandleTypeDef hdma_tim8_up;

UART_HandleTypeDef huart1;
UART_HandleTypeDef huart3;
DMA_HandleTypeDef hdma_usart1_rx;
DMA_HandleTypeDef hdma_usart1_tx;
DMA_HandleTypeDef hdma_usart3_rx;
DMA_HandleTypeDef hdma_usart3_tx;

osThreadId defaultTaskHandle;
/* USER CODE BEGIN PV */
/* USER CODE END PV */

void SystemClock_Config(void);
static void MX_GPIO_Init(void);
static void MX_DMA_Init(void);
static void MX_ADC1_Init(void);
static void MX_DAC_Init(void);
static void MX_USART1_UART_Init(void);
static void MX_USART3_UART_Init(void);
static void MX_CAN2_Init(void);
static void MX_TIM10_Init(void);
static void MX_TIM9_Init(void);
static void MX_TIM3_Init(void);
static void MX_TIM8_Init(void);
static void MX_TIM4_Init(void);
static void MX_RTC_Init(void);
static void MX_ADC2_Init(void);
static void MX_IWDG_Init(void);
static void MX_CRC_Init(void);
static void MX_TIM12_Init(void);
void StartDefaultTask(void const * argument);

/* USER CODE BEGIN PFP */
void makeIoc(void);																										// main app. C++ relay object
/* USER CODE END PFP */

/* USER CODE BEGIN 0 */
uint32_t	pumpTacho, fanTacho, flowTacho, valve_timeout[__VALVES];	// DMA memory registers..
uint16_t	pump_drive, fan_drive, valve_drive[__VALVES], led_drive[__LEDS*24+2];
_io				*canBuffer=NULL;
hwVersion	hw;
/* USER CODE END 0 */

/**
  * @brief  The application entry point.
  * @retval int
  */
int main(void)
{
  /* MCU Configuration--------------------------------------------------------*/

  /* Reset of all peripherals, Initializes the Flash interface and the Systick. */
  HAL_Init();

  /* Configure the system clock */
  SystemClock_Config();

  /* Initialize all configured peripherals */
  MX_GPIO_Init();
  MX_DMA_Init();
  MX_FATFS_Init();
  MX_ADC1_Init();
  MX_DAC_Init();
  MX_USART1_UART_Init();
  MX_USART3_UART_Init();
  MX_CAN2_Init();
  MX_TIM10_Init();
  MX_TIM9_Init();
  MX_TIM3_Init();
  MX_TIM8_Init();
  MX_TIM4_Init();
  MX_RTC_Init();
  MX_ADC2_Init();
  MX_IWDG_Init();
  MX_CRC_Init();
  MX_TIM12_Init();
  /* USER CODE BEGIN 2 */
	
	hw=(hwVersion)((~(HAL_GPIO_ReadPin(PE15_GPIO_Port, PE15_Pin) +
			2*(HAL_GPIO_ReadPin(PE12_GPIO_Port, PE12_Pin) +
				2*(HAL_GPIO_ReadPin(PE10_GPIO_Port, PE10_Pin) +
					2*(HAL_GPIO_ReadPin(PE8_GPIO_Port, PE8_Pin) +
						2*HAL_GPIO_ReadPin(PE7_GPIO_Port, PE7_Pin))))) + 1) & 0x1f);

	HAL_TIM_IC_Start_IT(&htim3,TIM_CHANNEL_1);
	HAL_TIM_IC_Start_IT(&htim3,TIM_CHANNEL_2);
	HAL_TIM_IC_Start_IT(&htim9,TIM_CHANNEL_1);
	HAL_TIM_IC_Start_IT(&htim9,TIM_CHANNEL_2);
	HAL_TIM_PWM_Start(&htim10,TIM_CHANNEL_1);
	
	HAL_TIM_PWM_Start(&htim8,TIM_CHANNEL_1);
	HAL_TIM_PWM_Start(&htim8,TIM_CHANNEL_2);
	HAL_TIM_PWM_Start(&htim8,TIM_CHANNEL_3);
	HAL_TIM_PWM_Start(&htim8,TIM_CHANNEL_4);

	HAL_TIM_DMABurst_WriteStart(&htim8,TIM_DMABASE_CCR1,TIM_DMA_UPDATE,(uint32_t *)valve_drive,TIM_DMABURSTLENGTH_4TRANSFERS);
	HAL_DAC_Start_DMA(&hdac,DAC_CHANNEL_1,(uint32_t *)&pump_drive,1,DAC_ALIGN_12B_R);
	HAL_DAC_Start(&hdac,DAC_CHANNEL_2);

	HAL_TIM_PWM_Start(&htim4,TIM_CHANNEL_1);
	HAL_TIM_PWM_Start(&htim4,TIM_CHANNEL_2);
	HAL_TIM_DMABurst_WriteStart(&htim4,TIM_DMABASE_CCR1,TIM_DMA_UPDATE,(uint32_t *)led_drive,TIM_DMABURSTLENGTH_2TRANSFERS);
  /* USER CODE END 2 */

  /* USER CODE BEGIN RTOS_MUTEX */
  /* add mutexes, ... */
  /* USER CODE END RTOS_MUTEX */

  /* USER CODE BEGIN RTOS_SEMAPHORES */
  /* add semaphores, ... */
  /* USER CODE END RTOS_SEMAPHORES */

  /* USER CODE BEGIN RTOS_TIMERS */
  /* start timers, add new ones, ... */
  /* USER CODE END RTOS_TIMERS */

  /* USER CODE BEGIN RTOS_QUEUES */
  /* add queues, ... */
  /* USER CODE END RTOS_QUEUES */

  /* Create the thread(s) */
  /* definition and creation of defaultTask */
  osThreadDef(defaultTask, StartDefaultTask, osPriorityNormal, 0, 512);
  defaultTaskHandle = osThreadCreate(osThread(defaultTask), NULL);

  /* USER CODE BEGIN RTOS_THREADS */
  /* add threads, ... */
  /* USER CODE END RTOS_THREADS */

  /* Start scheduler */
  osKernelStart();

  /* We should never get here as control is now taken by the scheduler */
  /* Infinite loop */
  /* USER CODE BEGIN WHILE */
  while (1)
  {
    /* USER CODE END WHILE */

    /* USER CODE BEGIN 3 */
  }
  /* USER CODE END 3 */
}

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
/* USER CODE BEGIN 4 */
SemaphoreHandle_t sWait;
TaskHandle_t 			*pWait;
//___________________________________________________________________________
void	_wait(int t) {
			_io *temp=_stdio(NULL);
			if(*pWait==NULL)
				xTaskCreate((TaskFunction_t)_task, "---", 512, NULL, 0, pWait);
			++pWait;
			xSemaphoreGive(sWait);
			taskYIELD();
			vTaskDelay(t);
			xSemaphoreTake(sWait,portMAX_DELAY);
			--pWait;
			_stdio(temp);
}
//___________________________________________________________________________
void	_task(const void *t) {
			while(1) {
				if(xSemaphoreTake(sWait,portMAX_DELAY)) {
					Watchdog();
					_proc_loop();
					xSemaphoreGive(sWait);
				}
				taskYIELD();
			}
}
//___________________________________________________________________________
/* USER CODE END 4 */

/* USER CODE BEGIN Header_StartDefaultTask */
/**
  * @brief  Function implementing the defaultTask thread.
  * @param  argument: Not used 
  * @retval None
  */
/* USER CODE END Header_StartDefaultTask */
void StartDefaultTask(void const * argument)
{
  /* init code for USB_DEVICE */
  MX_USB_DEVICE_Init();
  /* USER CODE BEGIN 5 */
  /* Infinite loop */
	makeIoc();
	sWait=xSemaphoreCreateMutex();
	pWait=calloc(16,sizeof(TaskHandle_t));
	xTaskCreate((TaskFunction_t)_task, "---", 512, NULL, 0, pWait++);
  for(;;)
  {
    osDelay(1);
  }
  /* USER CODE END 5 */
}

/**
  * @brief  Period elapsed callback in non blocking mode
  * @note   This function is called  when TIM2 interrupt took place, inside
  * HAL_TIM_IRQHandler(). It makes a direct call to HAL_IncTick() to increment
  * a global variable "uwTick" used as application time base.
  * @param  htim : TIM handle
  * @retval None
  */
void HAL_TIM_PeriodElapsedCallback(TIM_HandleTypeDef *htim)
{
  /* USER CODE BEGIN Callback 0 */
  if (htim->Instance == TIM2) {
    pollLed();
  }
  /* USER CODE END Callback 0 */
  if (htim->Instance == TIM2) {
    HAL_IncTick();
  }
  /* USER CODE BEGIN Callback 1 */
  if (htim->Instance == TIM2) {
		TIM10->CCR1=fan_drive;
		for(int i=0; i<__VALVES; ++i)
			if(valve_timeout[i] && HAL_GetTick() > valve_timeout[i]) {
				valve_timeout[i]=0;
				if(valve_drive[i])
					valve_drive[i]=0;
				else
					valve_drive[i]=__PWMRATE;
			}
	}
  /* USER CODE END Callback 1 */
}

/**
  * @brief  This function is executed in case of error occurrence.
  * @retval None
  */
void Error_Handler(void)
{
  /* USER CODE BEGIN Error_Handler_Debug */
  /* User can add his own implementation to report the HAL error return state */
  while(1) 
  {
  }
  /* USER CODE END Error_Handler_Debug */
}

#ifdef  USE_FULL_ASSERT
/**
  * @brief  Reports the name of the source file and the source line number
  *         where the assert_param error has occurred.
  * @param  file: pointer to the source file name
  * @param  line: assert_param error line source number
  * @retval None
  */
void assert_failed(uint8_t *file, uint32_t line)
{
  /* USER CODE BEGIN 6 */
  /* User can add his own implementation to report the file name and line number,
    ex: printf("Wrong parameters value: file %s on line %d\r\n", file, line) */
  /* USER CODE END 6 */
}
#endif /* USE_FULL_ASSERT */

/************************ (C) COPYRIGHT STMicroelectronics *****END OF FILE****/
