yallawalla/SkyPulseIOC/CubeMx/SkyPulse.ioc

Mcu.UserName=STM32F405VGTx
PA0-WKUP.GPIO_Label=PUMP_CSENSE
PA0-WKUP.Signal=ADCx_IN0
PA1.GPIO_Label=T1_H2O
PA1.Signal=ADCx_IN1
PA10.Signal=USART1_RX
PA11.Signal=USB_OTG_FS_DM
PA12.Signal=USB_OTG_FS_DP
PA13.Signal=SYS_JTMS-SWDIO
PA14.Signal=SYS_JTCK-SWCLK
PA2.GPIO_Label=T1_H2O
PA2.Signal=ADCx_IN2
PA3.GPIO_Label=_5V
PA3.Signal=ADCx_IN3
PA4.Signal=COMP_DAC1_group
PA5.Signal=COMP_DAC2_group
PA6.GPIO_Label=PUMP_TACHO
PA6.Signal=S_TIM3_CH1
PA7.GPIO_Label=FLOW_TACHO
PA7.Signal=S_TIM3_CH2
PA8.GPIO_Label=cwbOVRD
PA8.Signal=GPIO_Output
PA9.Signal=USART1_TX
PB0.GPIO_Label=_12V
PB0.Signal=ADCx_IN8
PB1.GPIO_Label=_24V
PB1.Signal=ADCx_IN9
PB13.Signal=CAN2_TX
PB14.GPIO_Label=DSenseTIM1
PB14.Signal=S_TIM12_CH1
PB15.GPIO_Label=DSenseTIM1
PB15.Signal=S_TIM12_CH2
PB3.GPIO_Label=_12Voff
PB3.Signal=GPIO_Output
PB4.GPIO_Label=_SYS_SHG
PB4.Signal=GPIO_Output
PB5.Signal=CAN2_RX
PB8.GPIO_Label=FAN_PWM
PB8.Signal=S_TIM10_CH1
PC0.GPIO_Label=Psense0
PC0.Signal=ADCx_IN10
PC1.GPIO_Label=Psense1
PC1.Signal=ADCx_IN11
PC10.Signal=USART3_TX
PC11.Signal=USART3_RX
PC14-OSC32_IN.Signal=RCC_OSC32_IN
PC15-OSC32_OUT.Signal=RCC_OSC32_OUT
PC2.GPIO_Label=Psense2
PC2.Signal=ADCx_IN12
PC3.GPIO_Label=Psense3
PC3.Signal=ADCx_IN13
PC4.GPIO_Label=DLsense1
PC4.Signal=ADCx_IN14
PC5.GPIO_Label=DLsense2
PC5.Signal=ADCx_IN15
PC6.GPIO_Label=_BOTTLE_OUT
PC6.Signal=S_TIM8_CH1
PC7.GPIO_Label=_BOTTLE_IN
PC7.Signal=S_TIM8_CH2
PC8.GPIO_Label=_AIR
PC8.Signal=S_TIM8_CH3
PC9.GPIO_Label=_WATER
PC9.Signal=S_TIM8_CH4
PD0.GPIO_Label=_RED1
PD0.Signal=GPIO_Output
PD1.GPIO_Label=_GREEN1
PD1.Signal=GPIO_Output
PD10.GPIO_Label=cwbDOOR
PD10.Signal=GPIO_Input
PD11.GPIO_Label=cwbENGM
PD11.Signal=GPIO_Input
PD12.GPIO_Label=_LED1
PD12.Signal=S_TIM4_CH1
PD13.GPIO_Label=_LED2
PD13.Signal=S_TIM4_CH2
PD14.GPIO_Label=FSW_DL
PD14.Signal=GPIO_Output
PD15.GPIO_Label=FSW_EC
PD15.Signal=GPIO_Output
PD2.GPIO_Label=_YELLOW1
PD2.Signal=GPIO_Output
PD3.GPIO_Label=_BLUE1
PD3.Signal=GPIO_Output
PD4.GPIO_Label=_RED2
PD4.Signal=GPIO_Output
PD5.GPIO_Label=_GREEN2
PD5.Signal=GPIO_Output
PD6.GPIO_Label=_YELLOW2
PD6.Signal=GPIO_Output
PD7.GPIO_Label=_BLUE2
PD7.Signal=GPIO_Output
PD9.GPIO_Label=cwbBUTTON
PD9.Signal=GPIO_Input
PE0.GPIO_Label=FSW0
PE0.Signal=GPIO_Input
PE1.GPIO_Label=FSW1
PE1.Signal=GPIO_Input
PE10.GPIO_Label=PE10
PE10.Signal=GPIO_Input
PE12.GPIO_Label=PE12
PE12.Signal=GPIO_Input
PE15.GPIO_Label=PE15
PE15.Signal=GPIO_Input
PE2.GPIO_Label=FSW2
PE2.Signal=GPIO_Input
PE3.GPIO_Label=FSW3
PE3.Signal=GPIO_Input
PE4.GPIO_Label=PE4
PE4.Signal=GPIO_Input
PE5.Signal=S_TIM9_CH1
PE6.Signal=S_TIM9_CH2
PE7.GPIO_Label=PE7
PE7.Signal=GPIO_Input
PE8.GPIO_Label=PE8
PE8.Signal=GPIO_Input
PH0-OSC_IN.Signal=RCC_OSC_IN
PH1-OSC_OUT.Signal=RCC_OSC_OUT
