yallawalla/SkyPulseIOC/Cpp/Inc/spray.h

#ifndef		SPRAY_H
#define		SPRAY_H

#include	"term.h"
#include	"adc.h"
#include	"err.h"
#include	"ff.h"
#include	"fit.h"
#include	<algorithm>
#include "simulator.h"

#define		_SPRAY_READY_T	1500
				
typedef	struct {
	bool	Air:1;
	bool	Water:1;
	bool	BlowJob:1;
	bool	Vibrate:1;
	bool	Setup:1;
}	mode;
//________________________________________________________________________________________________
class	_VALVE {
	private:
		int 	n;
		bool	inv;
	public:
		_VALVE(int k, bool i) {	
			n = k; 
			inv=i;
		};
		
		int	 Set();
		void Set(int);
		void Set(int, int);

		bool Opened(void)							{ return inv ? Set() : !Set();}
		bool Closed(void)							{ return !Opened();}
		void Open(void)								{ inv ? Set(__PWMRATE): Set(0);}
		void Close(void)							{ inv ? Set(0): Set(__PWMRATE);}
		void Open(int i)							{ inv ? Set(__PWMRATE,i): Set(0,i);}
		void Close(int i)							{ inv ? Set(0,i): Set(__PWMRATE,i);}
};

class	_SPRAY : public _TERM, public _ADC {
	private:
		int	inPressure;
		int	Bottle_ref, Bottle_P,bottle_event;
		int	Air_ref, Air_P;
		int	idx,simrate;
		void				*Adjust(void);
		_FIT				*pFit;
		_SIMULATOR	*sim;

	public:
		_SPRAY();
		void		LoadSettings(FIL *);
		void		SaveSettings(FIL *);
		void		Increment(int, int);
		virtual void	Newline(void);
		virtual int		Fkey(int);

		_VALVE	*BottleIn,*BottleOut,*Air,*Water;
		_err		Status();
		mode		mode;

		int			AirLevel, WaterLevel, WaterGain;
		int			readyTimeout, offsetTimeout;
		_LCD		*lcd;
};

#endif
