yallawalla/SkyPulseIOC/Cpp/Inc/ascii.h

#define	__Esc				0x1b
#define	__BACKSPACE 0x08
#define	__DELETE		0x7F
#define	__CR				0x0D
#define	__LF				0x0A

#define	__CtrlA			0x01
#define	__CtrlB			0x02
#define	__CtrlC			0x03
#define	__CtrlD			0x04
#define	__CtrlE			0x05
#define	__CtrlF			0x06

#define	__CtrlI			0x09
#define	__CtrlK			0x09
#define	__CtrlO			0x0f
#define	__CtrlP			0x10
#define	__CtrlQ			0x11
#define	__CtrlR			0x12
#define	__CtrlS			0x13
#define	__CtrlT			0x14
#define	__CtrlV			0x16
#define	__CtrlZ			0x1a
#define	__CtrlY			0x19

#define	__f1				0x001B4F50
#define	__f2				0x001B4F51
#define	__f3				0x001B4F52
#define	__f4				0x001B4F53
#define	__f5				0x001B4F54
#define	__f6				0x001B4F55
#define	__f7				0x001B4F56
#define	__f8				0x001B4F57
#define	__f9				0x001B4F58
#define	__f10				0x001B4F59
#define	__f11				0x001B4F5A
#define	__f12				0x001B4F5B

#define	__F1				0x5B31317E
#define	__F2 				0x5B31327E
#define	__F3				0x5B31337E
#define	__F4				0x5B31347E
#define	__F5				0x5B31357E
#define	__F6				0x5B31377E
#define	__F7				0x5B31387E
#define	__F8				0x5B31397E
#define	__F9				0x5B32307E
#define	__F10				0x5B32317E
#define	__F11				0x5B32337E
#define	__F12				0x5B32347E
#define	__Home			0x1B5B317E
#define	__End				0x1B5B347E
#define	__Insert		0x1B5B327E
#define	__PageUp		0x1B5B357E
#define	__Delete		0x1B5B337E
#define	__PageDown	0x1B5B367E
#define	__Up				0x001B5B41
#define	__Down			0x001B5B42
#define	__Left			0x001B5B44
#define	__Right			0x001B5B43
#define	__CtrlUp		0x001B4F41
#define	__CtrlDown	0x001B4F42
#define	__CtrlLeft	0x001B4F44
#define	__CtrlRight	0x001B4F43
