yallawalla/SkyPulseIOC/(commit log)

2017-09-24 - adc, pumpa, fan, time
2017-09-27 can, fan, pump ok rtc ne ohranja vrednosti !
2017-10-06 led ne dela...
2017-10-12 led, nepreizkušeno...
2017-10-17 lućke, rešen usart problem..
    [SkyPulse.ioc, cli.cpp, cli.h, footsw.cpp, ioc.cpp, ioc.h, main.c]
2017-11-27 - heap, stdarg-printf
2018-01-12 ... daily
    emg error handling OK
    [SkyPulse.ioc, adc.cpp, can.cpp, err.h, fan.cpp, ffconf.h]
2018-01-22 - error handling ok
    [can.cpp, err.h, ioc.cpp, ioc.h, main.c]
2018-05-04 - daily - pressure fit
2018-05-30 STM32Cube_FW_F4_V1.21.0 STM32CubeMX V4.25.0
2018-07-05 - schematics
    [94330_SKYPULSE IOC_V1.2.SchDoc, 94330_SKYPULSE IOC_V1.3.SchDoc]
2018-10-18 - daily
    [94330_SKYPULSE IOC_V1.3.SchDoc]
2018-11-15 - daily - razlika temp. senzorjev - overheat meja na 60 - ref. filter
    [adc.cpp, adc.h, can.cpp, can.h, ioc.h, main.c]
2018-11-16 - daily diode hi/low filter config - ne dela
2018-11-19 - V 0.23 Nov 19 2018 <ABF6667C> - +/= brez parametra spremeni vse flage - F11 shrani tudi error in warning mask
    [SkyPulse.ioc, cli.cpp, ioc.cpp, main.h, spray.cpp]
2018-11-19 V 0.23 Nov 19 2018 <AC8E841F>
    +-= brez argumenti pomeni vse flage v error in warn mask
    - F11 shrani tudi error in warn mask
    [cli.cpp, ioc.cpp]
2018-11-20 - overheat limit set to 55 deg. v 0.23 Nov 20 2018 <5EDAC1B1>
    [adc.cpp]
2018-11-22 - daily struktura z ločenim ref. filtrom 5Hz CAN: timing msg večji of 500ms se normira na 500ms CAN: CW se interpretira kot 95% duty cycle
2018-11-23 - daily - separate class _DL - ob izklopu fsw napaka... - definirati, kje postaviti reset filtra
    [adc.cpp, adc.h, can.cpp, dl.cpp, dl.h, ioc.cpp, ioc.h, ws2812.cpp]
2018-11-30 - daily - ref. filter dela - dodaten msg 0x601 in sist. stanje _CALIBRATE. Pri DL blokira napake, da ne motijo kalibracije - bug: ob spustu FSW in takojšnjem hitrem pritisku ujameš timeout in sprožiš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
    [SkyPulse.ioc, can.cpp, dl.cpp, dl.h, ioc.h, main.c, pump.cpp]
2018-12-06 /v 0.24 Dec 6 2018 <3CF656A1> - calibrate režim ta DL izklopi preverjanje omejitev in timinga - dodatek v 0x21f message: byte mode, oznacuje aktivni kanal, drug kanal se smatra za crosstalk in se pre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
    [can.cpp, cli.cpp, dl.cpp, dl.h, ioc.cpp, ioc.h, pump.cpp]
2018-12-07 V 0.24 Dec 7 2018 <163DF537>
    - bug pri sprejemu 0x601 (_CALIBRATE..., can.cpp)
    [can.cpp]
2018-12-07 V 0.24 Dec 7 2018 <DCF3073D> - bug pri izpisu temp. na pumpi - bug pri ?E
    [cli.cpp, pump.cpp]
2018-12-13 V 0.25 Dec 13 2018 <B274CAB1> - v konzoli se readyTimeout sproži samo ob spremembu in ne kont. na REFRESH - spray se ugasne v ERROR stanju (proc. SetState)
    [SkyPulse.ioc, ioc.cpp, main.h, spray.cpp]
2018-12-21 V 0.27 Dec 21 2018 <CFFB0DFD> - bug v poll error: can message je šel ven preden se je zamenjalo stanje
    [SkyPulse.ioc, ioc.cpp, main.h]
2019-01-21 V 0.28 Jan 21 2019 <547C4E38> - bug v nastavitvi za crowbar override, napacen enum CAN test <200 00 08 mora izklopiti error !!! - izklop pumpe ni delal, ce je ioc že v error state
    [SkyPulse.ioc, adc.cpp, adc.h, can.cpp, cli.cpp, cli.h, dl.cpp, err.h]
2019-01-31 V 0.29 Jan 30 2019 <6ED63AD6> - bug pri sinhronizaciji ref. signala pri dvokanalni diodi; sinhronizacija na trenutno aktivni kanal, dolocen v CAN 0x21F msg (limite) - v konzoli odstranjena možnost vk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
    [SkyPulse.ioc, cli.cpp, dl.cpp, dl.h, ffconf.h, main.c, main.h, term.h]
2019-01-31 V 0.29 Jan 30 2019 <6ED63AD6> - bug pri sinhronizaciji ref. signala pri dvokanalni diodi; sinhronizacija na trenutno aktivni kanal, dolocen v CAN 0x21F msg (limite) - v konzoli odstranjena možnost vk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
    - nova verzija STM32CubeMX V5.0.1
    - nova verzija STM32Cube FW_F4 V1.23.0
    [SkyPulse.ioc, cli.cpp, dl.cpp, dl.h, ffconf.h, main.c, main.h, term.h]
2019-01-31 V 0.29 Jan 30 2019 <6ED63AD6> - bug pri sinhronizaciji ref. signala pri dvokanalni diodi; sinhronizacija na trenutno aktivni kanal, dolocen v CAN 0x21F msg (limite) - v konzoli odstranjena možnost vk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
    - STM32CubeMX Version 5.0.1
    - STM32Cube FW_F4 V1.23.0
2019-08-28 - V 1.00 Aug 27 2019 <CFF31952> - hitrejši vklop pumpe (ms ni vec deljena) - izpih ročnika, aktiviran s voda/zrak ff/ff
2019-10-01 v 1.01 Oct 1 2019 <4931597B> - error state ne sprazni flaše - pump_drive se lahko spreminja samo ce razlicen od 0; indikator za Enabled/Disabled !!!
    [ioc.cpp, main.h, pump.cpp]
2020-02-27 V 1.01 Feb 27 2020 <91556DEB>
    - pump diagnostics delay modified
2020-03-11 v 1.01 Feb 27 2020 <91556DEB>
    - pump diagnostics startup delay modified to 6 sec
    - pump temp. characteristics modified to 20%-50%, 34-35 degC (setup only)
2020-05-14 - fan boost & 60' is back :)
2020-06-01 V 1.03 Jun 1 2020 <935A4FB3>
    1) diode adc meter selftest, CAN messages modified:
    - testiranje DL signalov se izvede 200 ms po restartu
    - rezultat je enabled / disabled, disabled pomeni da dioda ni zaznana, kar lahko primerjaš na SYS s svojim pinganjem DL
    - rezultat dobi sys z novim ukazom 0x205, odgovor je 0x245 in dodatni byte 0x00 (disabled) ali 0x01 (enabled)
    - ce vsebuje 0x205 dodatni byte 0x01, to pomeni zahtevo za ponovno testiranje (predvidoma samo v STANDBY !!!... ne morem testirat brez HW) odgovor dobiš v cca 200ms, v tem casu IOC ne odgovarja na CAN.
    - vkolikor test ugotovi neveljaven odziv (konstanten nivo samo na eni ali drugi liniji), vrže ven z error 18 ali 19
    2) FAN bo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
    [adc.cpp, adc.h, dl.cpp, ioc.cpp]
2020-06-03 V 1.03 Jun 3 2020 <85A3BAF6>
    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
    [Simulator.cpp, simulator.h, spray.cpp, spray.h]
2020-06-19 ... float sensor
2020-06-22 V 1.03 Jun 22 2020 <8534EB6C>
    1) diode engmeter selftest, CAN messages modified:
    2) FAN boo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
    [94330_SKYPULSE IOC_V1.2.SchDoc, 94330_SKYPULSE IOC_V1.3.SchDoc]
2020-07-02 V 1.04 Jul 2 2020 <C57EC859> - spr. diodni energ. aktivno stanje definirano z EMIT(od SYS) plus diode.mode(od DL) :/
2020-07-16 v 1.05 Jul 15 2020 <3E54F7B7>
    - footswitch plugin error removed
    - new colour set for 670nm diode added in subdir
    - format & setup file create on filesystem error
2020-09-04 - STM32Cube_FW_F4_V1.25.0 - CubeMX V5.6.1
    - V106, HW V2, version detect
2020-09-07 - aktiviran float error, v odv. od hw version
    [main.c, pump.cpp]
2020-09-15 V 1.06 Sep 15 2020 <0271DCD0>, HW V2
    - STM32Cube FW_F4 V1.25.0, CubeMX 6.0.1
    - pump.Disable() se premakne iz pump::Status to IOC::Set>State
    razlog: na prejšnjem mestu ni bilo mogoce maskirati zaustavitve pumpe ampak zgolj error stanje oz. izpis
    - uvedena. max. vrednost za Ipump v int. 100ms; predhodno odbiranje na 100ms je preskakovala pulzirajoce max. pri zaprtem vofokrogu
    - preizkušena distrib. fsw
    [SkyPulse.ioc, ffconf.h, ioc.cpp, main.c, pump.cpp, pump.h, user_diskio.c]
2020-10-13 ... DL control, dodatni filter za signal napake
2020-10-23 - hardfault handler - pump, fan modif. warning behaviour
2020-12-22 - DL timer support - TODO: CW support
2020-12-23 - DL message, timer support - DL console, show avg & err per ADC channel
2021-01-06 - bug remov. - 0x21f message
    [dl.cpp, dl.h]
2021-01-13 V 1.06 Jan 13 2021 <C01A0B96> CW bug removed
    [dl.cpp, dl.h]
2021-02-15 V 1.06 Feb 9 2021 <98E6F21D>
    I-10611, S-2024
    I-10397, S-1975
    I-10295, S-1949
    - _IOC & _SPRAY class constructor defaults
    - spray air/water range modified
    - float switch, HW coding, DL tandem functionality & HW support
    - HW backward compatible
    - foot switch bugs removed
2021-04-15 - fsw2DL added to DL calibration mode
2021-07-15 - bug on pump diagnostics
    [pump.cpp]
2022-01-12 v 1.10 Jan 7 2022 <BC70EF87>, HW V1 - aux message, dodan PumpCurrent
2022-02-14 v 1.10 Jan 7 2022 <BC70EF87>, HW V1 I-12436, S-2420 aux message, dodan PumpCurrent
2022-02-18 rlh added to schematics folder
2022-12-20 v 1.12 Nov 17 2022 <FFD4314F> I-12560
    - dl pump error delay nazaj na 3 sec
    - ob vstopu v EMIT, polling delay glede na izbran izvor (DL or EC20)
    - izpis hw verzije podaljšan na 5 bitov
    [can.cpp, dl.cpp, dl.h, err.h, ioc.cpp, ioc.h, main.c, main.h]
