yallawalla/SkyPulseIOC/(notices)

Notices in the files:
CubeMx/Inc/ffconf.h:
Copyright (c) 2019 STMicroelectronics International N.V.
All rights reserved.
